moahrs/MMSJ300OS/root_sdcard.png

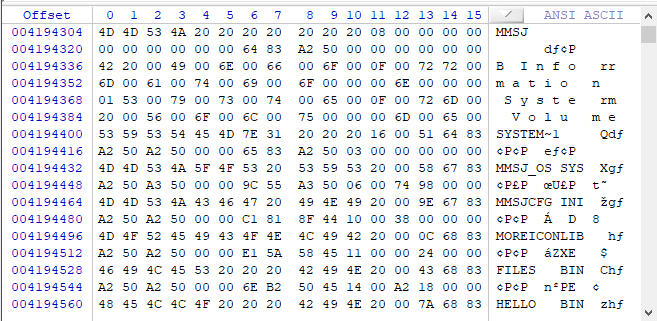
root_sdcard.png
