moahrs/MMSJ300OS/utility.bmp

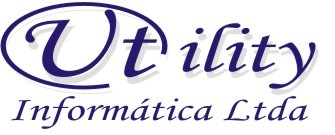
utility.bmp
