moahrs/MMSJ300OS/diptrace/DipTrace_Schematic_MMSJ300B_CPU_MEM_PERIF_V2_Page1.pdf

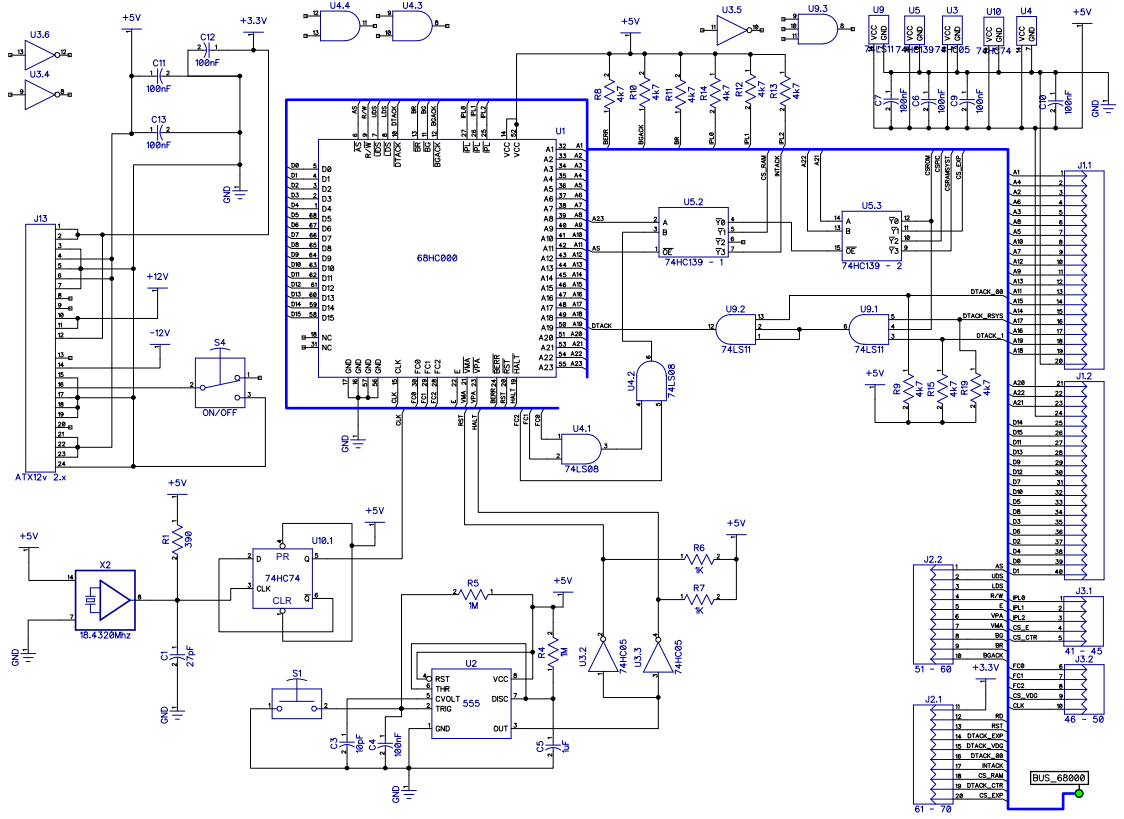
[picture p3: page 1]
CLR
