moahrs/MMSJ300OS/diptrace/DipTrace_Schematic_MMSJ300B_CPU_MEM_PERIF_V2_Page2.pdf

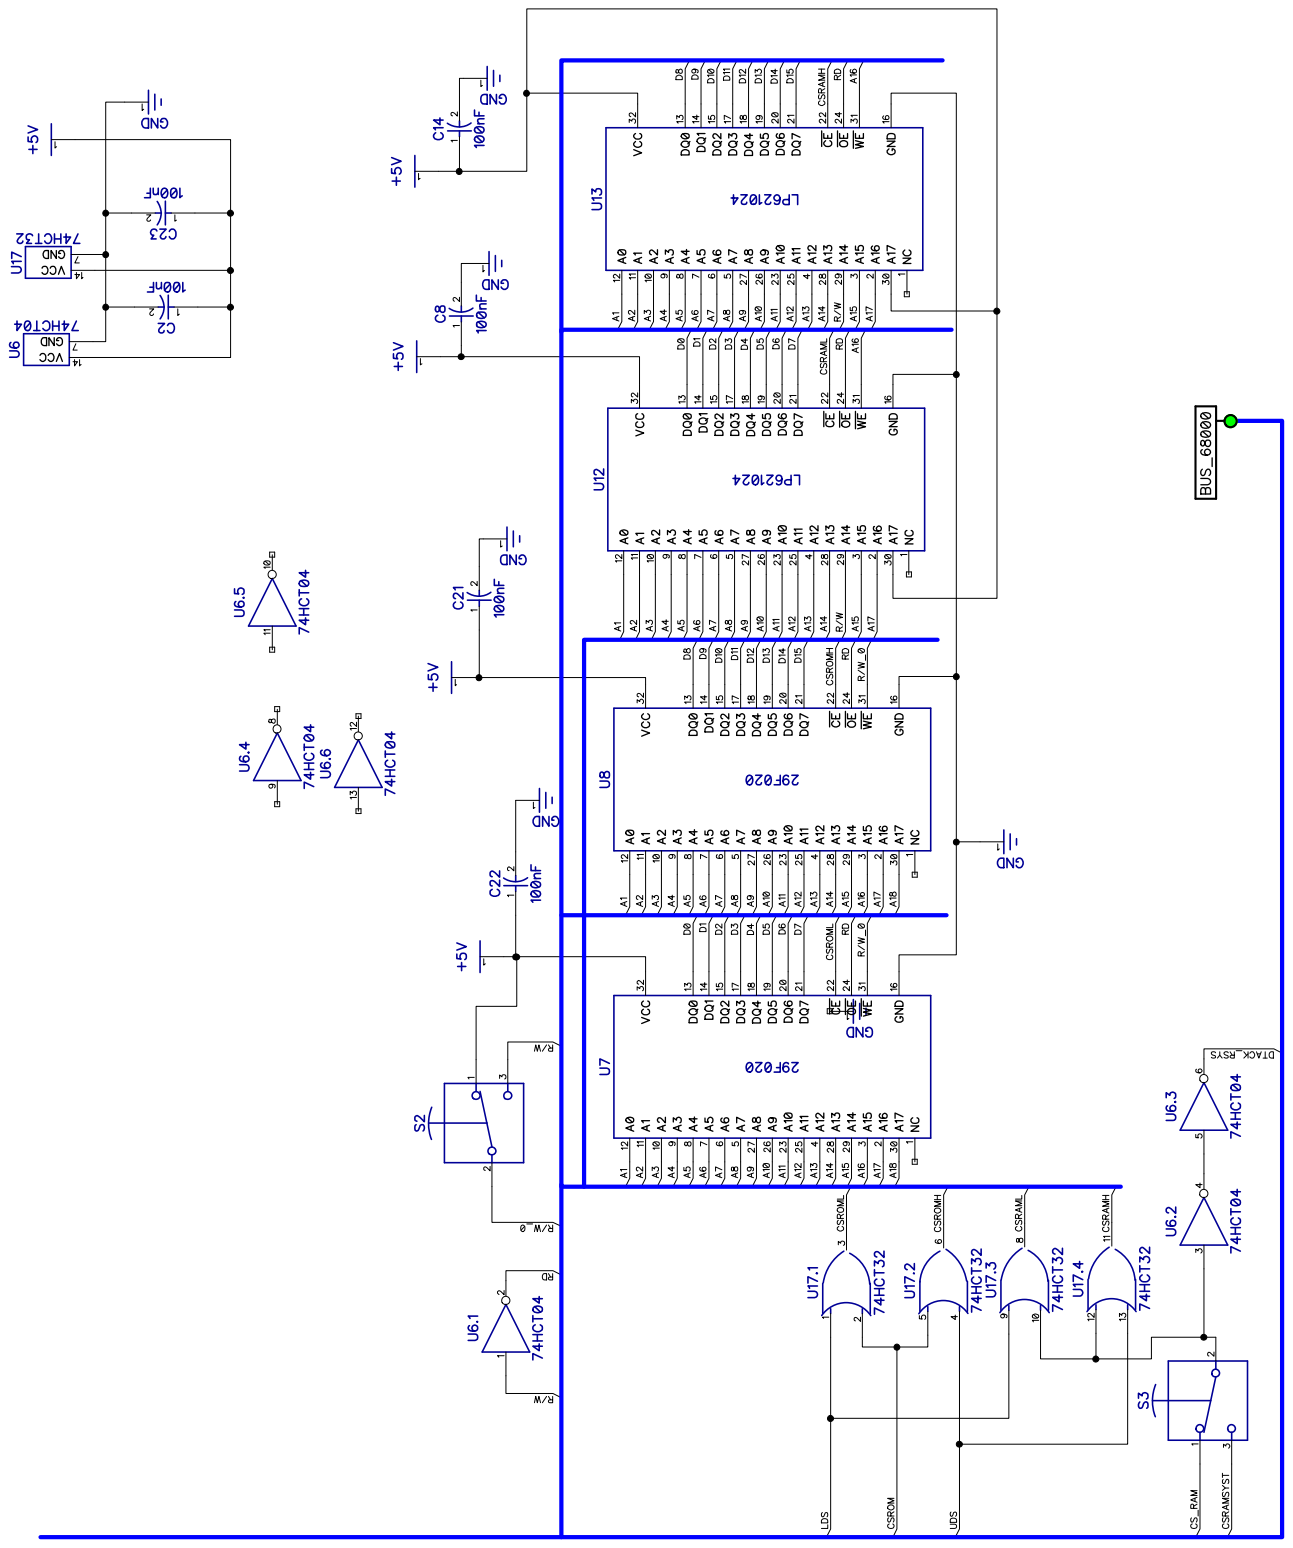
[picture p4: page 1]
