moahrs/MMSJ300OS/diptrace/DipTrace_Schematic_MMSJ300B_PERIF_V2_Page1.pdf

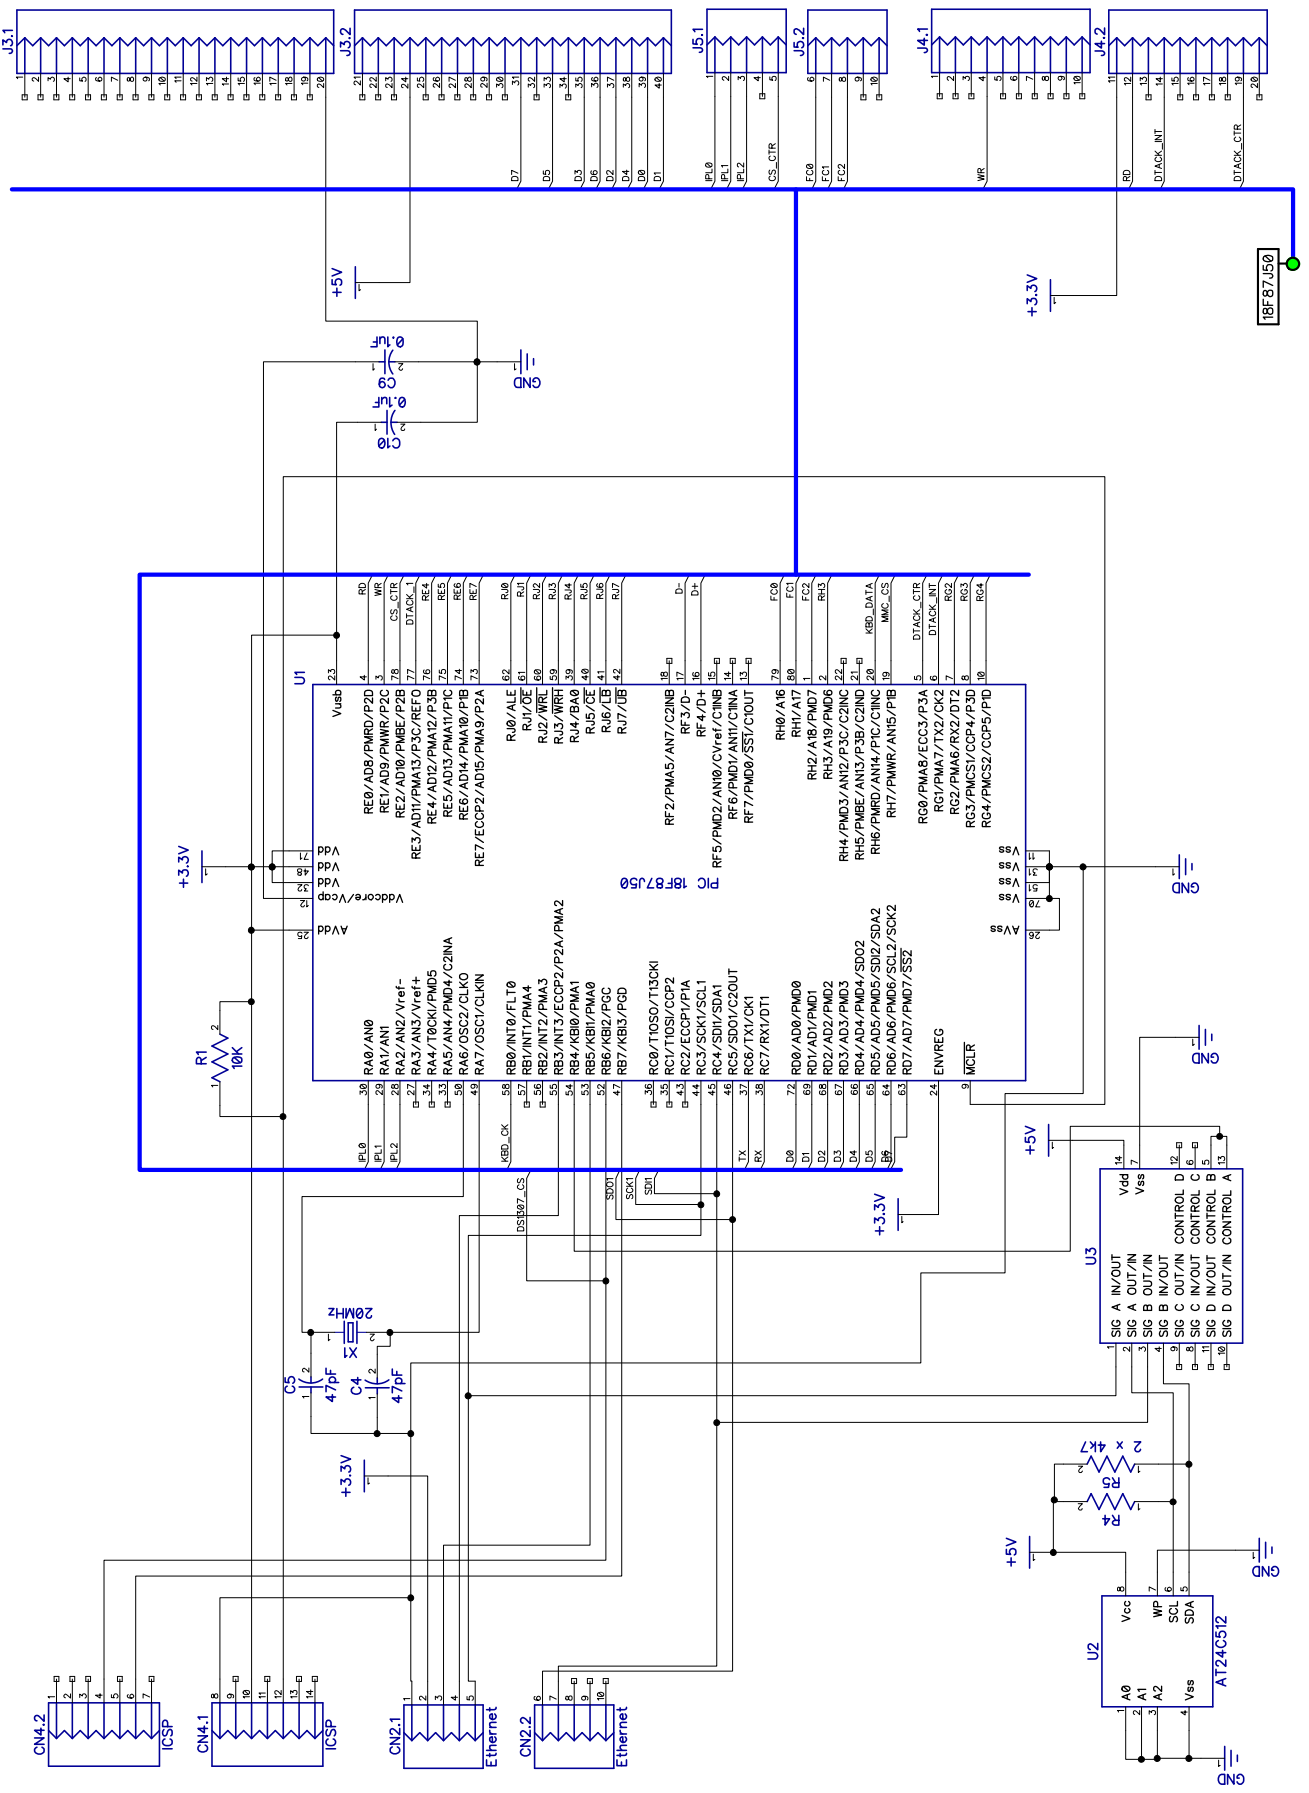
[picture p6: page 1]
