moahrs/MMSJ300OS/diptrace/DipTrace_Schematic_MMSJ300B_PERIF_V2_Page2.pdf

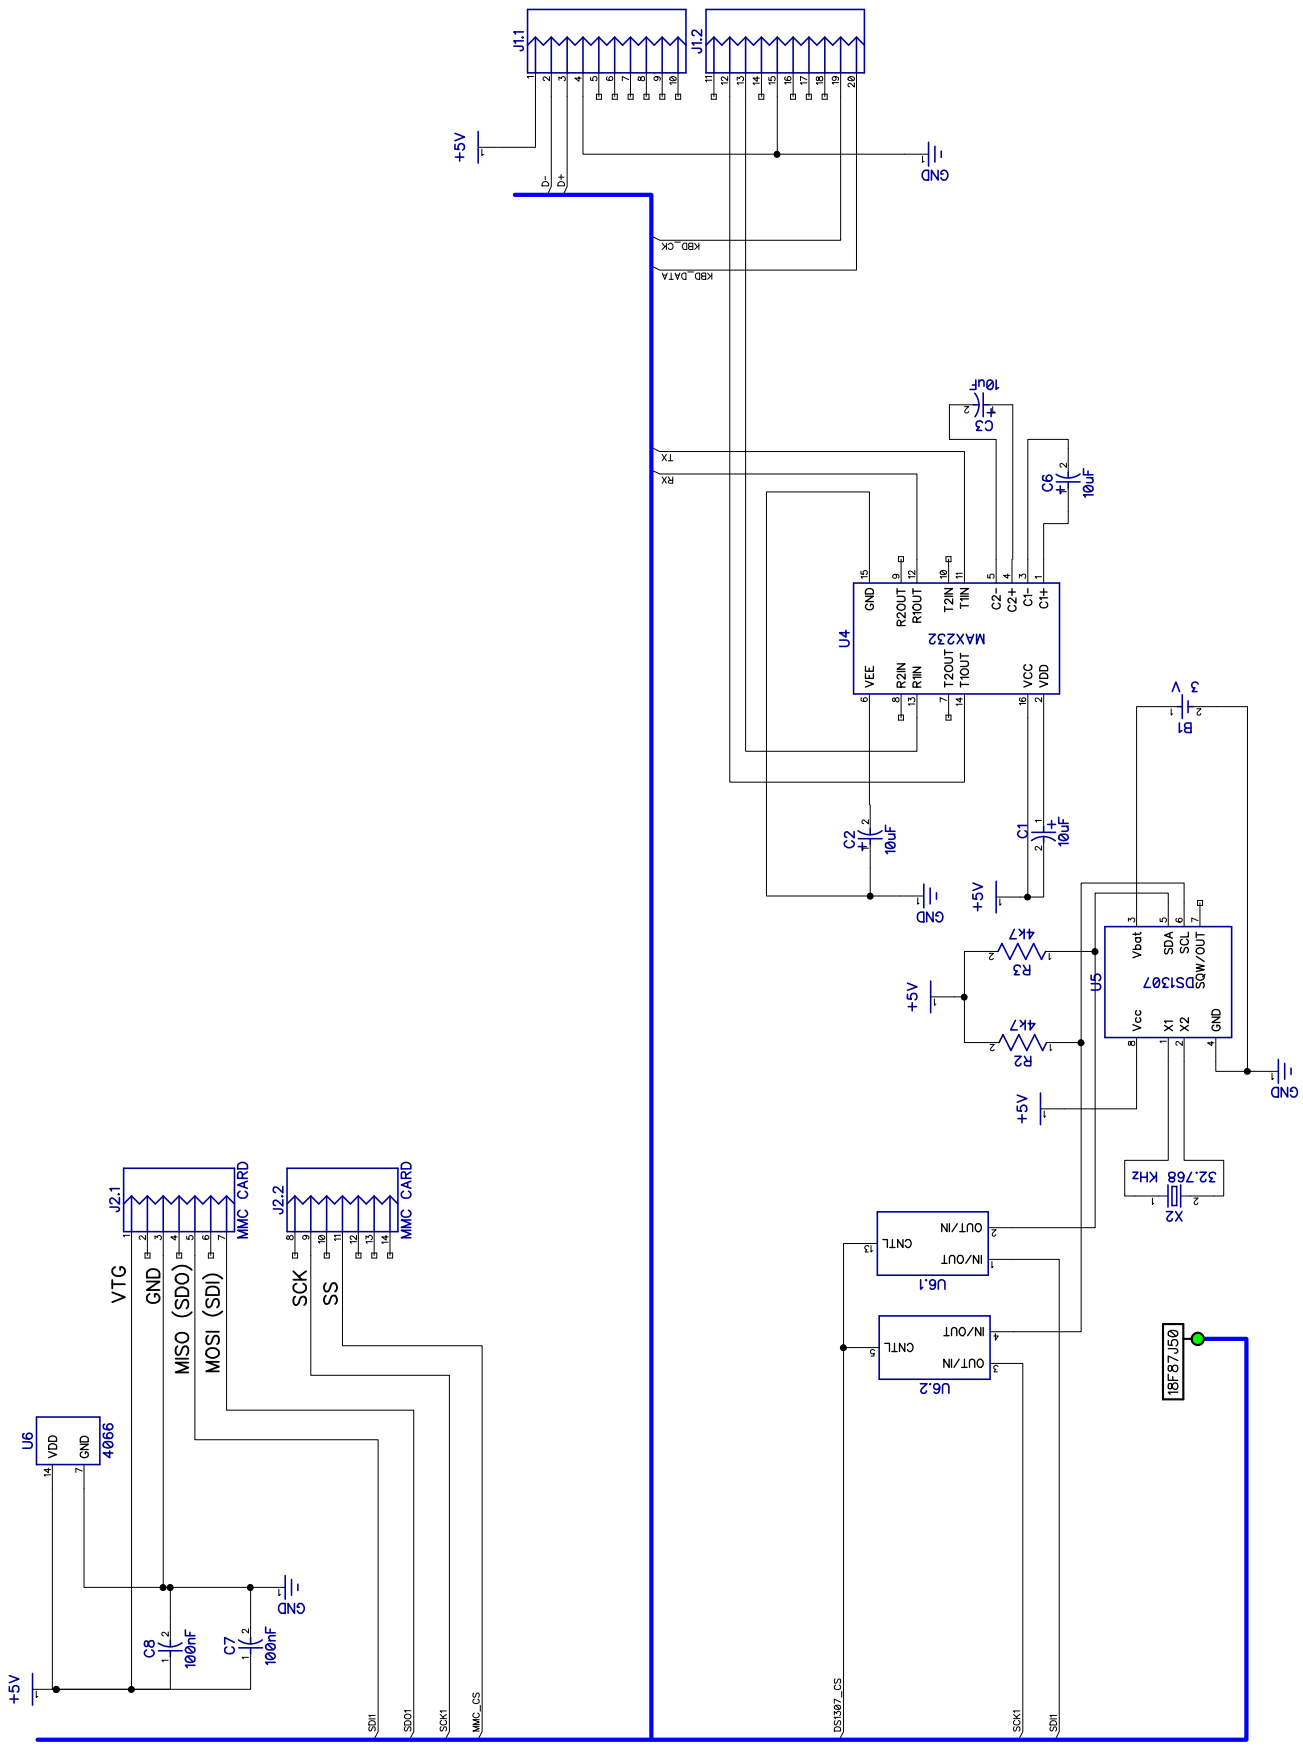
[picture p7: page 1]
