moahrs/MMSJ300OS/diptrace/DipTrace_Schematic_MMSJ300B_VDG_4550.pdf

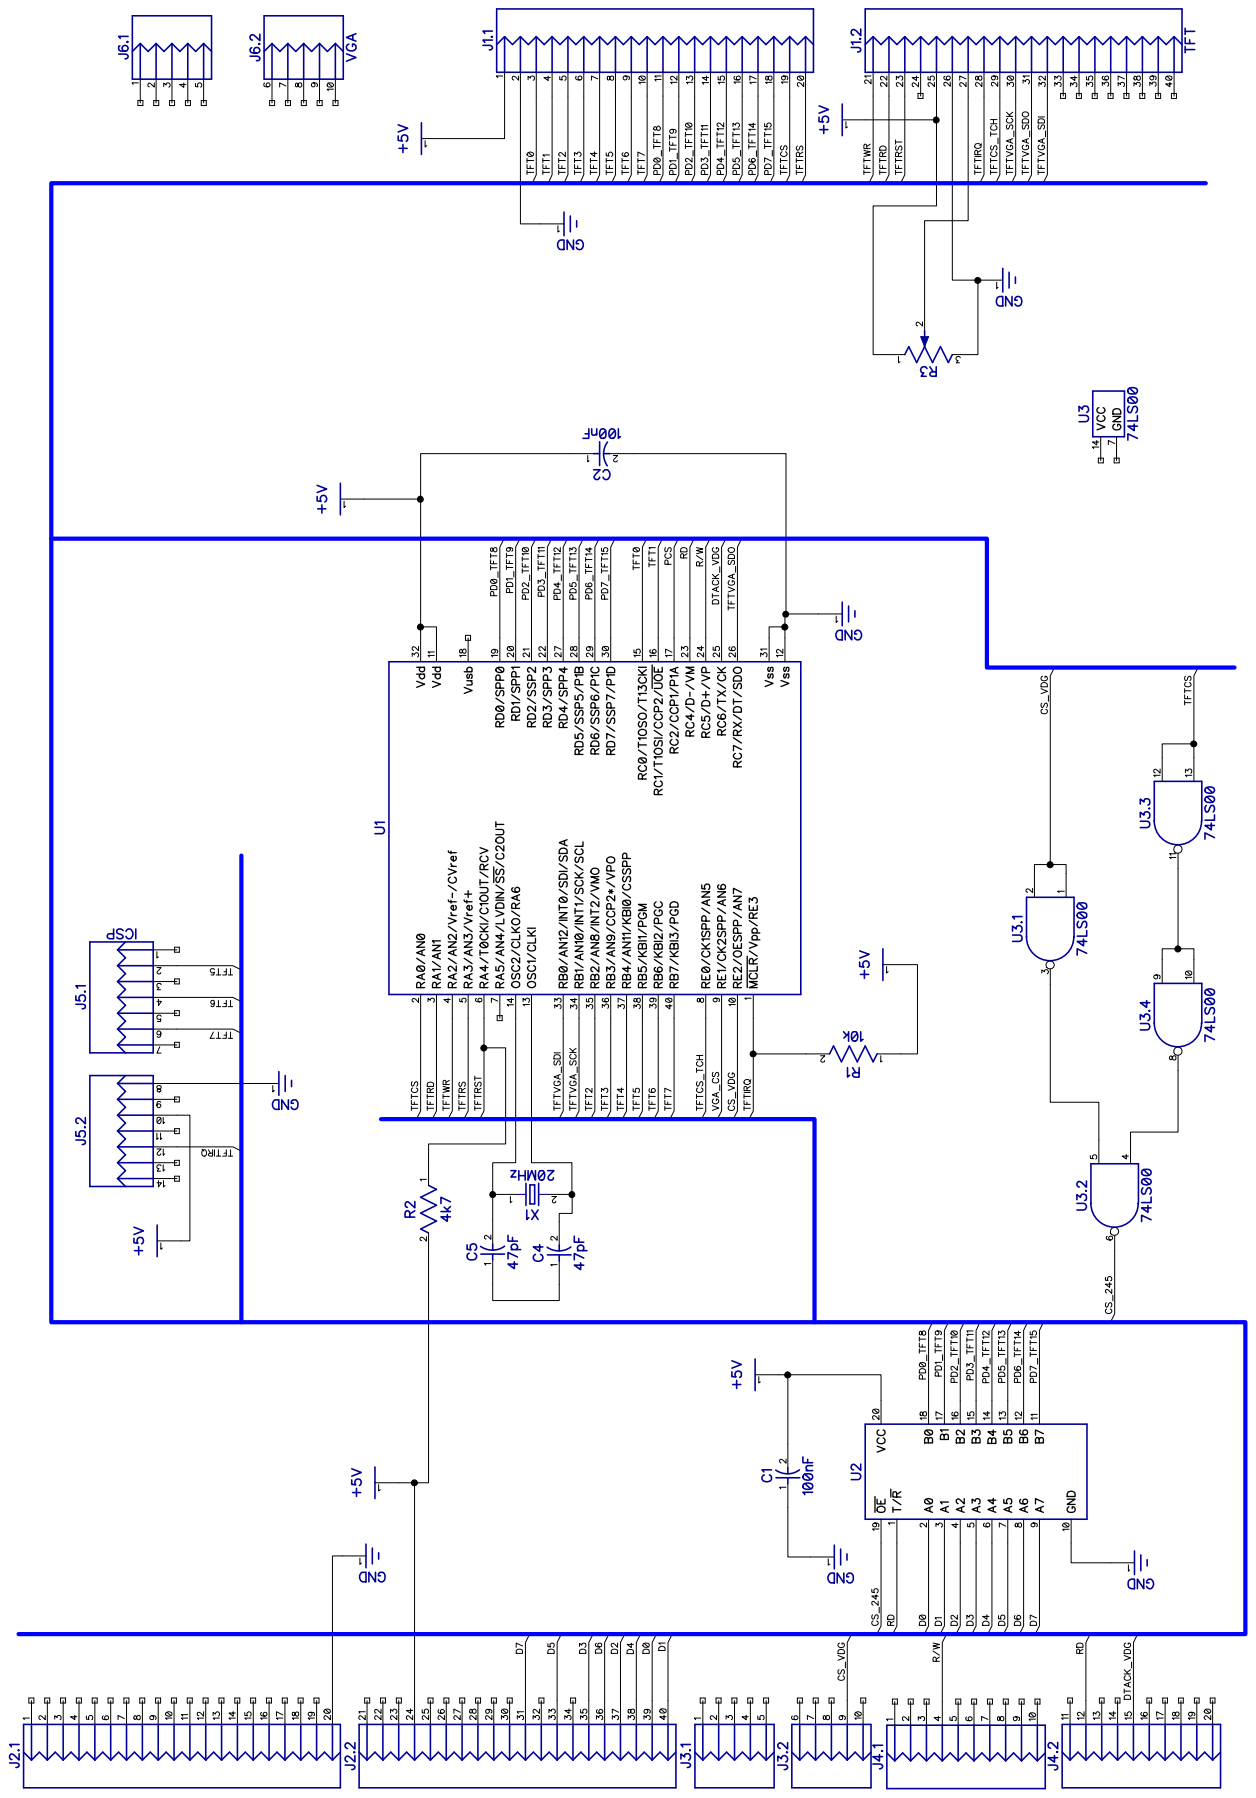
[picture p8: page 1]
