moahrs/MMSJ300OS/diptrace/GRAVADOR_FLASH_EEPROM_SERIAL.pdf

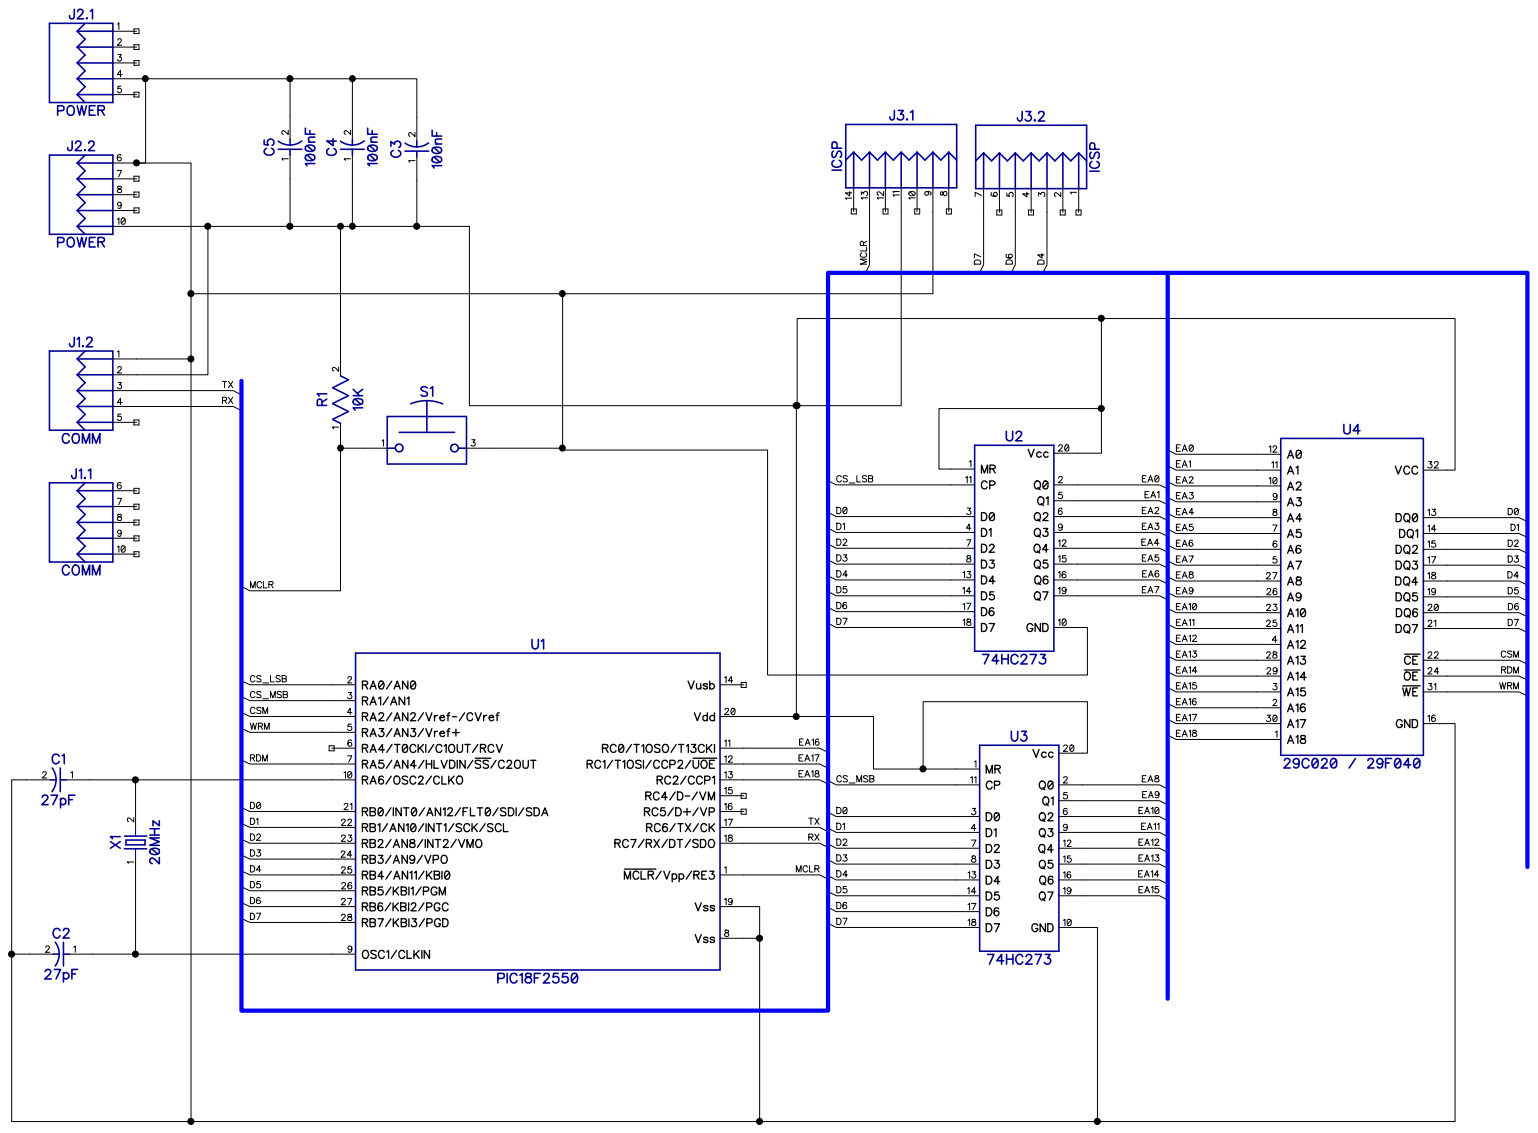
[picture p9: page 1]
