moahrs/MMSJ300OS/diptrace/MMSJ300B_MEM_RAM_DYNAMIC.pdf

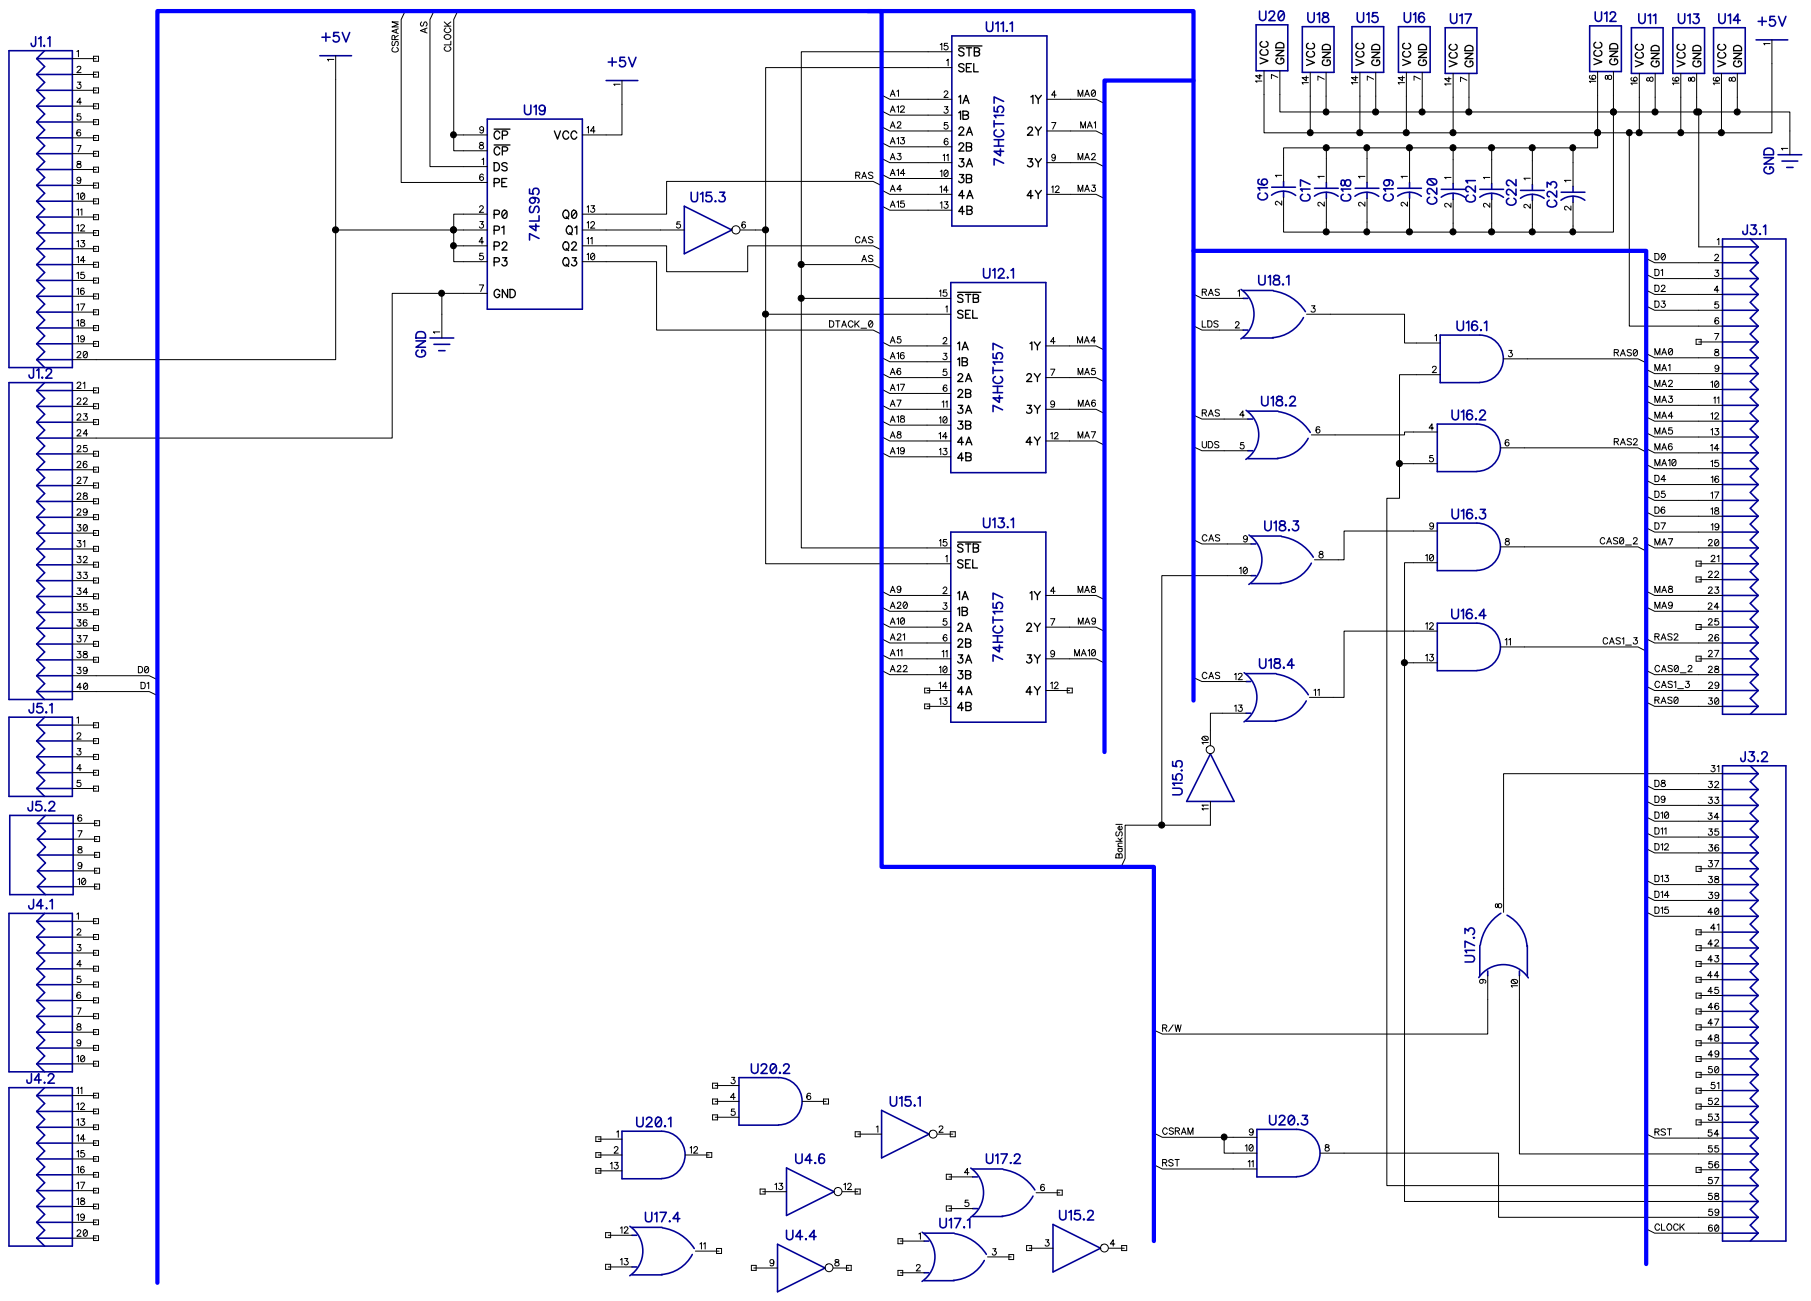
[picture p10: page 1]
