moahrs/MMSJ300OS/diptrace/MMSJ300B_PERIF_COMM.pdf

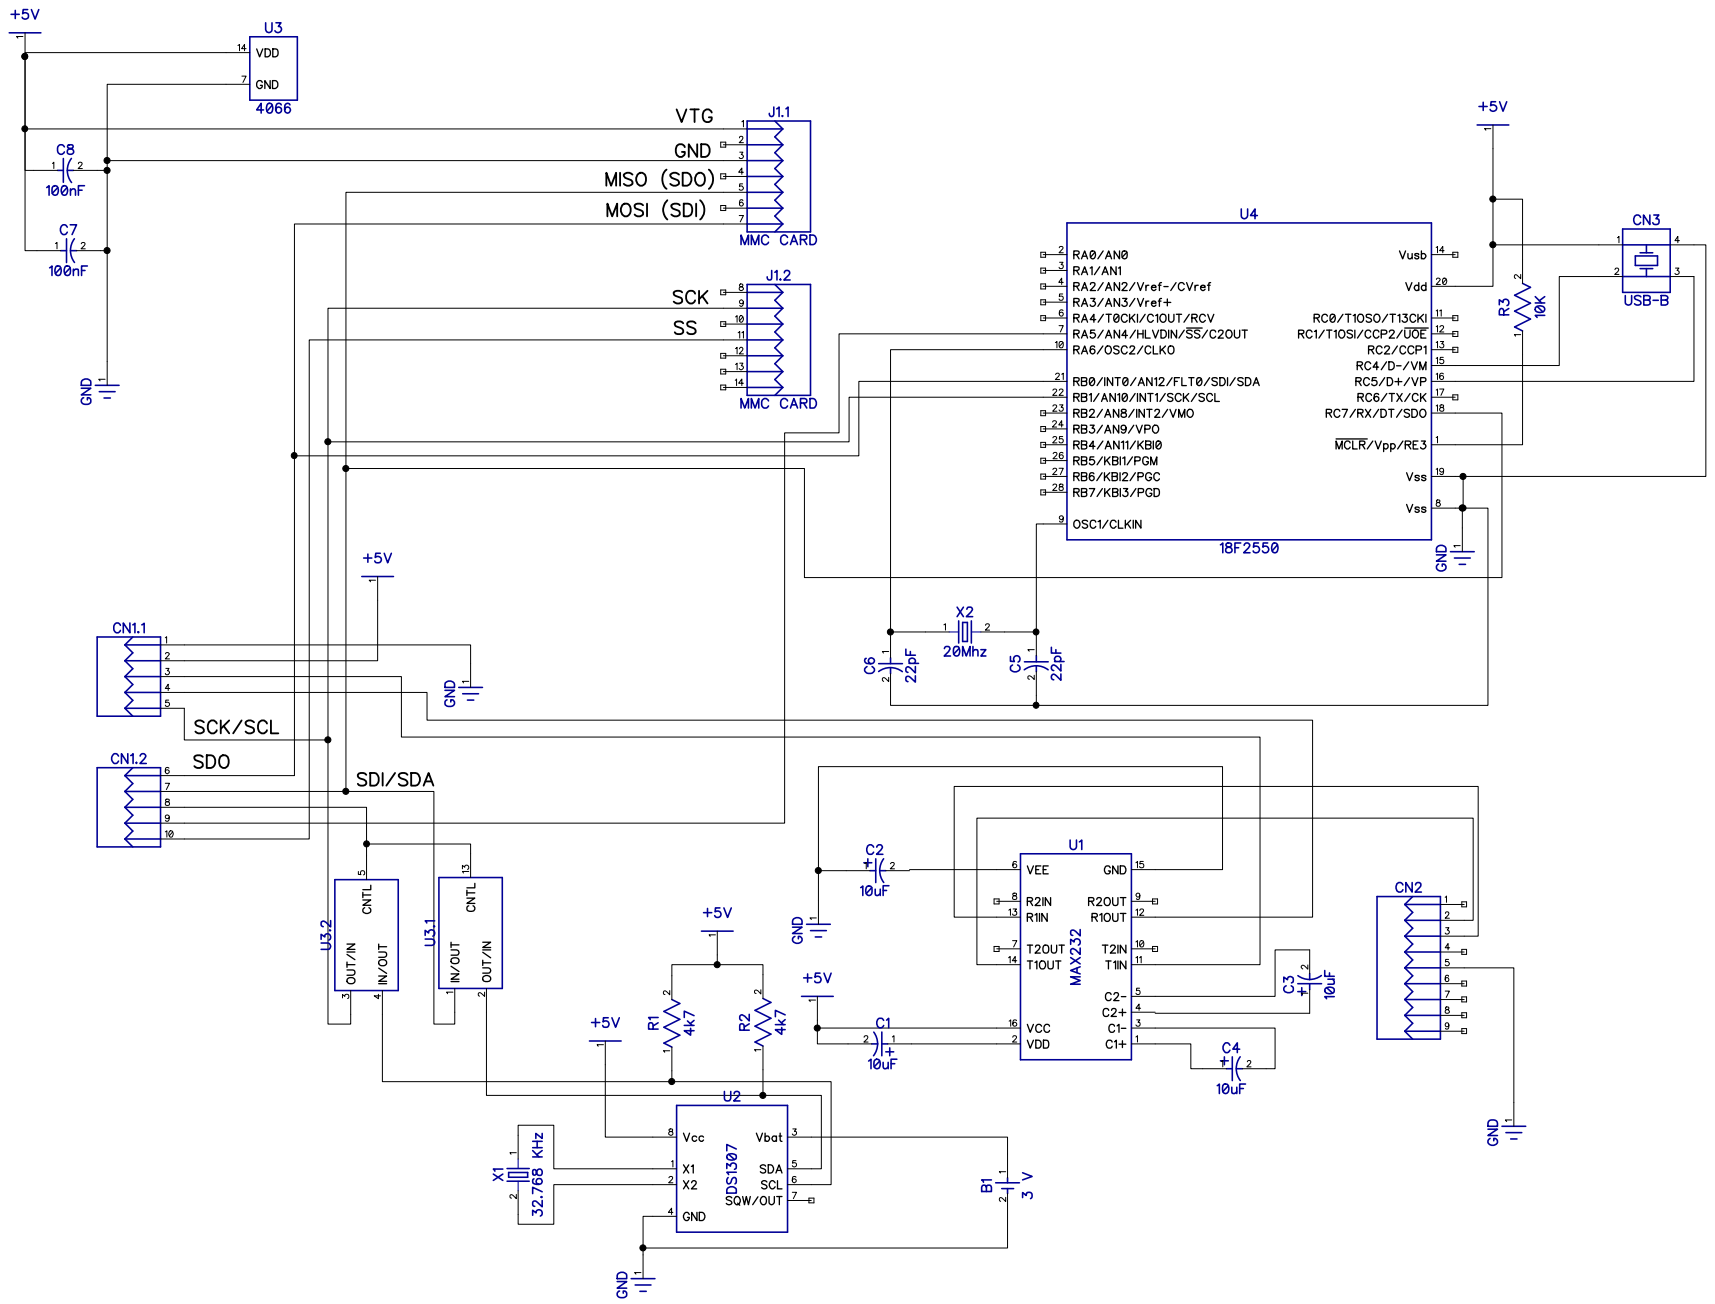
[picture p11: page 1]
