moahrs/MMSJ300OS/diptrace/MMSJ300B_PERIF_VDG.pdf

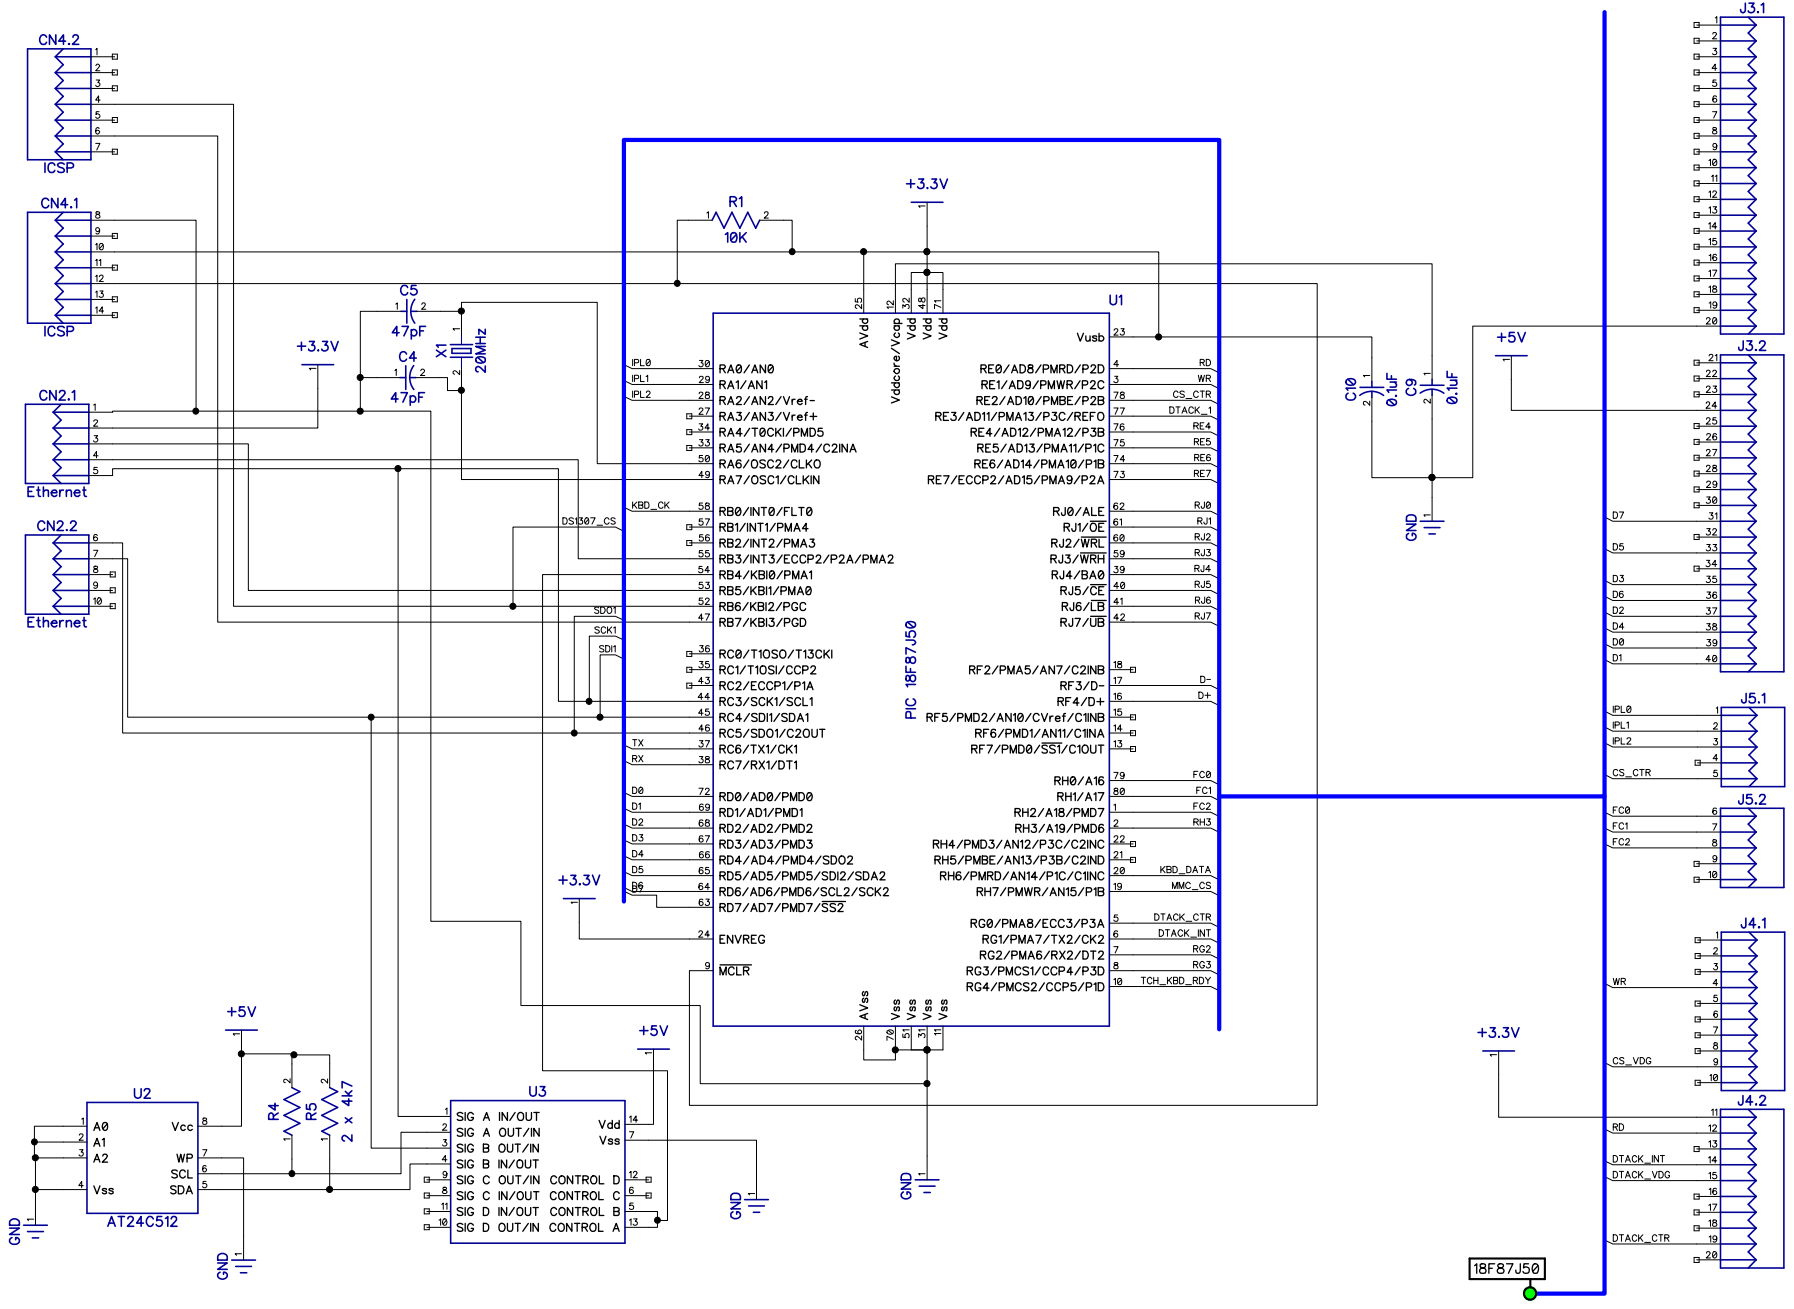
[picture p12: page 1]

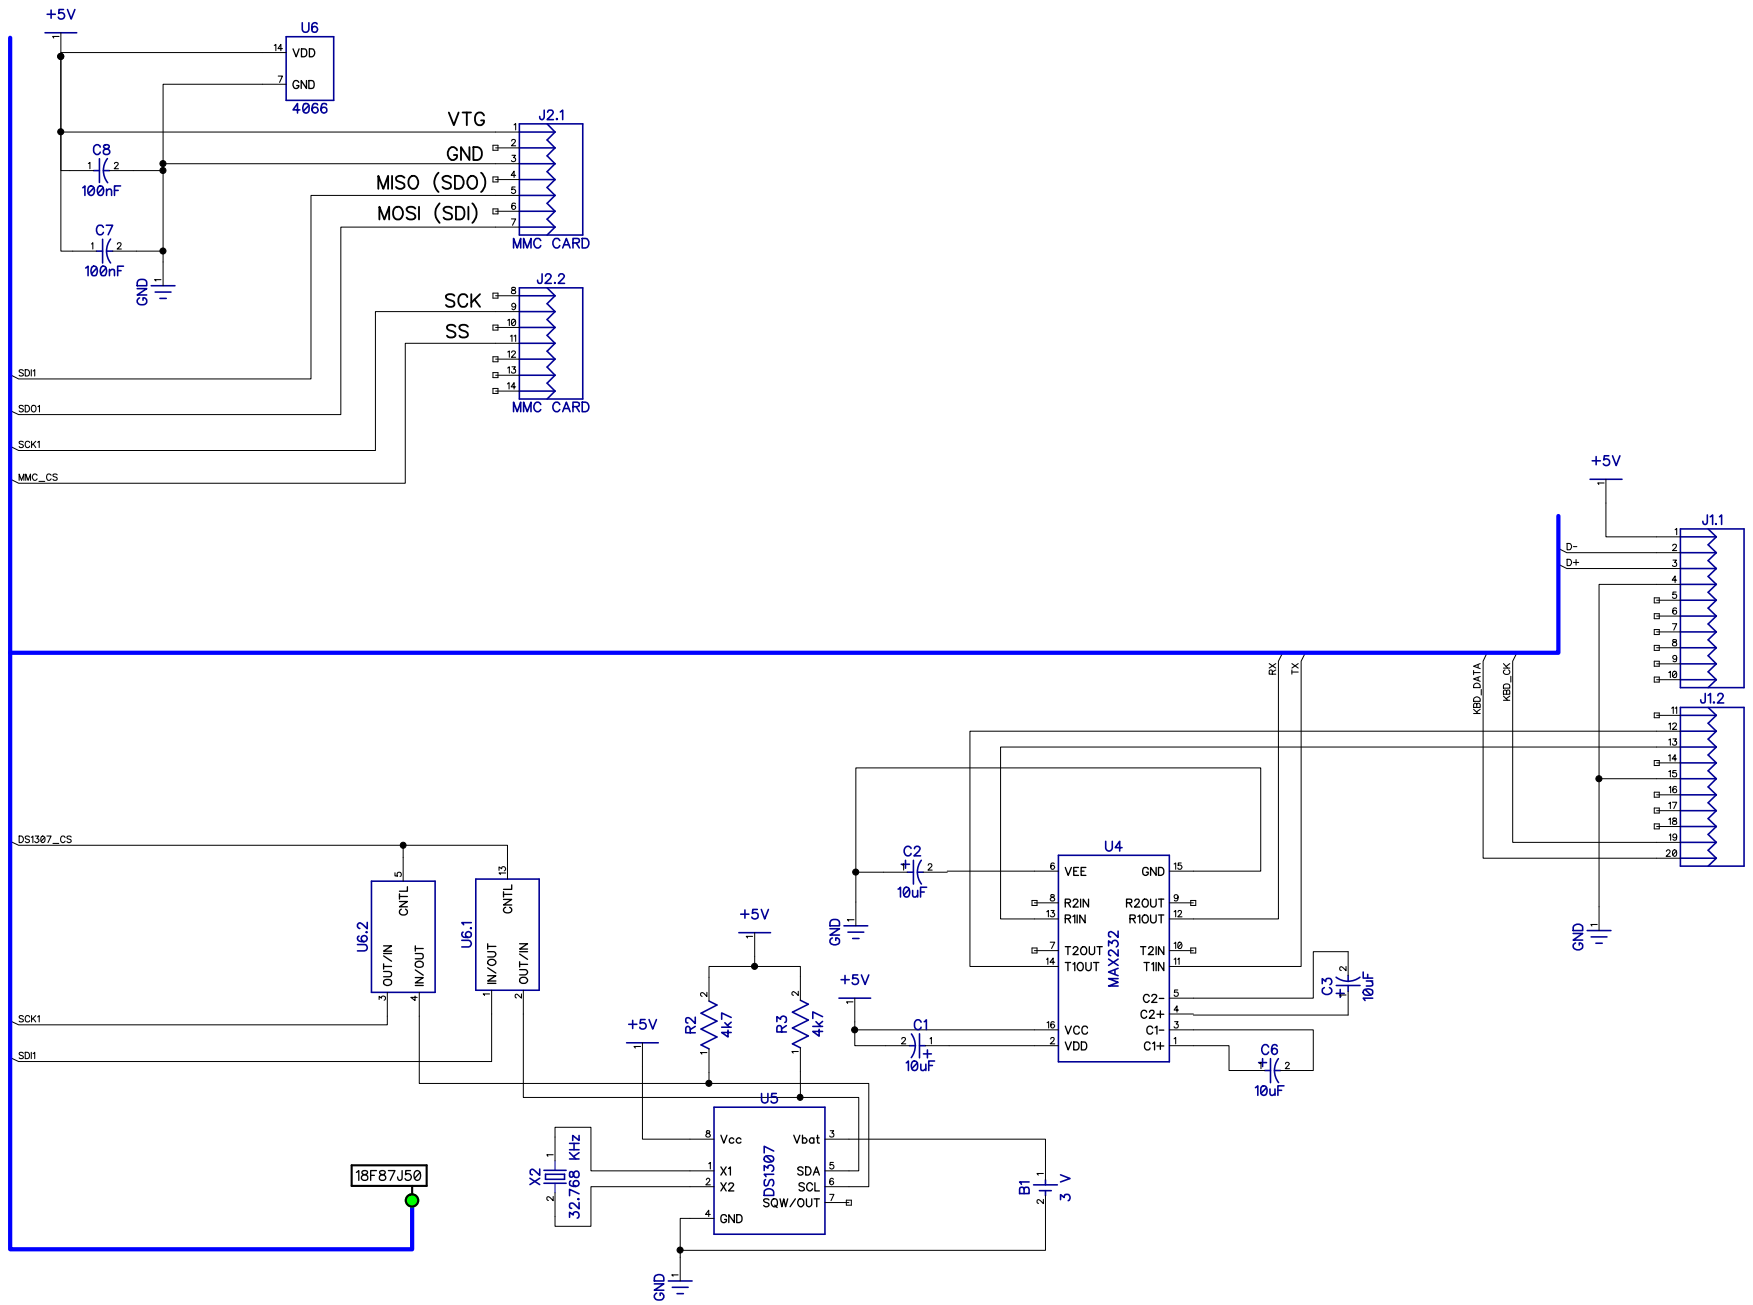
[picture p13: page 2]

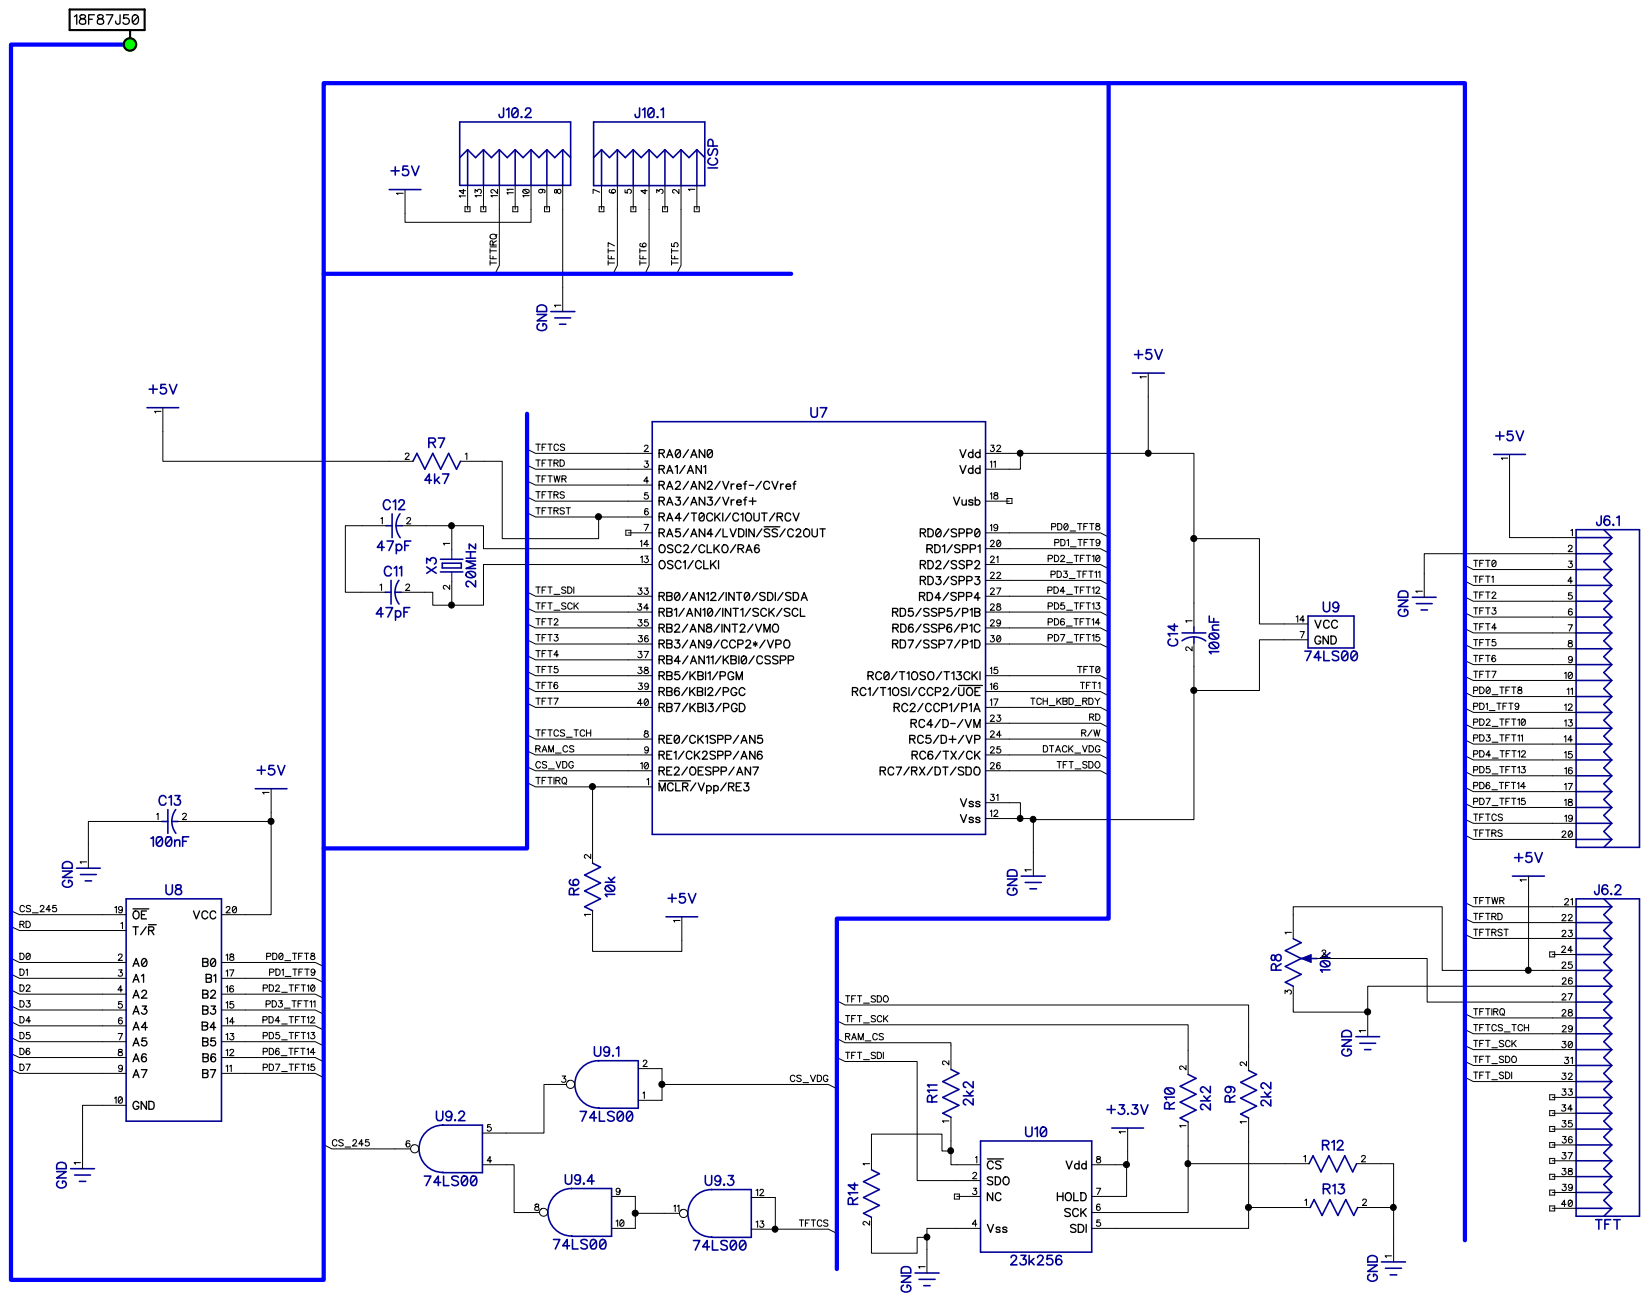
[picture p14: page 3]
