moahrs/MMSJ300OS/(list of files, drawings)

Other design files:
diptrace/GRAVADOR_FLASH_EEPROM_SERIAL.dch
diptrace/GRAVADOR_FLASH_EEPROM_SERIAL.dip
diptrace/MMSJ300_COMM.dch
diptrace/MMSJ300_CPU_MEM.dch
diptrace/MMSJ300_CPU_MEM.dip
diptrace/MMSJ300_CPU_MEM_2.dip
diptrace/MMSJ300_PERIF.dch
diptrace/MMSJ300A_CPU.dch
diptrace/MMSJ300A_MEM_RAM_STATIC.dch
diptrace/MMSJ300A_MEM_ROM.dch
diptrace/MMSJ300A_PERIF.dch
diptrace/MMSJ300B_CPU_MEM_PERIF.dch
diptrace/MMSJ300B_CPU_MEM_PERIF.dip
diptrace/MMSJ300B_CPU_MEM_PERIF_V2.dch
diptrace/MMSJ300B_MEM_RAM_DYNAMIC.dch
diptrace/MMSJ300B_MEM_RAM_DYNAMIC.dip
diptrace/MMSJ300B_PERIF.dch
diptrace/MMSJ300B_PERIF_COMM.dch
diptrace/MMSJ300B_PERIF_V2.dch
diptrace/MMSJ300B_PERIF_V2_duplaface.dip
diptrace/MMSJ300B_PERIF_V2_duplaface_87j50.dip
diptrace/MMSJ300B_PERIF_V2_duplaface_8722.dip
diptrace/MMSJ300B_PERIF_V2_simplesface.dip
diptrace/MMSJ300B_PERIF_VDG.dch
diptrace/MMSJ300B_PERIF_VDP_6847.dch
diptrace/MMSJ300B_PERIF_VDP_6847.dip
diptrace/MMSJ300B_PERIF_VDP_6847_SFace.dip
diptrace/MMSJ300B_PERIF_VDP_6847_V2.dch
diptrace/MMSJ300B_VDG_4550.dch
diptrace/MMSJ300B_VDG_4550_duplaface.dip
diptrace/MMSJ300B_VDG_4550_simplesface.dip
diptrace/OLD/MMSJ300_CPU_MEM.dch
diptrace/OLD/MMSJ300_CPU_MEM.dip
diptrace/OLD/MMSJ300_CPU_MEM_2.dip
diptrace/OLD/MMSJ300_PERIF.dch
diptrace/OLD/MMSJ300A_CPU.dch
diptrace/OLD/MMSJ300A_MEM_RAM_STATIC.dch
diptrace/OLD/MMSJ300A_MEM_ROM.dch
diptrace/OLD/MMSJ300A_PERIF.dch
diptrace/OLD/MMSJ300B_CPU.dch
diptrace/OLD/MMSJ300B_CPU_MEM_PERIF.dip
diptrace/OLD/MMSJ300B_MEM_RAM_STATIC.dch
diptrace/OLD/MMSJ300B_MEM_ROM.dch
diptrace/TrabElet2.dch
diptrace/TrabElet2.dip
