moahrs/MMSJ300OS/monitor.c

/********************************************************************************
*    Programa    : monitor.c
*    Objetivo    : BIOS do modulo MMSJ300 - Versao vintage compatible
*    Criado em   : 17/09/2022
*    Programador : Moacir Jr.
*--------------------------------------------------------------------------------
* Data        Versao  Responsavel  Motivo
* 17/09/2022  0.1     Moacir Jr.   Criacao Versao Beta
*                                  512KB EEPROM + 256KB RAM BUFFER + 8MB RAM USU
* 12/11/2023  0.2     Moacir Jr.   Adaptacao do MC68901 p/ serial e interrupcoes
* 01/06/2023  0.3     Moacir Jr.   Adaptacao do teclado PS/2 via arduino nano
*                                  Simulando um FPGA de epoca
* 22/06/2023  0.4     Moacir Jr.   Adaptacao do TMS9118 VDP
* 23/06/2023  0.4a    Moacir Jr.   Adaptacao lib arduino tms9918 pro mmsj300
* 15/07/2023  0.4b    Moacir Jr.   Colocar tela vermelha de erros
* 15/07/2023  0.4c    Moacir Jr.   Colocar rotina de trace
* 18/07/2023  0.4d    Moacir Jr.   Verificar e Ajustar Problema no G2 do VDP
* 19/07/2023  1.0     Moacir Jr.   Versao para publicacao
* 20/07/2023  1.0a    Moacir Jr.   Ajuste de bugs
* 21/07/2023  1.1     Moacir Jr.   Adaptar Basic ao monitor
* 25/07/2023  1.1a    Moacir Jr.   Ajustes no inputLine, aceitar tipo '@'
* 20/01/2024  1.1b    Moacir Jr.   Iniciar direto no basic... Ai com QUIT, volta pro monitor
*--------------------------------------------------------------------------------
*
* Mapa de Memoria
* ---------------
*
*     SLOT 0                          SLOT 1
* +-------------+ 000000h
* |   EEPROM    |
* |   512KB     |
* |   (BIOS)    | 07FFFFh
* +-------------+ 080000h
* |    LIVRE    | 1FFFFFh
* +-------------+ 200000h
* |             |
* |  EXPANSAO   |
* |             | 3FFFFFh
* +-------------+ 400000h
* |             |
* | PERIFERICOS |
* |             | 5FFFFFh
* +-------------+ 600000h
* |  RAM 256KB  |
* |  BUFFER E   |
* |  SISTEMA    | 63FFFFh
* +-------------+ 640000h
* |    LIVRE    | 7FFFFFh
* +-------------+ 800000h
* |             |
* |   ATUAL     |
* |    RAM      |
* |  USUARIO    |
* |    1MB      | 8FFFFFh
* +-------------+ 900000h
* |             |
* |             |
* |    RAM      |
* |  USUARIO    |
* |    7MB      |
* |             |
* |             |
* |             |
* |             |
* |             |
* |             |
* |             |
* |             |
* +-------------+ FFFFFFh
*--------------------------------------------------------------------------------
*
* Enderecos de Perifericos
*
* 00400020h a 0040003F - MFP MC68901p
*                        - SERIAL 9600, 8, 1, n
*                        - TECLADO (PC-AT - PS/2) via Arduino Nano
*                        - Controle de Interrupcoes e PS/2
* 00400040h a 00400043 - VIDEO TMS9118 (16KB VRAM):
*             00400041 - Data Mode
*             00400043 - Register / Adress Mode
********************************************************************************/

//#define __FS12__ 1

#include <ctype.h>
#include <string.h>
#include <stdlib.h>
#include "mmsj300api.h"
#include "monitor.h"

#ifdef __FS12__
#include "monitorf.h"
#endif

#define versionBios "1.1b"

//-----------------------------------------------------------------------------
// Principal
//-----------------------------------------------------------------------------
void main(void)
{
    unsigned short *xaddr = (unsigned short *) 0x00600000;
    unsigned short vbytepic = 0, xdado;
    unsigned int ix = 0, xcounter = 0;
    unsigned char sqtdtam[10], vRetInput;
    unsigned char vRamSyst1st = 1, vRamUser1st = 1;
    int vRetProcCmd;

    // Inicia com Basic
    *startBasic = 1;

    // Tempo para Inicializar a Memoria DRAM (se tiver), Perifericos e etc...
    for(ix = 0; ix <= 12000; ix++);

    //---------------------------------------------
    // Enviar setup para o MFP 68901
    //---------------------------------------------
    *vBufXmitEmpty = 1;

    // Setup Timers
    *(vmfp + Reg_TCDR)  = 0x02;
    *(vmfp + Reg_TDDR)  = 0x02;
    *(vmfp + Reg_TCDCR) = 0x11;

    // Setup Interruptions
    *(vmfp + Reg_VR)    = 0xA8; // vector = 0xA msb = 0x1010 and lsb = 0x1000 software end session interrupt
    *(vmfp + Reg_IERA)  = 0x00; // disable all at start
    *(vmfp + Reg_IERB)  = 0x00; // disable all at start
    *(vmfp + Reg_IMRA)  = 0x00; // disable all at start
    *(vmfp + Reg_IMRB)  = 0x00; // disable all at start
    *(vmfp + Reg_ISRA)  = 0x00; // disable all at start
    *(vmfp + Reg_ISRB)  = 0x00; // disable all at start

    // Setup Serial = 9600, 8, 1, n
    *(vmfp + Reg_UCR)   = 0x88;
    *(vmfp + Reg_RSR)   = 0x01;
    *(vmfp + Reg_TSR)   = 0x21;

    // Setup GPIO
    *(vmfp + Reg_DDR)   = 0x10; // I4 as Output, I7 - I5 e I3 - I0 as Input
    *(vmfp + Reg_AER)   = 0x00; // All Interrupts transction 1 to 0

    // Setup Interruptions
    *(vmfp + Reg_IERA)  = 0x00; // 0xCE; // serial interrupt (buffer full and empty) i7 = Fs vdp6847, I6 = Clock KeyBoard (clk pin OR DTRDY pin)
    *(vmfp + Reg_IERB)  = 0x00;
    *(vmfp + Reg_IMRA)  = 0x00; // 0xCE; // serial interrupt (buffer full and empty) i7 = Fs vdp6847, I6 = Clock KeyBoard (clk pin OR DTRDY pin)
    *(vmfp + Reg_IMRB)  = 0x00;
    //---------------------------------------------

    #ifdef __KEYPS2_EXT__
        *(vmfp + Reg_GPDR) |= 0x10;  // Seta CS = 1 (I4) do controlador
    #endif

    //---------------------------------------------
    // Enviar setup para o VDP TMS9118
    //---------------------------------------------
    // Definindo variaveis de video
    *videoCursorPosColX = 0;
    *videoCursorPosRowY = 0;
    *videoScroll = 1;       // Ativo
    *videoScrollDir = 1;    // Pra Cima
    *videoCursorBlink = 1;
    *videoCursorShow = 0;
    *vdpMaxCols = 39;
    *vdpMaxRows = 23;

    vdp_init_textmode(VDP_WHITE, VDP_BLACK);
    //---------------------------------------------

    // Zera Tudo (se tiver o que zerar), sem verificar, antes de testar
    xaddr = 0x00600000;
    while (xaddr <= 0x00FFFFFE)
    {
        *xaddr = 0x0000;
        xaddr += 32768;
    }

    // Testando memoria RAM de 64 em 64K Word pra saber quando tem
    xaddr = 0x00600000;
    xcounter = 0;
    while (xaddr <= 0x00FFFFFE) {
        // Se ja passou por esse endereco, cai fora - (caso de usar memoria de sistema como principal)
        xdado = *xaddr;

        if (xaddr < 0x00800000 && xdado == 0x5A4C && !vRamSyst1st)
        {
            xaddr = 0x00800000;
            continue;
        }
        else
        {
            if (xaddr >= 0x00800000 && xdado == 0x5A4C && !vRamUser1st)
                break;
        }

        // Testa Gravacao de 0000h
        *xaddr = 0x0000;
        for(ix = 0; ix <= 100; ix++);
        xdado = *xaddr;
        if (xdado != 0x0000)
        {
            if (xaddr < 0x00800000)
            {
                xaddr = 0x00800000;
                continue;
            }

            break;
        }

        // Testa Gravacao de FFFFh
        *xaddr = 0xFFFF;
        for(ix = 0; ix <= 100; ix++);
        xdado = *xaddr;
        if (xdado != 0xFFFF)
        {
            if (xaddr < 0x00800000)
            {
                xaddr = 0x00800000;
                continue;
            }

            break;
        }

        // Se tudo ok, deixa gravado 0x5A4C para nao ler novamente - (caso de usar memoria de sistema como principal)
        *xaddr = 0x5A4C;

        if (xaddr < 0x00800000)
            vRamSyst1st = 0;
        else
            vRamUser1st = 0;

        xcounter += 64; // dobrar a soma para aparecer em bytes e nao em words

        // Limite maximo de contagem, 8MB
        if (xcounter >= 8448)
            break;

        xaddr += 32768;
    }

    *vtotmem = xcounter;

    *(vmfp + Reg_GPDR) = 0x00;

    clearScr();
    printText("MMSJ-300 BIOS v"versionBios);
    printText("\r\n\0");

    #ifdef __FS12__
    fsInit();
    #endif

    printText("Utility (c) 2014-2024\r\n\0");

    itoa(xcounter, sqtdtam, 10);
    printText(sqtdtam);
    printText("K Bytes Found. ");
    xcounter = xcounter - 256;
    itoa(xcounter, sqtdtam, 10);
    printText(sqtdtam);
    printText("K Bytes Free.\r\n\0");

    if (!*startBasic)
    {
        printText("OK\r\n\0");
        printText(">");
    }

    showCursor();

    *vBufReceived = 0x00;
    *vbuf = '\0';

    #if defined(__KEYPS2__) || defined(__KEYPS2_EXT__)
        *kbdvprim = 1;
        *kbdvshift = 0;
        *kbdvctrl = 0;
        *kbdvalt = 0;
        *kbdvcaps = 0;
        *kbdvnum = 0;
        *kbdvscr = 0;
        *kbdvreleased = 0x00;
        *kbdve0 = 0;
        *kbdClockCount = 0;
        *kbdScanCodeCount = 0;
        *kbdKeyBuffer = 0x00;
        *scanCode = 0;
        *kbdKeyPntr = 0;

        // Ativando Interrupcao de Kbd PS/2
        *(vmfp + Reg_IERA) |= 0x40; // GPI6 will be PS2 interrupt (clk pin OR DTRDY pin)
        *(vmfp + Reg_IMRA) |= 0x40; // GPI6 will be PS2 interrupt (clk pin OR DTRDY pin)
    #endif

    while (1)
    {
        if (*startBasic)
        {
            runBas();
            *startBasic = 0;
            *vbuf = 0x00;
            printText("\r\n\0");
            printChar('>', 1);
        }

        vRetInput = inputLine(128,'$');

        if (*vbuf != 0x00 && (vRetInput == 0x0D || vRetInput == 0x0A))
        {
            vRetProcCmd = 1;

            printText("\r\n\0");

            vRetProcCmd = processCmd();

            *vBufReceived = 0x00;
            *vbuf = '\0';

            if (vRetProcCmd)
                printText("\r\n\0");

            printChar('>', 1);
        }
        else if (vRetInput != 0x1B)
        {
            printText("\r\n\0");
            printChar('>', 1);
        }
    }
}

//-----------------------------------------------------------------------------
// pQtdInput - Quantidade a ser digitada, min 1 max 255
// pTipo - Tipo de entrada:
//                  input : $ - String, % - Inteiro (sem ponto), # - Real (com ponto), @ - Sem Cursor e Qualquer Coisa e sem enter
//                   edit : S - String, I - Inteiro (sem ponto), R - Real (com ponto)
//-----------------------------------------------------------------------------
unsigned char inputLine(unsigned int pQtdInput, unsigned char pTipo)
{
    unsigned char *vbufptr = vbuf;
    unsigned char vtec, vtecant;
    int vRetProcCmd, iw, ix;
    int countCursor = 0;
    char pEdit = 0, pIns = 0, vbuftemp, vbuftemp2;
    int iPos, iz;
    unsigned short vantX, vantY;

    if (pQtdInput == 0)
        pQtdInput = 512;

    vtecant = 0x00;
    vbufptr = vbuf;

    // Se for Linha editavel apresenta a linha na tela
    if (pTipo == 'S' || pTipo == 'I' || pTipo == 'R')
    {
        // Apresenta a linha na tela, e posiciona o cursor na tela na primeira posicao valida
        iw = strlen(vbuf) / 40;

        printText(vbuf);

        *videoCursorPosRowY -= iw;
        *videoCursorPosColX = 0;
        pEdit = 1;
        iPos = 0;
        pIns = 0xFF;

        vdp_set_cursor(*videoCursorPosColX, *videoCursorPosRowY);
    }

    if (pTipo != '@')
        showCursor();

    while (1)
    {
        // Piscar Cursor
        if (*videoCursorBlink && pTipo != '@')
        {
            switch (countCursor)
            {
                case 6000:
                    hideCursor();
                    if (pEdit)
                        printChar(vbuf[iPos],0);
                    break;
                case 12000:
                    showCursor();
                    countCursor = 0;
                    break;
            }
            countCursor++;
        }

        // Inicia leitura
        *vBufReceived = 0x00;

        readChar();

        vtec = *vBufReceived;

        if (pTipo == '@')
            return vtec;

        // Se nao for string ($ e S) ou Tudo (@), só aceita numeros
        if (pTipo != '$' && pTipo != 'S' && pTipo != '@' && vtec != '.' && vtec > 0x1F && (vtec < 0x30 || vtec > 0x39))
            vtec = 0;

        // So aceita ponto de for numero real (# ou R) ou string ($ ou S) ou tudo (@)
        if (vtec == '.' && pTipo != '#' && pTipo != '$' &&  pTipo != 'R' && pTipo != 'S' && pTipo != '@')
            vtec = 0;

        if (vtec)
        {
            // Prevenir sujeira no buffer ou repeticao
            if (vtec == vtecant)
            {
                if (countCursor % 300 != 0)
                    continue;
            }

            if (pTipo != '@')
            {
                hideCursor();

                if (pEdit)
                    printChar(vbuf[iPos],0);
            }

            vtecant = vtec;

            if (vtec >= 0x20 && vtec != 0x7F)   // Caracter Printavel menos o DELete
            {
                if (!pEdit)
                {
                    // Digitcao Normal
                    if (vbufptr > vbuf + pQtdInput)
                    {
                        *vbufptr--;

                        if (pTipo != '@')
                            printChar(0x08, 1);
                    }

                    if (pTipo != '@')
                        printChar(vtec, 1);

                    *vbufptr++ = vtec;
                    *vbufptr = '\0';
                }
                else
                {
                    iw = strlen(vbuf);

                    // Edicao de Linha
                    if (!pIns)
                    {
                        // Sem insercao de caracteres
                        if (iw < pQtdInput)
                        {
                            if (vbuf[iPos] == 0x00)
                                vbuf[iPos + 1] = 0x00;

                            vbuf[iPos] = vtec;

                            printChar(vbuf[iPos],0);
                        }
                    }
                    else
                    {
                        // Com insercao de caracteres
                        if ((iw + 1) <= pQtdInput)
                        {
                            // Copia todos os caracteres mais 1 pro final
                            vbuftemp2 = vbuf[iPos];
                            vbuftemp = vbuf[iPos + 1];
                            vantX = *videoCursorPosColX;
                            vantY = *videoCursorPosRowY;

                            printChar(vtec,1);

                            for (ix = iPos; ix <= iw ; ix++)
                            {
                                vbuf[ix + 1] = vbuftemp2;
                                vbuftemp2 = vbuftemp;
                                vbuftemp = vbuf[ix + 2];
                                printChar(vbuf[ix + 1],1);
                            }

                            vbuf[iw + 1] = 0x00;
                            vbuf[iPos] = vtec;

                            *videoCursorPosColX = vantX;
                            *videoCursorPosRowY = vantY;
                            vdp_set_cursor(*videoCursorPosColX, *videoCursorPosRowY);
                        }
                    }

                    if (iw <= pQtdInput)
                    {
                        iPos++;
                        *videoCursorPosColX = *videoCursorPosColX + 1;
                        vdp_set_cursor(*videoCursorPosColX, *videoCursorPosRowY);
                    }
                }
            }
            /*else if (pEdit && vtec == 0x11)    // UpArrow (17)
            {
                // TBD
            }
            else if (pEdit && vtec == 0x13)    // DownArrow (19)
            {
                // TBD
            }*/
            else if (pEdit && vtec == 0x12)    // LeftArrow (18)
            {
                if (iPos > 0)
                {
                    printChar(vbuf[iPos],0);
                    iPos--;
                    if (*videoCursorPosColX == 0)
                        *videoCursorPosColX = 255;
                    else
                        *videoCursorPosColX = *videoCursorPosColX - 1;
                    vdp_set_cursor(*videoCursorPosColX, *videoCursorPosRowY);
                }
            }
            else if (pEdit && vtec == 0x14)    // RightArrow (20)
            {
                if (iPos < strlen(vbuf))
                {
                    printChar(vbuf[iPos],0);
                    iPos++;
                    *videoCursorPosColX = *videoCursorPosColX + 1;
                    vdp_set_cursor(*videoCursorPosColX, *videoCursorPosRowY);
                }
            }
            else if (vtec == 0x15)  // Insert
            {
                pIns = ~pIns;
/*writeLongSerial("Aqui 332.666.1-[");
itoa(pIns,sqtdtam,16);
writeLongSerial(sqtdtam);
writeLongSerial("]\r\n");*/
            }
            else if (vtec == 0x08 && !pEdit)  // Backspace
            {
                // Digitcao Normal
                if (vbufptr > vbuf)
                {
                    *vbufptr--;
                    *vbufptr = 0x00;

                    if (pTipo != '@')
                        printChar(0x08, 1);
                }
            }
            else if ((vtec == 0x08 || vtec == 0x7F) && pEdit)  // Backspace
            {
                iw = strlen(vbuf);

                if ((vtec == 0x08 && iPos > 0) || vtec == 0x7F)
                {
                    if (vtec == 0x08)
                    {
                        iPos--;
                    
                        if (*videoCursorPosColX == 0)
                            *videoCursorPosColX = 255;
                        else
                            *videoCursorPosColX = *videoCursorPosColX - 1;
                        vdp_set_cursor(*videoCursorPosColX, *videoCursorPosRowY);
                    }
                    
                    vantX = *videoCursorPosColX;
                    vantY = *videoCursorPosRowY;

                    for (ix = iPos; ix < iw ; ix++)
                    {
                        vbuf[ix] = vbuf[ix + 1];
                        printChar(vbuf[ix],1);
                    }

                    vbuf[ix] = 0x00;

                    *videoCursorPosColX = vantX;
                    *videoCursorPosRowY = vantY;
                    vdp_set_cursor(*videoCursorPosColX, *videoCursorPosRowY);
                }
            }
            else if (vtec == 0x1B)   // ESC
            {
                // Limpa a linha, esvazia o buffer e retorna tecla
                while (vbufptr > vbuf)
                {
                    *vbufptr--;
                    *vbufptr = 0x00;

                    if (pTipo != '@')
                        hideCursor();

                    if (pTipo != '@')
                        printChar(0x08, 1);

                    if (pTipo != '@')
                        showCursor();
                }
                hideCursor();

                return vtec;
            }
            else if (vtec == 0x0D || vtec == 0x0A ) // CR ou LF
            {
                return vtec;
            }

            if (pTipo != '@')
                showCursor();
        }
        else
        {
            vtecant = 0x00;
        }
    }

    return 0x00;
}

//-----------------------------------------------------------------------------
int processCmd(void)
{
    unsigned char linhacomando[32], linhaarg[32], vloop;
    unsigned char *blin = vbuf;
    unsigned short varg = 0;
    unsigned short ix, iy, iz, ikk, izz;
    unsigned short vbytepic = 0, vrecfim;
    unsigned char sqtdtam[10], cuntam, vparam[32], vparam2[16], vparam3[16], vpicret, vresp;
    int vRet = 1;

    // Separar linha entre comando e argumento
    linhacomando[0] = '\0';
    linhaarg[0] = '\0';
    ix = 0;
    iy = 0;
    while (*blin)
    {
        if (!varg && *blin == 0x20)
        {
            varg = 0x01;
            linhacomando[ix] = '\0';
            iy = ix;
            ix = 0;
        }
        else
        {
            if (!varg)
                linhacomando[ix] = toupper(*blin);
            else
                linhaarg[ix] = toupper(*blin);
            ix++;
        }

        *blin++;
    }

    if (!varg)
    {
        linhacomando[ix] = '\0';
        iy = ix;
    }
    else
    {
        linhaarg[ix] = '\0';

        ikk = 0;
        iz = 0;
        izz = 0;
        varg = 0;
        while (ikk < ix)
        {
            if (linhaarg[ikk] == 0x20)
                varg++;
            else
            {
                if (!varg)
                    vparam[ikk] = linhaarg[ikk];
                else if (varg == 1)
                {
                    vparam2[iz] = linhaarg[ikk];
                    iz++;
                }
                else if (varg == 2)
                {
                    vparam3[izz] = linhaarg[ikk];
                    izz++;
                }
            }

            ikk++;
        }
    }

    vparam[ikk] = '\0';
    vparam2[iz] = '\0';
    vparam3[izz] = '\0';

    vpicret = 0;

    // Processar e definir o que fazer
    if (linhacomando[0] != 0)
    {
        if (!strcmp(linhacomando,"CLS") && iy == 3)
        {
            clearScr();
            vRet = 0;
        }
        else if (!strcmp(linhacomando,"CLEAR") && iy == 5)
        {
            clearScr();
            vRet = 0;
        }
        else if (!strcmp(linhacomando,"VER") && iy == 3)
        {
            printText("MMSJ-300 BIOS v"versionBios);

            #if defined(__FS12__)
            fsVer();
            #endif
        }
        else if (!strcmp(linhacomando,"LOAD") && iy == 4)
        {
            printText("Wait...\r\n\0");
            loadSerialToMem(linhaarg, 1);
        }
        else if (!strcmp(linhacomando,"RUN") && iy == 3)
        {
            runMem(linhaarg);
        }
        else if (!strcmp(linhacomando,"BASIC") && iy == 5)
        {
            runBasic(linhaarg);
        }
        else if (!strcmp(linhacomando,"MODE") && iy == 4)
        {
            modeVideo(vparam);
        }
        else if (!strcmp(linhacomando,"POKE") && iy == 4)
        {
            pokeMem(vparam, vparam2);
        }
        else if (!strcmp(linhacomando,"DUMP") && iy == 4)
        {
            dumpMem(vparam, vparam2, vparam3);
        }
        else if (!strcmp(linhacomando,"DUMPS") && iy == 5)
        {
            dumpMem2(vparam, vparam2);
        }
        else
        {
            vresp = 0;

            #if defined(__FS12__)
            fsOsCommand(linhacomando, ix, iy, linhaarg, vparam, vparam2, vparam3, &vresp);
            #endif

            if (!vresp)
                printText("Unknown Command !!!\r\n\0");
        }
    }

    return vRet;
}

//-----------------------------------------------------------------------------
void clearScr(void)
{
    unsigned int i;

    // Ler Linha
    setWriteAddress(*name_table);

    for (i = 0; i < 960; i++)
        *vvdgd = 0x00;

    *videoCursorPosColX = 0;
    *videoCursorPosRowY = 0;

    #ifdef __MON_SERIAL_VDG__
        writeLongSerial("\r\n\r\n\0");
        writeLongSerial("\033[2J");   // Clear Screeen
        writeLongSerial("\033[H");    // Cursor to Upper left corner
    #endif
}

//-----------------------------------------------------------------------------
void printChar(unsigned char pchr, unsigned char pmove)
{
    switch (pchr)
    {
        case 0x0A:  // LF
            *videoCursorPosRowY = *videoCursorPosRowY + 1;
            if (*videoCursorPosRowY == 24)
            {
                *videoCursorPosRowY = 23;
                geraScroll();
            }
            vdp_set_cursor(*videoCursorPosColX, *videoCursorPosRowY);
            break;
        case 0x0D:  // CR
            *videoCursorPosColX = 0;
            vdp_set_cursor(0, *videoCursorPosRowY);
            break;
        case 0x08:  // BackSpace
            if (*videoCursorPosColX > 0)
            {
                *videoCursorPosColX = *videoCursorPosColX - 1;
                vdp_set_cursor(*videoCursorPosColX, *videoCursorPosRowY);
            }
            break;
        case 0xFF:  // Cursor
            if (*videoCursorShow)
                vdp_write(0xFE);
            else
                vdp_write(0x20);
            break;
        default:
            vdp_write(pchr);
            vdp_colorize(*fgcolor, *bgcolor);
            if (pmove)
            {
                vdp_set_cursor_pos(VDP_CSR_RIGHT);

                if (*vdp_mode == VDP_MODE_TEXT && *videoCursorPosRowY == 24)
                {
                    *videoCursorPosRowY = 23;
                    geraScroll();
                }
            }
    }

    #ifdef __MON_SERIAL_VDG__
        writeSerial(pchr);
    #endif
}

//-----------------------------------------------------------------------------
void printText(unsigned char *msg)
{
    while (*msg)
    {
        printChar(*msg++, 1);
    }
}

//-----------------------------------------------------------------------------
void readChar(void)
{
    #if defined(__KEYPS2__) || defined(__KEYPS2_EXT__)
        unsigned char ix = 0, vmove;

        if (*kbdKeyPntr > 0)
        {
            // Desabilita KBD and VDP Interruption
            *(vmfp + Reg_IERA) &= 0x3E;

            // Pega proxima tecla disponivel
            *vBufReceived = *kbdKeyBuffer;

            // Move pilha pra proxima tecla pra primeira a ser lida
            ix = 0;
            while (ix <= 15) {
                vmove = *(kbdKeyBuffer + ix + 1);
                *(kbdKeyBuffer + ix) = vmove;
                ix++;
            }

            // Diminui contador do buffer
            *kbdKeyPntr = *kbdKeyPntr - 1;

            // Habilita KBD and VDP Interruption
            *(vmfp + Reg_IERA) |= 0xC0;
        }
    #endif

    #ifdef __MON_SERIAL_KBD__
        if ((*(vmfp + Reg_RSR) & 0x80))  // Se buffer de recepcao cheio
        {
            *vBufReceived = *(vmfp + Reg_UDR);
        }
    #endif

    #ifdef __KEYKBD__
        // TBD
    #endif
}

//-----------------------------------------------------------------------------
// VDP Functions
//-----------------------------------------------------------------------------
void setRegister(unsigned char registerIndex, unsigned char value)
{
    *vvdgc = value;
    *vvdgc = (0x80 | registerIndex);
}

//-----------------------------------------------------------------------------
unsigned char read_status_reg(void)
{
    unsigned char memByte;

    memByte = *vvdgc;

    return memByte;
}

//-----------------------------------------------------------------------------
void setWriteAddress(unsigned int address)
{
    *vvdgc = (unsigned char)(address & 0xff);
    *vvdgc = (unsigned char)(0x40 | (address >> 8) & 0x3f);
}

//-----------------------------------------------------------------------------
void setReadAddress(unsigned int address)
{
    *vvdgc = (unsigned char)(address & 0xff);
    *vvdgc = (unsigned char)((address >> 8) & 0x3f);
}

//-----------------------------------------------------------------------------
int vdp_init(unsigned char mode, unsigned char color, unsigned char big_sprites, unsigned char magnify)
{
    unsigned int i, j;
    unsigned char *tempFontes = videoFontes;

    *vdp_mode = mode;
    *sprite_size_sel = big_sprites;

    // Clear Ram
    setWriteAddress(0x0);
    for (i = 0; i < 0x3FFF; i++)
        *vvdgd = 0;

    switch (mode)
    {
        case VDP_MODE_G1:
            setRegister(0, 0x00);
            setRegister(1, 0xC0 | (big_sprites << 1) | magnify); // Ram size 16k, activate video output
            setRegister(2, 0x05); // Name table at 0x1400
            setRegister(3, 0x80); // Color, start at 0x2000
            setRegister(4, 0x01); // Pattern generator start at 0x800
            setRegister(5, 0x20); // Sprite attriutes start at 0x1000
            setRegister(6, 0x00); // Sprite pattern table at 0x000
            *sprite_pattern_table = 0;
            *pattern_table = 0x800;
            *sprite_attribute_table = 0x1000;
            *name_table = 0x1400;
            *color_table = 0x2000;
            *color_table_size = 32;
            // Initialize pattern table with ASCII patterns
            setWriteAddress(*pattern_table + 0x100);
            for (i = 0; i < 1784; i++)  // era 768
            {
                tempFontes = *videoFontes + i;
                *vvdgd = *tempFontes;
            }
            break;

        case VDP_MODE_G2:
            setRegister(0, 0x02);
            setRegister(1, 0xC0 | (big_sprites << 1) | magnify); // Ram size 16k, Disable Int, 16x16 Sprites, mag off, activate video output
            setRegister(2, 0x0E); // Name table at 0x3800
            setRegister(3, 0xFF); // Color, start at 0x2000             // segundo manual, deve ser 7F para 0x0000 ou FF para 0x2000
            setRegister(4, 0x03); // Pattern generator start at 0x000   // segundo manual, deve ser 03 para 0x0000 ou 07 para 0x2000
            setRegister(5, 0x76); // Sprite attriutes start at 0x3800
            setRegister(6, 0x03); // Sprite pattern table at 0x1800
            *pattern_table = 0x00;
            *sprite_pattern_table = 0x1800;
            *color_table = 0x2000;
            *name_table = 0x3800;
            *sprite_attribute_table = 0x3B00;
            *color_table_size = 0x1800;
            *vdpMaxCols = 255;
            *vdpMaxRows = 191;
            setWriteAddress(*name_table);
            for (i = 0; i < 768; i++)  // era 768
                *vvdgd = (unsigned char)(i & 0xFF);
            break;

        case VDP_MODE_MULTICOLOR:
            setRegister(0, 0x00);
            setRegister(1, 0xC8 | (big_sprites << 1) | magnify); // Ram size 16k, Multicolor
            setRegister(2, 0x05); // Name table at 0x1400
            // setRegister(3, 0xFF); // Color table not available
            setRegister(4, 0x01); // Pattern table start at 0x800
            setRegister(5, 0x76); // Sprite Attribute table at 0x1000
            setRegister(6, 0x03); // Sprites Pattern Table at 0x0
            *pattern_table = 0x800;
            *name_table = 0x1400;
            *vdpMaxCols = 63;
            *vdpMaxRows = 47;
            setWriteAddress(*name_table); // Init name table
            for (j = 0; j < 24; j++)
                for (i = 0; i < 32; i++)
                    *vvdgd = (i + 32 * (j / 4));

            break;

        case VDP_MODE_TEXT:
            setRegister(0, 0x00);
            setRegister(1, 0xD2); // Ram size 16k, Disable Int
            setRegister(2, 0x02); // Name table at 0x800
            setRegister(4, 0x00); // Pattern table start at 0x0
            *pattern_table = 0x00;
            *name_table = 0x800;
            *vdpMaxCols = 39;
            *vdpMaxRows = 23;
            setWriteAddress(*pattern_table + 0x100);
            for (i = 0; i < 1784; i++)  // era 768
            {
                tempFontes = *videoFontes + i;
                *vvdgd = *tempFontes;
            }
            vdp_textcolor(VDP_WHITE, VDP_BLACK);
            break;
        default:
            return VDP_ERROR; // Unsupported mode
    }

    setRegister(7, color);
    return VDP_OK;
}

//-----------------------------------------------------------------------------
void vdp_colorize(unsigned char fg, unsigned char bg)
{
    unsigned int name_offset = *videoCursorPosRowY * (*vdpMaxCols + 1) + *videoCursorPosColX; // Position in name table
    unsigned int color_offset = name_offset << 3;                      // Offset of pattern in pattern table
    unsigned int i;

    if (*vdp_mode != VDP_MODE_G2)
        return;

    setWriteAddress(*color_table + color_offset);

    for (i = 0; i < 8; i++)
        *vvdgd = ((fg << 4) + bg);
}

//-----------------------------------------------------------------------------
void vdp_plot_hires(unsigned char x, unsigned char y, unsigned char color1, unsigned char color2 = 0)
{
    unsigned int offset, posX, posY, modY;
    unsigned char pixel;
    unsigned char color;
    unsigned char sqtdtam[10];

    posX = (int)(8 * (x / 8));
    posY = (int)(256 * (y / 8));
    modY = (int)(y % 8);

    offset = posX + modY + posY;

    setReadAddress(*pattern_table + offset);
    setReadAddress(*pattern_table + offset);
    pixel = *vvdgd;
    setReadAddress(*color_table + offset);
    setReadAddress(*color_table + offset);
    color = *vvdgd;

    if(color1 != 0x00)
    {
        pixel |= 0x80 >> (x % 8); //Set a "1"
        color = (color & 0x0F) | (color1 << 4);
    }
    else
    {
        pixel &= ~(0x80 >> (x % 8)); //Set bit as "0"
        color = (color & 0xF0) | (color2 & 0x0F);
    }

    setWriteAddress(*pattern_table + offset);
    *vvdgd = (pixel);
    setWriteAddress(*color_table + offset);
    *vvdgd = (color);
}

//-----------------------------------------------------------------------------
void vdp_plot_color(unsigned char x, unsigned char y, unsigned char color)
{
    unsigned int addr = *pattern_table + 8 * (x / 2) + y % 8 + 256 * (y / 8);
    unsigned char dot = *vvdgd;
    unsigned int offset = 8 * (x / 2) + y % 8 + 256 * (y / 8);
    unsigned char color_ = *vvdgd;

    if (*vdp_mode == VDP_MODE_MULTICOLOR)
    {
        setReadAddress(addr);
        setWriteAddress(addr);

        if (x & 1) // Odd columns
            *vvdgd = ((dot & 0xF0) + (color & 0x0f));
        else
            *vvdgd = ((dot & 0x0F) + (color << 4));
    }
    else if (*vdp_mode == VDP_MODE_G2)
    {
        // Draw bitmap
        setReadAddress(*color_table + offset);

        if((x & 1) == 0) //Even
        {
            color_ &= 0x0F;
            color_ |= (color << 4);
        }
        else
        {
            color_ &= 0xF0;
            color_ |= color & 0x0F;
        }

        setWriteAddress(*pattern_table + offset);
        *vvdgd = (0xF0);
        setWriteAddress(*color_table + offset);
        *vvdgd = (color_);
        // Colorize
    }
}

//-----------------------------------------------------------------------------
void vdp_set_sprite_pattern(unsigned char number, const unsigned char *sprite)
{
    unsigned char i;

    if(*sprite_size_sel)
    {
        setWriteAddress(*sprite_pattern_table + (32 * number));
        for (i = 0; i<32; i++)
        {
            *vvdgd = (sprite[i]);
        }
    }
    else
    {
        setWriteAddress(*sprite_pattern_table + (8 * number));
        for (i = 0; i<8; i++)
        {
            *vvdgd = (sprite[i]);
        }
    }
}

//-----------------------------------------------------------------------------
void vdp_sprite_color(unsigned int addr, unsigned char color)
{
    unsigned char ecclr;

    setReadAddress(addr + 3);
    ecclr = *vvdgd & 0x80 | (color & 0x0F);
    setWriteAddress(addr + 3);
    *vvdgd = (ecclr);
}

//-----------------------------------------------------------------------------
Sprite_attributes vdp_sprite_get_attributes(unsigned int addr)
{
    Sprite_attributes attrs;
    setReadAddress(addr);
    attrs.y = *vvdgd;
    attrs.x = *vvdgd;
    attrs.name_ptr = *vvdgd;
    attrs.ecclr = *vvdgd;
    return attrs;
}

//-----------------------------------------------------------------------------
Sprite_attributes vdp_sprite_get_position(unsigned int addr)
{
    unsigned char x;
    unsigned char eccr;
    unsigned char vdumbread;
    Sprite_attributes attrs;
    setReadAddress(addr);

    attrs.y = *vvdgd;

    x = *vvdgd;

    vdumbread = *vvdgd;

    eccr = *vvdgd;

    attrs.x = eccr & 0x80 ? x : x+32;
    return attrs;
}

//-----------------------------------------------------------------------------
unsigned int vdp_sprite_init(unsigned char name, unsigned char priority, unsigned char color = 0)
{
    unsigned int addr = *sprite_attribute_table + 4*priority;

    setWriteAddress(addr);

    *vvdgd = (0);
    *vvdgd = (0);

    if(*sprite_size_sel)
        *vvdgd = (4*name);
    else
        *vvdgd = (4*name);
    *vvdgd = (0x80 | (color & 0xF));

    return addr;
}

//-----------------------------------------------------------------------------
unsigned char vdp_sprite_set_position(unsigned int addr, unsigned int x, unsigned char y)
{
    unsigned char ec, xpos;
    unsigned char color;

    if (x < 144)
    {
        ec = 1;
        xpos = x;
    }
    else
    {
        ec = 0;
        xpos = x-32;
    }
    setReadAddress(addr + 3);
    color = *vvdgd & 0x0f;

    setWriteAddress(addr);
    *vvdgd = (y);
    *vvdgd = (xpos);
    setWriteAddress(addr + 3);
    *vvdgd = ((ec << 7) | color);
    return read_status_reg();
}

//-----------------------------------------------------------------------------
void vdp_set_bdcolor(unsigned char color)
{
    setRegister(7, color);
}

//-----------------------------------------------------------------------------
void vdp_set_pattern_color(unsigned int index, unsigned char fg, unsigned char bg)
{
    if (*vdp_mode == VDP_MODE_G1)
    {
        index &= 31;
    }
    setWriteAddress(*color_table + index);
    *vvdgd = ((fg << 4) + bg);
}

//-----------------------------------------------------------------------------
void vdp_set_cursor(unsigned char pcol, unsigned char prow)
{
    if (pcol == 255) //<0
    {
        pcol = *vdpMaxCols;
        prow--;
    }
    else if (pcol > *vdpMaxCols)
    {
        pcol = 0;
        prow++;
    }

    if (prow == 255)
    {
        prow = *vdpMaxRows;
    }
    else if (prow > *vdpMaxRows)
    {
        prow = *vdpMaxRows; //0;
        geraScroll();
    }

    *videoCursorPosColX = pcol;
    *videoCursorPosRowY = prow;
}

//-----------------------------------------------------------------------------
void vdp_set_cursor_pos(unsigned char direction)
{
    unsigned char pMoveId = 1;

    if (*vdp_mode == VDP_MODE_MULTICOLOR)
        pMoveId = 8;

    switch (direction)
    {
        case VDP_CSR_UP:
            vdp_set_cursor(*videoCursorPosColX, *videoCursorPosRowY - pMoveId);
            break;
        case VDP_CSR_DOWN:
            vdp_set_cursor(*videoCursorPosColX, *videoCursorPosRowY + pMoveId);
            break;
        case VDP_CSR_LEFT:
            vdp_set_cursor(*videoCursorPosColX - pMoveId, *videoCursorPosRowY);
            break;
        case VDP_CSR_RIGHT:
            vdp_set_cursor(*videoCursorPosColX + pMoveId, *videoCursorPosRowY);
            break;
    }
}

//-----------------------------------------------------------------------------
void vdp_write(unsigned char chr)
{
    unsigned int name_offset = *videoCursorPosRowY * (*vdpMaxCols + 1) + *videoCursorPosColX; // Position in name table
    unsigned int pattern_offset = name_offset << 3;                    // Offset of pattern in pattern table
    char i, ix;
    unsigned short vAntX, vAntY;
    unsigned char *tempFontes = videoFontes;
    unsigned long vEndFont, vEndPart;

    if (*vdp_mode == VDP_MODE_G2)
    {
        setWriteAddress(*pattern_table + pattern_offset);
        for (i = 0; i < 8; i++)
        {
            vEndFont = *videoFontes;
            vEndPart = chr - 32;
            vEndPart = vEndPart << 3;
            vEndFont += vEndPart + i;
            tempFontes = vEndFont;
            *vvdgd = *tempFontes;
        }
    }
    else if (*vdp_mode == VDP_MODE_MULTICOLOR)
    {
        vAntY = *videoCursorPosRowY;
        for (i = 0; i < 8; i++)
        {
            vEndFont = *videoFontes;
            vEndPart = chr - 32;
            vEndPart = vEndPart << 3;
            vEndFont += vEndPart + i;
            tempFontes = vEndFont;
            vAntX = *videoCursorPosColX;
            for (ix = 7; ix >=0; ix--)
            {
                vdp_plot_color(*videoCursorPosColX, *videoCursorPosRowY, ((*tempFontes >> ix) & 0x01) ? *fgcolor : *bgcolor);
                *videoCursorPosColX = *videoCursorPosColX + 1;
            }
            *videoCursorPosColX = vAntX;
            *videoCursorPosRowY = *videoCursorPosRowY + 1;
        }
        *videoCursorPosRowY = vAntY;
    }
    else // G1 and text mode
    {
        setWriteAddress(*name_table + name_offset);
        *vvdgd = (chr);
    }
}

//-----------------------------------------------------------------------------
void vdp_textcolor(unsigned char fg, unsigned char bg)
{
    *fgcolor = fg;
    *bgcolor = bg;
    if (*vdp_mode == VDP_MODE_TEXT)
        setRegister(7, (fg << 4) + bg);
}

//-----------------------------------------------------------------------------
int vdp_init_textmode(unsigned char fg, unsigned char bg)
{
    unsigned int vret;
    *fgcolor = fg;
    *bgcolor = bg;
    vret = vdp_init(VDP_MODE_TEXT, (*fgcolor<<4) | (*bgcolor & 0x0f), 0, 0);
    return vret;
}

//-----------------------------------------------------------------------------
int vdp_init_g1(unsigned char fg, unsigned char bg)
{
    unsigned int vret;
    *fgcolor = fg;
    *bgcolor = bg;
    vret = vdp_init(VDP_MODE_G1, (*fgcolor<<4) | (*bgcolor & 0x0f), 0, 0);
    return vret;
}

//-----------------------------------------------------------------------------
int vdp_init_g2(unsigned char big_sprites, unsigned char scale_sprites) // 1, false
{
    unsigned int vret;
    vret = vdp_init(VDP_MODE_G2, 0x0, big_sprites, scale_sprites);
    return vret;
}

//-----------------------------------------------------------------------------
int vdp_init_multicolor(void)
{
    unsigned int vret;
    vret = vdp_init(VDP_MODE_MULTICOLOR, 0, 0, 0);
    return vret;
}

//-----------------------------------------------------------------------------
char vdp_read_color_pixel(unsigned char x, unsigned char y)
{
    char vRetColor = -1;
    unsigned int addr = 0;

    if (*vdp_mode == VDP_MODE_MULTICOLOR)
    {
        addr = *pattern_table + 8 * (x / 2) + y % 8 + 256 * (y / 8);

        setReadAddress(addr);
        setReadAddress(addr);

        if (x & 1) // Odd columns
            vRetColor = (*vvdgd & 0x0f);
        else
            vRetColor = (*vvdgd >> 4);        
    }

    return vRetColor;
}

//-----------------------------------------------------------------------------
void geraScroll(void)
{
    unsigned int name_offset = 0; // Position in name table
    unsigned int i, j;
    unsigned char chr[40];
    unsigned char vdumbread;

    if (*vdp_mode == VDP_MODE_TEXT)
    {
        for (i = 1; i < 24; i++)
        {
            // Ler Linha
            name_offset = (i * (*vdpMaxCols + 1)); // Position in name table
            setWriteAddress((*name_table + name_offset));

            vdumbread = *vvdgd;

            for (j = 0; j < 40; j++)
            {
                chr[j] = *vvdgd;
            }

            // Escrever na linha anterior
            name_offset = ((i - 1) * (*vdpMaxCols + 1)); // Position in name table
            setWriteAddress((*name_table + name_offset));

            for (j = 0; j < 40; j++)
            {
                *vvdgd = chr[j];
            }
        }

        // Apaga Ultima Linha
        name_offset = (23 * (*vdpMaxCols + 1)); // Position in name table
        setWriteAddress((*name_table + name_offset));

        for (j = 0; j < 40; j++)
        {
            *vvdgd = 0x00;
        }
    }
}

//-----------------------------------------------------------------------------
void hideCursor(void)
{
    if (!*videoCursorShow)  // Cursor já esta escondido, nao faz nada
        return;

    *videoCursorShow = 0;

    printChar(0xFF, 1);
}

//-----------------------------------------------------------------------------
void showCursor(void)
{
    if (*videoCursorShow)   // Cursor já esta aparecendo, nao faz nada
        return;

    *videoCursorShow = 1;

    printChar(0xFF, 1);
}

//-----------------------------------------------------------------------------
void modeVideo(unsigned char *pMode)
{
    unsigned long vMode = 0;

    if (pMode[0] != 0x00)
    {
        vMode = atol(pMode);

        if (vMode <= 3)
        {
            switch(vMode)
            {
                case 0:
                    vdp_init_textmode(VDP_WHITE, VDP_BLACK);
                    break;
                case 1:
                    vdp_init_g1(VDP_WHITE, VDP_BLACK);
                    break;
                case 2:
                    vdp_init_g2(1, 0);
                    break;
                case 3:
                    vdp_init_multicolor();
                    break;
            }

            clearScr();
        }
        else
            vMode = 0xFF;
    }
    else
        vMode = 0xFF;

    if (vMode == 0xFF && *vdp_mode == VDP_MODE_TEXT)
    {
        printText("usage: mode [code]\r\n\0");
        printText("   code: 0 = Text Mode 40x24\r\n\0");
        printText("         1 = Graphic Text Mode 32x24\r\n\0");
        printText("         2 = Graphic 256x192\r\n\0");
        printText("         3 = Graphic 64x48\r\n\0");
    }
}

//-----------------------------------------------------------------------------
void asctohex(unsigned char a, unsigned char *s)
{
     unsigned char c;
     c = (a >> 4) & 0x0f;
     if (c <= 9) c+= '0'; else c += 'a' - 10;
     *s++ = c;
     c = a & 0x0f;
     if (c <= 9) c+= '0'; else c += 'a' - 10;
     *s++ = c;
     *s = 0;
}

//-----------------------------------------------------------------------------
int hex2int(char ch)
{
    if (ch >= '0' && ch <= '9')
        return ch - '0';
    if (ch >= 'A' && ch <= 'F')
        return ch - 'A' + 10;
    if (ch >= 'a' && ch <= 'f')
        return ch - 'a' + 10;
    return -1;
}

//-----------------------------------------------------------------------------
unsigned long pow(int val, int pot)
{
    int ix;
    int base = val;

    if (val != 0)
    {
        if (pot == 0)
            val = 1;
        else if (pot == 1)
            val = base;
        else
        {
            for (ix = 0; ix <= pot; ix++)
            {
                if (ix >= 2)
                    val *= base;
            }
        }
    }

    return val;
}

//-----------------------------------------------------------------------------
unsigned long hexToLong(char *pHex)
{
    int ix;
    unsigned char ilen = strlen(pHex) - 1;
    unsigned long pVal = 0;

    for (ix = ilen; ix >= 0; ix--)
    {
        pVal += hex2int(pHex[ilen - ix]) * pow(16, ix);
    }

    return pVal;
}


//-----------------------------------------------------------------------------
void pokeMem(unsigned char *pEnder, unsigned char *pByte)
{
    unsigned char *vEnder = hexToLong(pEnder);
    unsigned long tByte = hexToLong(pByte);
    unsigned char vByte = 0;

    if (pEnder[0] != 0x00 && pByte[0] != 0x00)
    {
        vByte = (unsigned char)tByte;

        *vEnder = vByte;
    }
    else
    {
        if (*vdp_mode == VDP_MODE_TEXT)
            printText("usage: poke <ender> <byte>\r\n\0");
    }
}

//-----------------------------------------------------------------------------
// dump <ender> [qtd (default 64)] [cols (default 8 (42cols) or 4 (32cols))]
//-----------------------------------------------------------------------------
void dumpMem (unsigned char *pEnder, unsigned char *pqtd, unsigned char *pCols)
{
    unsigned char ptype = 0x00;
    unsigned char *pender = hexToLong(pEnder);
    unsigned long vqtd = 64, ix;
    unsigned long vcols = 8;
    int iy;
    unsigned char shex[4], vchr[2];
    unsigned char pbytes[16];
    char vbuffer [sizeof(long)*8+1];
    char buffer[10];
    int i=0;
    int j=0;

    if (pEnder[0] == 0)
    {
        if (*vdp_mode == VDP_MODE_TEXT)
        {
            printText("usage: dump <ender> [qtd] [cols]\r\n\0");
            printText("    qtd: default 64\r\n\0");
            printText("   cols: default 8\r\n\0");
        }
        return;
    }

    if (*vdpMaxCols == 32)
        vcols = 4;

    if (pqtd[0] != 0x00)
        vqtd = atol(pqtd);

    if (pCols[0] != 0x00)
        vcols = atol(pCols);

    for (ix = 0; ix < vqtd; ix += vcols)
    {
        ltoa (pender,vbuffer,16);
        for (i=0; i<(6-strlen(vbuffer));i++) {
            buffer[i]='0';
        }
        for(j=0;j<strlen(vbuffer);j++){
            buffer[i] = vbuffer[j];
            i++;
            buffer[i] = 0x00;
        }

        printText(buffer);
        printChar(':', 1);

        for (iy = 0; iy < vcols; iy++)
            pbytes[iy] = *pender++;

        for (iy = 0; iy < vcols; iy++)
        {
            asctohex(pbytes[iy], shex);
            printText(shex);

            if ((vcols - iy) >= 2)
                printChar(' ', 1);
        }

        printText("|\0");

        for (iy = 0; iy < vcols; iy++)
        {
            if (pbytes[iy] >= 0x20)
            {
                vchr[0] = pbytes[iy];
                vchr[1] = 0x00;
                printText(vchr);
            }
            else
                printChar('.', 1);
        }

        printText("\r\n\0");
    }
}

//-----------------------------------------------------------------------------
// dumps <ender> [qtd (default 256)]
// Joga direto pra serial
//-----------------------------------------------------------------------------
void dumpMem2 (unsigned char *pEnder, unsigned char *pqtd)
{
    unsigned char ptype = 0x00;
    unsigned char *pender = hexToLong(pEnder);;
    unsigned long vqtd = 256, ix;
    int iy;
    unsigned char shex[4];
    unsigned char pbytes[16];
    char vbuffer [sizeof(long)*8+1];
    char buffer[10];
    int i=0;
    int j=0;

    if (pEnder[0] == 0)
    {
        if (*vdp_mode == VDP_MODE_TEXT)
            writeLongSerial("usage: dump <ender initial> [qtd (default 256)]\r\n\0");
        return;
    }

    if (pqtd[0] != 0x00)
        vqtd = atol(pqtd);

    for (ix = 0; ix < vqtd; ix += 16)
    {
        ltoa (pender,vbuffer,16);
        for (i=0; i<(6-strlen(vbuffer));i++) {
            buffer[i]='0';
        }
        for(j=0;j<strlen(vbuffer);j++){
            buffer[i] = vbuffer[j];
            i++;
            buffer[i] = 0x00;
        }

        writeLongSerial(buffer);
        writeLongSerial("h : ");

        for (iy = 0; iy < 16; iy++)
        {
            pbytes[iy] = *pender;
            pender = pender + vdpAddCol;
        }

        for (iy = 0; iy < 16; iy++)
        {
            asctohex(pbytes[iy], shex);
            writeLongSerial(shex);
            writeSerial(' ');
        }

        writeLongSerial(" | \0");

        for (iy = 0; iy < 16; iy++)
        {
            if (pbytes[iy] >= 0x20)
                writeSerial(pbytes[iy]);
            else
                writeSerial('.');
        }

        writeLongSerial("\r\n\0");
    }
}

//-----------------------------------------------------------------------------
void writeSerial(unsigned char pchr)
{
    while(!(*(vmfp + Reg_TSR) & 0x80));  // Aguarda buffer de transmissao estar vazio
    *(vmfp + Reg_UDR) = pchr;
    *vBufXmitEmpty = 0;     // Indica que o buffer de transmissao esta cheio
}

//-----------------------------------------------------------------------------
void writeLongSerial(unsigned char *msg)
{
    while (*msg)
    {
        writeSerial(*msg++);
    }
}

//-----------------------------------------------------------------------------
// load <ender initial to save>
//-----------------------------------------------------------------------------
//         Uses XMODEM Protocol
//-----------------------------------------------------------------------------
// ptipo : 1 = mostra mensagens 0 = nao mostra e apenas retorna os erros ou 0x00 carregado com sucesso
//-----------------------------------------------------------------------------
unsigned char loadSerialToMem(unsigned char *pEnder, unsigned char ptipo)
{
    unsigned long vTamanho;
    unsigned char vHeader[3];
    unsigned int vchecksum = 0;
    unsigned char inputBuffer, verro = 0;
    unsigned char *vEndSave = hexToLong(pEnder);
    unsigned char *vEndOld  = hexToLong(pEnder);
    unsigned long vTimeout = 0, vchecksumcalc = 0;
    unsigned char sqtdtam[20];
    unsigned char vinicio = 0x00;
    unsigned char vStart = 0x00;
    unsigned char vBlockOld = 0x00;
    unsigned int vAnim = 1000;

    if (pEnder[0] == 0)
    {
        if (ptipo)
        {
            printText("Invalid Argument: \0");
            printText(pEnder);
            printText("\r\n\0");
            printText("usage: load <ender>\r\n\0");
            printText("    <ender> : ender to save >= 00800000h\r\n\0");
        }

        return 0xFF;
    }


    if (ptipo)
        printText("Receiving... \0");

    // Desabilita KBD and VDP Interruption
    *(vmfp + Reg_IERA) &= 0x3E;

    while(1)
    {
        inputBuffer = 0;
        vTimeout = 0;

        if (ptipo)
        {
            switch (vAnim)
            {
                case 800:
                    vdp_write(0x2F);    // Show "/"
                    break;
                case 1600:
                    vdp_write(0x2D);    // Show "-"
                    break;
                case 2400:
                    vdp_write(0x5C);    // Show "\"
                    break;
                case 3200:
                    vdp_write(0x7C);    // Show "|"
                    vAnim = 0;
                    break;
            }

            vAnim++;
        }

        while(!(*(vmfp + Reg_RSR) & 0x80))
        {
            if(vinicio == 0x00 && vStart == 0x00)
            {
                if ((vTimeout % 100000) == 0) // +/- 10s
                {
                    *(vmfp + Reg_GPDR) = 0x01;

                    writeSerial(0x15);    // Send NACK to start
                }
                else
                {
                    *(vmfp + Reg_GPDR) = 0x01;
                }
            }

            vTimeout++;
            if (vTimeout > 3000000) // +/- 5 min
                break;
        };

        if (vTimeout > 3000000)
            break;

        inputBuffer = *(vmfp + Reg_UDR);

        if (vinicio == 0 && inputBuffer == 0x04)    // Primeiro byte eh EOT
        {
            writeSerial(0x06);    // Send ACK
            break;
        }
        else if (vinicio < 3)
        {
            *(vmfp + Reg_GPDR) = 0x04;

            vHeader[vinicio] = inputBuffer;

            if (vinicio == 1)
            {
                if (vBlockOld == inputBuffer)
                    vEndSave = vEndOld;
                else
                {
                    vEndOld = vEndSave;
                    vBlockOld = inputBuffer;
                }
            }

            vinicio++;
            vchecksumcalc = 0;
            verro = 0;
            vStart = 0x01;
        }
        else if (vinicio == 131)
        {
            *(vmfp + Reg_GPDR) = 0x05;

            vinicio = 0;
            vchecksum = inputBuffer;
            if ((vchecksumcalc % 256) != vchecksum)
            {
                *(vmfp + Reg_GPDR) = 0x00;
                verro = 1;
                vEndSave = vEndOld;
                writeSerial(0x15);    // Send NACK
            }
            else
            {
                *(vmfp + Reg_GPDR) = 0x01;
                writeSerial(0x06);    // Send ACK
            }
        }
        else
        {
            *vEndSave++ = inputBuffer;
            vchecksumcalc += inputBuffer;
            vinicio++;
        }
    }

    vdp_write(' ');

    printText("\r\n\0");

    // Habilita KBD and VDP Interruption
    *(vmfp + Reg_IERA) |= 0xC0;

    if (vTimeout > 3000000)
    {
        if (ptipo)
            printText("Timeout. Process Aborted.\r\n\0");

        return 0xFE;
    }
    else
    {
        if (!verro)
        {
            if (ptipo)
                printText("File loaded in to memory successfuly.\r\n\0");

            return 0x00;
        }
        else
        {
            if (ptipo)
                printText("File loaded in to memory with checksum errors.\r\n\0");

            return 0xFD;
        }
    }

    return 0xF0;
}

//-----------------------------------------------------------------------------
void runMem(unsigned long pEnder)
{
    runCmd();
}

//-----------------------------------------------------------------------------
void runBasic(unsigned long pEnder)
{
    runBas();
}

//-----------------------------------------------------------------------------
// Delay Function
//-----------------------------------------------------------------------------
void delayms(int pTimeMS)
{
    unsigned int ix;
    unsigned int iTempo = (100 * pTimeMS);

    for(ix = 0; ix <= iTempo; ix++);    // +/- 1ms * pTimeMs parada
}

//-----------------------------------------------------------------------------
void delayus(int pTimeUS)
{
    unsigned int ix;

    for(ix = 0; ix <= pTimeUS; ix++);    // +/- 1us * pTimeMs parada
}

#ifdef __KEYPS2__
//-----------------------------------------------------------------------------
// KBD PS2 Functions
//-----------------------------------------------------------------------------
void processCode(void)
{
    unsigned char decoded;
    if (*kbdScanCodeBuf == 0xAA && *kbdvprim)
    {
        sendByte(0xFE);
        *kbdvprim = 0;
    }

    if ((*kbdScanCodeBuf | 0x10) == 0xF0)
    {
        // release code!
        *kbdvreleased = 0x01;
        *kbdScanCodeCount = 0;
    }
    else if ((*kbdScanCodeBuf | 0x10) == 0xE0)
    {
        // apenas prepara para o proximo codigo
        *kbdve0 = 0x01;
        *kbdScanCodeCount = 0;
    }
    else if ((*kbdScanCodeBuf | 0x10) == 0xE1)
    {
        // apenas prepara para o proximo codigo
        delayms(100);
        *kbdScanCodeCount=0;
    }
    else
    {
        // normal character received
        if (!*kbdvcaps && !*kbdvshift)
            decoded = convertCode(*kbdScanCodeBuf,keyCode,ascii);
        else if (!*kbdvcaps && *kbdvshift)
            decoded = convertCode(*kbdScanCodeBuf,keyCode,ascii2);
        else if (*kbdvcaps && !*kbdvshift)
            decoded = convertCode(*kbdScanCodeBuf,keyCode,ascii3);
        else if (*kbdvcaps && *kbdvshift)
            decoded = convertCode(*kbdScanCodeBuf,keyCode,ascii4);

        if (decoded != '\0')
        {
            // allowed key code character received
            if (!*kbdvreleased)
            {
                if (*kbdKeyPntr > kbdKeyBuffMax)
                {
                    // buffer full
                }
                else
                {
                    *(kbdKeyBuffer + *kbdKeyPntr) = decoded;
                    *kbdKeyPntr = *kbdKeyPntr + 1;
                    *(kbdKeyBuffer + *kbdKeyPntr) = '\0';
                }
            }
        }
        else
        {
            // other character received
            switch (*kbdScanCodeBuf)
            {
                case 0x12:  // Shift
                case 0x59:
                    *kbdvshift = ~*kbdvreleased & 0x01;
                    break;
                case 0x14:  // Ctrl
                    *kbdvctrl = ~*kbdvreleased & 0x01;
                    break;
                case 0x11:  // Alt
                    *kbdvalt = ~*kbdvreleased & 0x01;
                    break;
                case 0x58:  // Caps Lock
                    if (!*kbdvreleased)
                    {
                        *kbdvcaps = ~*kbdvcaps & 0x01;
                        sendByte(0xED);
                        sendByte((0x00 | (*kbdvcaps << 2) | (*kbdvnum << 1) | (*kbdvscr)));
                    }
                    break;
                case 0x77:  // Num Lock
                    if (!*kbdvreleased)
                    {
                        *kbdvnum = ~*kbdvnum & 0x01;
                        sendByte(0xED);
                        sendByte((0x00 | (*kbdvcaps << 2) | (*kbdvnum << 1) | (*kbdvscr)));
                    }
                    break;
                case 0x7E:  // Scroll Lock
                    if (!*kbdvreleased)
                    {
                        *kbdvscr = ~*kbdvscr & 0x01;
                        sendByte(0xED);
                        sendByte((0x00 | (*kbdvcaps << 2) | (*kbdvnum << 1) | (*kbdvscr)));
                    }
                    break;
                case 0x66:  // backspace
                    if (!*kbdvreleased)
                    {
                        *(kbdKeyBuffer + *kbdKeyPntr) = 0x08;
                        *kbdKeyPntr = *kbdKeyPntr + 1;
                        *(kbdKeyBuffer + *kbdKeyPntr) = '\0';
                    }
                    break;
                case 0x5A:  // enter
                    if (!*kbdvreleased)
                    {
                        *(kbdKeyBuffer + *kbdKeyPntr) = 0x0D;
                        *kbdKeyPntr = *kbdKeyPntr + 1;
                        *(kbdKeyBuffer + *kbdKeyPntr) = '\0';
                    }
                    break;
                case 0x76:  // ESCAPE
                    if (!*kbdvreleased)
                    {
                        *(kbdKeyBuffer + *kbdKeyPntr) = 0x1B;
                        *kbdKeyPntr = *kbdKeyPntr + 1;
                        *(kbdKeyBuffer + *kbdKeyPntr) = '\0';
                    }
                    break;
                case 0x0D:  // TAB
                    if (!*kbdvreleased)
                    {
                        *(kbdKeyBuffer + *kbdKeyPntr) = 0x09;
                        *kbdKeyPntr = *kbdKeyPntr + 1;
                        *(kbdKeyBuffer + *kbdKeyPntr) = '\0';
                    }
                    break;
            } // end switch
        } // end if (decoded>0x00)

        *kbdvreleased = 0x00;
        delayms(20);
        *kbdScanCodeCount = 0;
    }
}

//-----------------------------------------------------------------------------
unsigned char convertCode(unsigned char codeToFind, unsigned char *source, unsigned char *destination)
{
    while(*source != codeToFind && *source++ > 0x00)
        destination++;

    return *destination;
}

//-----------------------------------------------------------------------------
void sendByte(unsigned char b)
{
    /*unsigned char a=0;
    unsigned char p = 1;
    unsigned char t = 0;

    // Desabilita KBD and VDP Interruption
    *(vmfp + Reg_IERA) &= 0x3E;

    *(vmfp + Reg_GPDR) &= 0xBF; // Zera Clock (I6)
    *(vmfp + Reg_DDR)  |= 0x40; // I6 as Output

    delayus(125);

    *(vmfp + Reg_GPDR) &= 0xFE; // Zera Data (I0)
    *(vmfp + Reg_DDR)  |= 0x01; // I0 as Output

    delayus(125);

    *(vmfp + Reg_DDR)  &= 0xBF; // I6 as Input

    for(a = 0; a < 8; a++) {
        t = (b >> a) & 0x01;

        while ((*(vmfp + Reg_GPDR) & 0x40) == 0x40); //wait clock for 0

        *(vmfp + Reg_GPDR) |= t;

        if (t) p++;

        while ((*(vmfp + Reg_GPDR) & 0x40) == 0x00); //wait clock for 1
    }

    while((*(vmfp + Reg_GPDR) & 0x40) == 0x40); //wait clock for 0
    *(vmfp + Reg_GPDR) |= p & 0x01;
    while((*(vmfp + Reg_GPDR) & 0x40) == 0x00); //wait clock for 1

    *(vmfp + Reg_DDR)  &= 0xFE; // I0 as Input
    while((*(vmfp + Reg_GPDR) & 0x01) == 0x01); //wait data for 0
    while((*(vmfp + Reg_GPDR) & 0x40) == 0x40); //wait clock for 0

    // Habilita KBD and VDP Interruption
    *(vmfp + Reg_IERA) |= 0xC0;*/
}
#endif

//-----------------------------------------------------------------------------
void basicFuncBios(void)
{
}

//-----------------------------------------------------------------------------
void funcSpuriousInt(void)
{
}

//-----------------------------------------------------------------------------
void funcIntPIC(void)
{
    // Chamada de dados do PIC para o processador
}

//-----------------------------------------------------------------------------
void funcIntUsbSerial(void)
{
}

//-----------------------------------------------------------------------------
void funcIntVideo(void)
{

}

//-----------------------------------------------------------------------------
void funcIntMouse(void)
{
}

//-----------------------------------------------------------------------------
void funcIntKeyboard(void)
{

}

//-----------------------------------------------------------------------------
void funcIntMultiTask(void)
{
    // Nao usara por enquanto, porque sera controlado pelo SO
    // E serah feito em ASM por causa das trocas de SP (A7)
}

//-----------------------------------------------------------------------------
void funcIntMfpGpi0(void)
{
    // TBD

    *(vmfp + Reg_ISRB) &= 0xFE;  // Reseta flag de interrupcao GPI0 no MFP
}

//-----------------------------------------------------------------------------
void funcIntMfpGpi1(void)
{

}

//-----------------------------------------------------------------------------
void funcIntMfpGpi2(void)
{

}

//-----------------------------------------------------------------------------
void funcIntMfpGpi3(void)
{

}

//-----------------------------------------------------------------------------
void funcIntMfpTmrD(void)
{

}

//-----------------------------------------------------------------------------
void funcIntMfpTmrC(void)
{

}

//-----------------------------------------------------------------------------
void funcIntMfpGpi4(void)
{

}

//-----------------------------------------------------------------------------
void funcIntMfpGpi5(void)
{

}

//-----------------------------------------------------------------------------
void funcIntMfpTmrB(void)
{

}

//-----------------------------------------------------------------------------
void funcIntMfpXmitErr(void)
{

}

//-----------------------------------------------------------------------------
void funcIntMfpXmitBufEmpty(void)
{
    *vBufXmitEmpty = 1; // Buffer Transmissao Vazio
    *(vmfp + Reg_GPDR) = 0x05;
    *(vmfp + Reg_ISRA) &= 0xFB; // Reseta flag de interrupcao no MFP
}

//-----------------------------------------------------------------------------
void funcIntMfpRecErr(void)
{

}

//-----------------------------------------------------------------------------
void funcIntMfpRecBufFull(void)
{
    *vBufReceived = *(vmfp + Reg_UDR);   // Carrega byte do buffer do MFP
    *(vmfp + Reg_ISRA) &= 0xEF;  // Reseta flag de interrupcao no MFP
}

//-----------------------------------------------------------------------------
void funcIntMfpTmrA(void)
{

}

//-----------------------------------------------------------------------------
void funcIntMfpGpi6(void)
{
    #ifdef __KEYPS2_EXT__
        unsigned char decoded = 0xFF;

        // Pega dados do controlador via protocolo
        while (decoded != 0)
        {
            *(vmfp + Reg_GPDR) &= 0xEF;  // Seta CS (I4) = 0 do controlador e/ou indicando que ja leu MSB
            while (*(vmfp + Reg_GPDR) & 0x20); // Aguarda Controlador liberar LSB para leitura
            decoded = *(vmfp + Reg_GPDR) & 0x0F;

            *(vmfp + Reg_GPDR) |= 0x10;  // Seta CS (I4) = 1 do controlador indicando que ja leu LSB
            while (!(*(vmfp + Reg_GPDR) & 0x20)); // Aguarda Controlador liberar MSB para leitura
            decoded |= ((*(vmfp + Reg_GPDR) & 0x0F) << 4);

            if (decoded != 0x00)
            {
                // Coloca tecla digitada no buffer
                *(kbdKeyBuffer + *kbdKeyPntr) = decoded;

                if (*kbdKeyPntr < kbdKeyBuffMax)
                    *kbdKeyPntr = *kbdKeyPntr + 1;
                *(kbdKeyBuffer + *kbdKeyPntr) = '\0';
            }

            *(vmfp + Reg_GPDR) &= 0xEF;  // Seta CS (I4) = 0 do controlador e/ou indicando que ja leu MSB
        }

        *(vmfp + Reg_GPDR) |= 0x10;  // Seta CS = 1 (I4) do controlador
    #endif

    #ifdef __KEYPS2__
        if (*kbdClockCount < 10)
        {
            // No 11 bits received yet: add to the scancode [start][d0...d7][parity][stop]
            *scanCode = (*scanCode >> 1);
            *scanCode = *scanCode | (unsigned short)((unsigned short)(*(vmfp + Reg_GPDR) & 0x01) * 0x400);
            *kbdClockCount = *kbdClockCount + 1;
        }
        else if (*kbdClockCount == 10)
        {
            // 11 bits received: process the code
            *(kbdScanCodeBuf + *kbdScanCodeCount) = (unsigned char)((*scanCode >> 2) & 0xFF);

            if (*kbdScanCodeCount < kbdMaxCharBuff)
                *kbdScanCodeCount = *kbdScanCodeCount + 1;

            *scanCode = 0;
            *kbdClockCount = 0;

            // Convert scancode
            processCode();
        }
    #endif

    *(vmfp + Reg_ISRA) &= 0xBF;  // Reseta flag de interrupcao no MFP
}

//-----------------------------------------------------------------------------
void funcIntMfpGpi7(void)
{
    *(vmfp + Reg_ISRA) &= 0x7F;  // Reseta flag de interrupcao no MFP
}

//-----------------------------------------------------------------------------
void funcZeroesLeft(unsigned char* buffer, unsigned char vTam)
{
    unsigned char vbuffer[20], i, j;

    if (vTam < strlen(vbuffer))
        vTam = strlen(vbuffer);

    strcpy(vbuffer,buffer);
    for (i=0; i<(vTam-strlen(vbuffer));i++) {
        buffer[i]='0';
    }
    for(j=0;j<strlen(vbuffer);j++){
        buffer[i] = vbuffer[j];
        i++;
        buffer[i] = 0x00;
    }
}

//-----------------------------------------------------------------------------
void funcErrorBusAddr(void)
{
    unsigned int ix = 0, iz;
    unsigned char sqtdtam[20];
    unsigned short vOP = 0;

    *videoCursorPosColX = 0;
    *videoCursorPosRowY = 0;
    *videoScroll = 1;       // Ativo
    *videoScrollDir = 1;    // Pra Cima
    *videoCursorBlink = 1;
    *videoCursorShow = 0;
    *vdpMaxCols = 39;
    *vdpMaxRows = 23;
    vdp_init_textmode(VDP_WHITE, VDP_DARK_RED);

    clearScr();
    printChar(218,1);
    for (ix = 0; ix < 36; ix++)
        printChar(196,1);
    printChar(191,1);
    printText(" \r\n");
    printChar(179,1);
    printText("          EXCEPTION OCCURRED        ");
    printChar(179,1);
    printText(" \r\n");
    printChar(195,1);
    for (ix = 0; ix < 36; ix++)
        printChar(196,1);
    printChar(180,1);
    printText(" \r\n");

    vOP = *errorBufferAddrBus;

    switch (vOP)
    {
        case 0x0000:
            printChar(179,1);
            printText("      BUS ERROR / ADDRESS ERROR     ");
            printChar(179,1);
            printText(" \r\n");
            break;
        case 0x0001:
            printChar(179,1);
            printText("         ILLEGAL INSTRUCTION        ");
            printChar(179,1);
            printText(" \r\n");
            break;
        case 0x0002:
            printChar(179,1);
            printText("             ZERO DIVIDE            ");
            printChar(179,1);
            printText(" \r\n");
            break;
        case 0x0003:
            printChar(179,1);
            printText("           CHK INSTRUCTION          ");
            printChar(179,1);
            printText(" \r\n");
            break;
        case 0x0004:
            printChar(179,1);
            printText("                TRAPV               ");
            printChar(179,1);
            printText(" \r\n");
            break;
        case 0x0005:
            printChar(179,1);
            printText("         PRIVILEGE VIOLATION        ");
            printChar(179,1);
            printText(" \r\n");
            break;
        default:
            itoa(errorBufferAddrBus,sqtdtam,16);
            funcZeroesLeft(&sqtdtam, 8);
            printText(sqtdtam);
            printText(" : ");
            itoa(vOP,sqtdtam,16);
            funcZeroesLeft(&sqtdtam, 4);
            printText(sqtdtam);
            printText("\r\n");
            break;
    }
    printChar(195,1);
    for (ix = 0; ix < 36; ix++)
        printChar(196,1);
    printChar(180,1);
    printText(" \r\n");

    ix++;

    // Mostra Registradores: 2 words by register
    printChar(179,1);
    printText(" D0       D1       D2       D3      ");
    printChar(179,1);
    printText(" \r\n");

    printChar(179,1);
    printChar(' ',1);
    for (iz = 0; iz < 4; iz++)  // Mostra d0-d3
    {
        itoa(*(errorBufferAddrBus + ix),sqtdtam,16);
        funcZeroesLeft(&sqtdtam, 4);
        printText(sqtdtam);
        ix++;
        itoa(*(errorBufferAddrBus + ix),sqtdtam,16);
        funcZeroesLeft(&sqtdtam, 4);
        printText(sqtdtam);
        ix++;

        if (iz < 3)
            printText(" ");
    }
    printChar(179,1);
    printText("\r\n");

    printChar(179,1);
    printText(" D4       D5       D6       D7      ");
    printChar(179,1);
    printText(" \r\n");

    printChar(179,1);
    printChar(' ',1);
    for (iz = 0; iz < 4; iz++)  // Mostra d4-d7
    {
        itoa(*(errorBufferAddrBus + ix),sqtdtam,16);
        funcZeroesLeft(&sqtdtam, 4);
        printText(sqtdtam);
        ix++;
        itoa(*(errorBufferAddrBus + ix),sqtdtam,16);
        funcZeroesLeft(&sqtdtam, 4);
        printText(sqtdtam);
        ix++;

        if (iz < 3)
            printText(" ");
    }
    printChar(179,1);
    printText("\r\n");

    printChar(179,1);
    printText(" A0       A1       A2       A3      ");
    printChar(179,1);
    printText(" \r\n");

    printChar(179,1);
    printChar(' ',1);
    for (iz = 0; iz < 4; iz++)  // Mostra d0-d3
    {
        itoa(*(errorBufferAddrBus + ix),sqtdtam,16);
        funcZeroesLeft(&sqtdtam, 4);
        printText(sqtdtam);
        ix++;
        itoa(*(errorBufferAddrBus + ix),sqtdtam,16);
        funcZeroesLeft(&sqtdtam, 4);
        printText(sqtdtam);
        ix++;

        if (iz < 3)
            printText(" ");
    }
    printChar(179,1);
    printText(" \r\n");

    printChar(179,1);
    printText(" A4       A5       A6               ");
    printChar(179,1);
    printText(" \r\n");

    printChar(179,1);
    printChar(' ',1);
    for (iz = 0; iz < 3; iz++)  // Mostra d4-d7
    {
        itoa(*(errorBufferAddrBus + ix),sqtdtam,16);
        funcZeroesLeft(&sqtdtam, 4);
        printText(sqtdtam);
        ix++;
        itoa(*(errorBufferAddrBus + ix),sqtdtam,16);
        funcZeroesLeft(&sqtdtam, 4);
        printText(sqtdtam);
        ix++;

        printText(" ");
    }
    printText("        ");
    printChar(179,1);
    printText("\r\n");
    printChar(179,1);
    printText("                                    ");
    printChar(179,1);
    printText("\r\n");

    printChar(179,1);
    printText(" SR   PC       OffSet Special_Word  ");
    printChar(179,1);
    printText(" \r\n");

    printChar(179,1);
    printChar(' ',1);

    // Mostra SR: 1 word
    itoa(*(errorBufferAddrBus + ix),sqtdtam,16);
    funcZeroesLeft(&sqtdtam, 4);
    printText(sqtdtam);
    ix++;
    printText(" ");

    // Mostra PC to Return: 2 words
    itoa(*(errorBufferAddrBus + ix),sqtdtam,16);
    funcZeroesLeft(&sqtdtam, 4);
    printText(sqtdtam);
    ix++;
    itoa(*(errorBufferAddrBus + ix),sqtdtam,16);
    funcZeroesLeft(&sqtdtam, 4);
    printText(sqtdtam);
    ix++;
    printText(" ");

    // Mostra Vector offset: 1 word
    itoa(*(errorBufferAddrBus + ix),sqtdtam,16);
    funcZeroesLeft(&sqtdtam, 4);
    printText(sqtdtam);
    ix++;
    printText("   ");

    // Mostra Special Status Word: 1 word
    itoa(*(errorBufferAddrBus + ix),sqtdtam,16);
    funcZeroesLeft(&sqtdtam, 4);
    printText(sqtdtam);
    ix++;
    printText("          ");
    printChar(179,1);
    printText("\r\n");
    printChar(179,1);
    printText("                                    ");
    printChar(179,1);
    printText("\r\n");

    printChar(179,1);
    printText(" FaultAddr OutB InB  Instr.InB      ");
    printChar(179,1);
    printText(" \r\n");

    printChar(179,1);
    printChar(' ',1);

    // Mostra Fault Address: 2 words
    itoa(*(errorBufferAddrBus + ix),sqtdtam,16);
    funcZeroesLeft(&sqtdtam, 4);
    printText(sqtdtam);
    ix++;
    itoa(*(errorBufferAddrBus + ix),sqtdtam,16);
    funcZeroesLeft(&sqtdtam, 4);
    printText(sqtdtam);
    ix++;
    printText("  ");

    // unused: 1 word
    ix++;

    // Mostra output buffer: 1 word
    itoa(*(errorBufferAddrBus + ix),sqtdtam,16);
    funcZeroesLeft(&sqtdtam, 4);
    printText(sqtdtam);
    ix++;
    printText(" ");

    // unused: 1 word
    ix++;

    // Mostra input buffer: 1 word
    itoa(*(errorBufferAddrBus + ix),sqtdtam,16);
    funcZeroesLeft(&sqtdtam, 4);
    printText(sqtdtam);
    ix++;
    printText(" ");

    // unused: 1 word
    ix++;
    // Mostra instruction input buffer: 1 word
    itoa(*(errorBufferAddrBus + ix),sqtdtam,16);
    funcZeroesLeft(&sqtdtam, 4);
    printText(sqtdtam);
    ix++;
    printText("           ");
    printChar(179,1);
    printText("\r\n");

    // Halt
    printChar(195,1);
    for (ix = 0; ix < 36; ix++)
        printChar(196,1);
    printChar(180,1);
    printText(" \r\n");
    printChar(179,1);
    printText("            SYSTEM HALTED           ");
    printChar(179,1);
    printText(" \r\n");
    printChar(192,1);
    for (ix = 0; ix < 36; ix++)
        printChar(196,1);
    printChar(217,1);
    printText(" \r\n");
    for(;;);
}
