moahrs/MMSJ300OS/basic.asm

; D:\PROJETOS\MMSJ300\PROGS_MONITOR\BASIC.C - Compiled by CC68K  Version 5.00 (c) 1991-2005  Peter J.Fondse
; /********************************************************************************
; *    Programa    : basic.c
; *    Objetivo    : MMSJ-Basic para o MMSJ300
; *    Criado em   : 10/10/2022
; *    Programador : Moacir Jr.
; *--------------------------------------------------------------------------------
; * Data        Versao  Responsavel  Motivo
; * 10/10/2022  0.1     Moacir Jr.   Criacao Versao Beta
; * 26/06/2023  0.4     Moacir Jr.   Simplificacoes e ajustres
; * 27/06/2023  0.4a    Moacir Jr.   Adaptar processos de for-next e if-then-else
; * 01/07/2023  0.4b    Moacir Jr.   Ajuste de Bugs
; * 03/07/2023  0.5     Moacir Jr.   Colocar Logica Ponto Flutuante
; * 10/07/2023  0.5a    Moacir Jr.   Colocar Funcoes Graficas
; * 11/07/2023  0.5b    Moacir Jr.   Colocar DATA-READ
; * 20/07/2023  1.0     Moacir Jr.   Versao para publicacao
; * 21/07/2023  1.0a    Moacir Jr.   Ajustes de memoria e bugs
; * 23/07/2023  1.0b    Moacir Jr.   Ajustes bugs no for...next e if...then
; * 24/07/2023  1.0c    Moacir Jr.   Retirada "BYE" message. Ajustes de bugs no gosub...return
; * 25/07/2023  1.0d    Moacir Jr.   Ajuste no basInputGet, quando Get, mandar 1 pro inputLine e sem manipulacoa cursor
; * 20/01/2024  1.0e    Moacir Jr.   Colocar para iniciar direto no Basic
; *--------------------------------------------------------------------------------
; * Variables Simples: start at 00800000
; *   --------------------------------------------------------
; *   Type ($ = String, # = Real, % = Integer)
; *   Name (2 Bytes, 1st and 2nd letters of the name)
; *   --------------- --------------- ------------------------
; *   Integer         Real            String
; *   --------------- --------------- ------------------------
; *   0x00            0x00            Length
; *   Value MSB       Value MSB       Pointer to String (High)
; *   Value           Value           Pointer to String
; *   Value           Value           Pointer to String
; *   Value LSB       Value LSB       Pointer to String (Low)
; *   --------------- --------------- ------------------------
; *   Total: 8 Bytes
; *--------------------------------------------------------------------------------
; *
; *--------------------------------------------------------------------------------
; * To do
; *
; *--------------------------------------------------------------------------------
; *
; *********************************************************************************/
; #include <ctype.h>
; #include <string.h>
; #include <stdlib.h>
; #include "../mmsj300api.h"
; #include "../monitor.h"
; #include "basic.h"
; #define versionBasic "1.0e"
; //#define __TESTE_TOKENIZE__ 1
; //-----------------------------------------------------------------------------
; // Principal
; //-----------------------------------------------------------------------------
; void main(void)
; {
       section   code
       xdef      _main
_main:
       movem.l   D2/A2/A3/A4/A5,-(A7)
       lea       _printText.L,A2
       lea       _pProcess.L,A3
       lea       _pTypeLine.L,A4
       lea       _vbuf.L,A5
; unsigned char vRetInput;
; // Timer para o Random
; *(vmfp + Reg_TADR) = 0xF5;  // 245
       move.l    _vmfp.L,A0
       move.w    _Reg_TADR.L,D0
       and.l     #65535,D0
       move.b    #245,0(A0,D0.L)
; *(vmfp + Reg_TACR) = 0x02;  // prescaler de 10. total 2,4576Mhz/10*245 = 1003KHz
       move.l    _vmfp.L,A0
       move.w    _Reg_TACR.L,D0
       and.l     #65535,D0
       move.b    #2,0(A0,D0.L)
; if (!*startBasic)
       move.l    _startBasic.L,A0
       tst.w     (A0)
       bne.s     main_1
; clearScr();
       jsr       _clearScr
main_1:
; printText("MMSJ-BASIC v"versionBasic);
       pea       @basic_95.L
       jsr       (A2)
       addq.w    #4,A7
; printText("\r\n\0");
       pea       @basic_96.L
       jsr       (A2)
       addq.w    #4,A7
; if (!*startBasic)
       move.l    _startBasic.L,A0
       tst.w     (A0)
       bne.s     main_3
; printText("Utility (c) 2022-2024\r\n\0");
       pea       @basic_97.L
       jsr       (A2)
       addq.w    #4,A7
main_3:
; printText("OK\r\n\0");
       pea       @basic_98.L
       jsr       (A2)
       addq.w    #4,A7
; *vBufReceived = 0x00;
       move.l    _vBufReceived.L,A0
       clr.b     (A0)
; *vbuf = '\0';
       move.l    (A5),A0
       clr.b     (A0)
; *pProcess = 0x01;
       move.l    (A3),A0
       move.b    #1,(A0)
; *pTypeLine = 0x00;
       move.l    (A4),A0
       clr.b     (A0)
; *nextAddrLine = pStartProg;
       move.l    _nextAddrLine.L,A0
       move.l    _pStartProg.L,(A0)
; *firstLineNumber = 0;
       move.l    _firstLineNumber.L,A0
       clr.w     (A0)
; *addrFirstLineNumber = 0;
       move.l    _addrFirstLineNumber.L,A0
       clr.l     (A0)
; *traceOn = 0;
       move.l    _traceOn.L,A0
       clr.b     (A0)
; *lastHgrX = 0;
       move.l    _lastHgrX.L,A0
       clr.b     (A0)
; *lastHgrY = 0;
       move.l    _lastHgrY.L,A0
       clr.b     (A0)
; *fgcolorAnt = *fgcolor;
       move.l    _fgcolor.L,A0
       move.l    _fgcolorAnt.L,A1
       move.b    (A0),(A1)
; *bgcolorAnt = *bgcolor;
       move.l    _bgcolor.L,A0
       move.l    _bgcolorAnt.L,A1
       move.b    (A0),(A1)
; while (*pProcess)
main_5:
       move.l    (A3),A0
       tst.b     (A0)
       beq       main_7
; {
; vRetInput = inputLine(128,'$');
       pea       36
       pea       128
       jsr       _inputLine
       addq.w    #8,A7
       move.b    D0,D2
; if (*vbuf != 0x00 && (vRetInput == 0x0D || vRetInput == 0x0A))
       move.l    (A5),A0
       move.b    (A0),D0
       beq       main_8
       cmp.b     #13,D2
       beq.s     main_10
       cmp.b     #10,D2
       bne       main_8
main_10:
; {
; printText("\r\n\0");
       pea       @basic_96.L
       jsr       (A2)
       addq.w    #4,A7
; processLine();
       jsr       _processLine
; if (!*pTypeLine && *pProcess)
       move.l    (A4),A0
       tst.b     (A0)
       bne.s     main_11
       move.l    (A3),A0
       tst.b     (A0)
       beq.s     main_11
; printText("\r\nOK\0");
       pea       @basic_99.L
       jsr       (A2)
       addq.w    #4,A7
main_11:
; *vBufReceived = 0x00;
       move.l    _vBufReceived.L,A0
       clr.b     (A0)
; *vbuf = '\0';
       move.l    (A5),A0
       clr.b     (A0)
; if (!*pTypeLine && *pProcess)
       move.l    (A4),A0
       tst.b     (A0)
       bne.s     main_13
       move.l    (A3),A0
       tst.b     (A0)
       beq.s     main_13
; printText("\r\n\0");   // printText("\r\n>\0");
       pea       @basic_96.L
       jsr       (A2)
       addq.w    #4,A7
main_13:
       bra.s     main_15
main_8:
; }
; else if (vRetInput != 0x1B)
       cmp.b     #27,D2
       beq.s     main_15
; {
; printText("\r\n\0");
       pea       @basic_96.L
       jsr       (A2)
       addq.w    #4,A7
main_15:
       bra       main_5
main_7:
; }
; }
; printText("\r\n\0");
       pea       @basic_96.L
       jsr       (A2)
       addq.w    #4,A7
       movem.l   (A7)+,D2/A2/A3/A4/A5
       rts
; }
; //-----------------------------------------------------------------------------
; //
; //-----------------------------------------------------------------------------
; void processLine(void)
; {
       xdef      _processLine
_processLine:
       link      A6,#-616
       movem.l   D2/D3/D4/D5/D6/D7/A2/A3/A4/A5,-(A7)
       lea       -614(A6),A2
       lea       -570(A6),A3
       lea       _comandLineTokenized.L,A4
       lea       _strcmp.L,A5
; unsigned char linhacomando[32], vloop, vToken;
; unsigned char *blin = vbuf;
       move.l    _vbuf.L,D4
; unsigned short varg = 0;
       clr.w     -580(A6)
; unsigned short ix, iy, iz, ikk, kt;
; unsigned short vbytepic = 0, vrecfim;
       clr.w     -576(A6)
; unsigned char cuntam, vLinhaArg[255], vparam2[16], vpicret;
; char vSpace = 0;
       clr.b     -297(A6)
; int vReta;
; typeInf vRetInf;
; unsigned short vTam = 0;
       clr.w     D5
; unsigned char *pSave = *nextAddrLine;
       move.l    _nextAddrLine.L,A0
       move.l    (A0),-34(A6)
; unsigned long vNextAddr = 0;
       clr.l     -30(A6)
; unsigned char vTimer;
; unsigned char vBuffer[20];
; unsigned char *vTempPointer;
; // Separar linha entre comando e argumento
; linhacomando[0] = '\0';
       clr.b     (A2)
; vLinhaArg[0] = '\0';
       clr.b     (A3)
; ix = 0;
       clr.w     D3
; iy = 0;
       clr.w     D2
; while (*blin)
processLine_1:
       move.l    D4,A0
       tst.b     (A0)
       beq       processLine_3
; {
; if (!varg && *blin >= 0x20 && *blin <= 0x2F)
       tst.w     -580(A6)
       bne.s     processLine_6
       moveq     #1,D0
       bra.s     processLine_7
processLine_6:
       clr.l     D0
processLine_7:
       and.l     #65535,D0
       beq       processLine_4
       move.l    D4,A0
       move.b    (A0),D0
       cmp.b     #32,D0
       blo       processLine_4
       move.l    D4,A0
       move.b    (A0),D0
       cmp.b     #47,D0
       bhi       processLine_4
; {
; varg = 0x01;
       move.w    #1,-580(A6)
; linhacomando[ix] = '\0';
       and.l     #65535,D3
       clr.b     0(A2,D3.L)
; iy = ix;
       move.w    D3,D2
; ix = 0;
       clr.w     D3
; if (*blin != 0x20)
       move.l    D4,A0
       move.b    (A0),D0
       cmp.b     #32,D0
       beq.s     processLine_8
; vLinhaArg[ix++] = *blin;
       move.l    D4,A0
       move.w    D3,D0
       addq.w    #1,D3
       and.l     #65535,D0
       move.b    (A0),0(A3,D0.L)
       bra.s     processLine_9
processLine_8:
; else
; vSpace = 1;
       move.b    #1,-297(A6)
processLine_9:
       bra.s     processLine_5
processLine_4:
; }
; else
; {
; if (!varg)
       tst.w     -580(A6)
       bne.s     processLine_10
; linhacomando[ix] = *blin;
       move.l    D4,A0
       and.l     #65535,D3
       move.b    (A0),0(A2,D3.L)
       bra.s     processLine_11
processLine_10:
; else
; vLinhaArg[ix] = *blin;
       move.l    D4,A0
       and.l     #65535,D3
       move.b    (A0),0(A3,D3.L)
processLine_11:
; ix++;
       addq.w    #1,D3
processLine_5:
; }
; *blin++;
       move.l    D4,A0
       addq.l    #1,D4
       bra       processLine_1
processLine_3:
; }
; if (!varg)
       tst.w     -580(A6)
       bne.s     processLine_12
; {
; linhacomando[ix] = '\0';
       and.l     #65535,D3
       clr.b     0(A2,D3.L)
; iy = ix;
       move.w    D3,D2
       bra.s     processLine_13
processLine_12:
; }
; else
; vLinhaArg[ix] = '\0';
       and.l     #65535,D3
       clr.b     0(A3,D3.L)
processLine_13:
; vpicret = 0;
       clr.b     -298(A6)
; // Processar e definir o que fazer
; if (linhacomando[0] != 0)
       move.b    (A2),D0
       beq       processLine_54
; {
; // Se for numero o inicio da linha, eh entrada de programa, senao eh comando direto
; if (linhacomando[0] >= 0x31 && linhacomando[0] <= 0x39) // 0 nao é um numero de linha valida
       move.b    (A2),D0
       cmp.b     #49,D0
       blo.s     processLine_16
       move.b    (A2),D0
       cmp.b     #57,D0
       bhi.s     processLine_16
; {
; *pTypeLine = 0x01;
       move.l    _pTypeLine.L,A0
       move.b    #1,(A0)
; // Entrada de programa
; tokenizeLine(vLinhaArg);
       move.l    A3,-(A7)
       jsr       _tokenizeLine
       addq.w    #4,A7
; saveLine(linhacomando, vLinhaArg);
       move.l    A3,-(A7)
       move.l    A2,-(A7)
       jsr       _saveLine
       addq.w    #8,A7
       bra       processLine_54
processLine_16:
; }
; else
; {
; *pTypeLine = 0x00;
       move.l    _pTypeLine.L,A0
       clr.b     (A0)
; for (iz = 0; iz < iy; iz++)
       moveq     #0,D7
processLine_18:
       cmp.w     D2,D7
       bhs.s     processLine_20
; linhacomando[iz] = toupper(linhacomando[iz]);
       and.l     #65535,D7
       move.b    0(A2,D7.L),D1
       and.l     #255,D1
       move.l    D1,-(A7)
       jsr       _toupper
       addq.w    #4,A7
       and.l     #65535,D7
       move.b    D0,0(A2,D7.L)
       addq.w    #1,D7
       bra       processLine_18
processLine_20:
; // Comando Direto
; if (!strcmp(linhacomando,"HOME") && iy == 4)
       pea       @basic_48.L
       move.l    A2,-(A7)
       jsr       (A5)
       addq.w    #8,A7
       tst.l     D0
       bne.s     processLine_21
       cmp.w     #4,D2
       bne.s     processLine_21
; {
; clearScr();
       jsr       _clearScr
       bra       processLine_54
processLine_21:
; }
; else if (!strcmp(linhacomando,"NEW") && iy == 3)
       pea       @basic_100.L
       move.l    A2,-(A7)
       jsr       (A5)
       addq.w    #8,A7
       tst.l     D0
       bne.s     processLine_23
       cmp.w     #3,D2
       bne.s     processLine_23
; {
; *pStartProg = 0x00;
       move.l    _pStartProg.L,A0
       clr.b     (A0)
; *(pStartProg + 1) = 0x00;
       move.l    _pStartProg.L,A0
       clr.b     1(A0)
; *(pStartProg + 2) = 0x00;
       move.l    _pStartProg.L,A0
       clr.b     2(A0)
; *nextAddrLine = pStartProg;
       move.l    _nextAddrLine.L,A0
       move.l    _pStartProg.L,(A0)
; *firstLineNumber = 0;
       move.l    _firstLineNumber.L,A0
       clr.w     (A0)
; *addrFirstLineNumber = 0;
       move.l    _addrFirstLineNumber.L,A0
       clr.l     (A0)
       bra       processLine_54
processLine_23:
; }
; else if (!strcmp(linhacomando,"EDIT") && iy == 4)
       pea       @basic_101.L
       move.l    A2,-(A7)
       jsr       (A5)
       addq.w    #8,A7
       tst.l     D0
       bne.s     processLine_25
       cmp.w     #4,D2
       bne.s     processLine_25
; {
; editLine(vLinhaArg);
       move.l    A3,-(A7)
       jsr       _editLine
       addq.w    #4,A7
       bra       processLine_54
processLine_25:
; }
; else if (!strcmp(linhacomando,"LIST") && iy == 4)
       pea       @basic_102.L
       move.l    A2,-(A7)
       jsr       (A5)
       addq.w    #8,A7
       tst.l     D0
       bne.s     processLine_27
       cmp.w     #4,D2
       bne.s     processLine_27
; {
; listProg(vLinhaArg, 0);
       clr.l     -(A7)
       move.l    A3,-(A7)
       jsr       _listProg
       addq.w    #8,A7
       bra       processLine_54
processLine_27:
; }
; else if (!strcmp(linhacomando,"LISTP") && iy == 5)
       pea       @basic_103.L
       move.l    A2,-(A7)
       jsr       (A5)
       addq.w    #8,A7
       tst.l     D0
       bne.s     processLine_29
       cmp.w     #5,D2
       bne.s     processLine_29
; {
; listProg(vLinhaArg, 1);
       pea       1
       move.l    A3,-(A7)
       jsr       _listProg
       addq.w    #8,A7
       bra       processLine_54
processLine_29:
; }
; else if (!strcmp(linhacomando,"RUN") && iy == 3)
       pea       @basic_104.L
       move.l    A2,-(A7)
       jsr       (A5)
       addq.w    #8,A7
       tst.l     D0
       bne.s     processLine_31
       cmp.w     #3,D2
       bne.s     processLine_31
; {
; runProg(vLinhaArg);
       move.l    A3,-(A7)
       jsr       _runProg
       addq.w    #4,A7
       bra       processLine_54
processLine_31:
; }
; else if (!strcmp(linhacomando,"DEL") && iy == 3)
       pea       @basic_105.L
       move.l    A2,-(A7)
       jsr       (A5)
       addq.w    #8,A7
       tst.l     D0
       bne.s     processLine_33
       cmp.w     #3,D2
       bne.s     processLine_33
; {
; delLine(vLinhaArg);
       move.l    A3,-(A7)
       jsr       _delLine
       addq.w    #4,A7
       bra       processLine_54
processLine_33:
; }
; else if (!strcmp(linhacomando,"XLOAD") && iy == 5)
       pea       @basic_106.L
       move.l    A2,-(A7)
       jsr       (A5)
       addq.w    #8,A7
       tst.l     D0
       bne.s     processLine_35
       cmp.w     #5,D2
       bne.s     processLine_35
; {
; basXBasLoad();
       jsr       _basXBasLoad
       bra       processLine_54
processLine_35:
; }
; else if (!strcmp(linhacomando,"TIMER") && iy == 5)
       pea       @basic_107.L
       move.l    A2,-(A7)
       jsr       (A5)
       addq.w    #8,A7
       tst.l     D0
       bne       processLine_37
       cmp.w     #5,D2
       bne       processLine_37
; {
; // Ler contador A do 68901
; vTimer = *(vmfp + Reg_TADR);
       move.l    _vmfp.L,A0
       move.w    _Reg_TADR.L,D0
       and.l     #65535,D0
       move.b    0(A0,D0.L),-25(A6)
; // Devolve pra tela
; itoa(vTimer,vBuffer,10);
       pea       10
       pea       -24(A6)
       move.b    -25(A6),D1
       and.l     #255,D1
       move.l    D1,-(A7)
       jsr       _itoa
       add.w     #12,A7
; printText("Timer: ");
       pea       @basic_108.L
       jsr       _printText
       addq.w    #4,A7
; printText(vBuffer);
       pea       -24(A6)
       jsr       _printText
       addq.w    #4,A7
; printText("ms\r\n\0");
       pea       @basic_109.L
       jsr       _printText
       addq.w    #4,A7
       bra       processLine_54
processLine_37:
; }
; else if (!strcmp(linhacomando,"TRACE") && iy == 5)
       pea       @basic_110.L
       move.l    A2,-(A7)
       jsr       (A5)
       addq.w    #8,A7
       tst.l     D0
       bne.s     processLine_39
       cmp.w     #5,D2
       bne.s     processLine_39
; {
; *traceOn = 1;
       move.l    _traceOn.L,A0
       move.b    #1,(A0)
       bra       processLine_54
processLine_39:
; }
; else if (!strcmp(linhacomando,"NOTRACE") && iy == 7)
       pea       @basic_111.L
       move.l    A2,-(A7)
       jsr       (A5)
       addq.w    #8,A7
       tst.l     D0
       bne.s     processLine_41
       cmp.w     #7,D2
       bne.s     processLine_41
; {
; *traceOn = 0;
       move.l    _traceOn.L,A0
       clr.b     (A0)
       bra       processLine_54
processLine_41:
; }
; // *************************************************
; // ESSE COMANDO NAO VAI EXISTIR QUANDO FOR PRA BIOS
; // *************************************************
; else if (!strcmp(linhacomando,"QUIT") && iy == 4)
       pea       @basic_112.L
       move.l    A2,-(A7)
       jsr       (A5)
       addq.w    #8,A7
       tst.l     D0
       bne.s     processLine_43
       cmp.w     #4,D2
       bne.s     processLine_43
; {
; *pProcess = 0x00;
       move.l    _pProcess.L,A0
       clr.b     (A0)
       bra       processLine_54
processLine_43:
; }
; // *************************************************
; // *************************************************
; // *************************************************
; else
; {
; // Tokeniza a linha toda
; strcpy(vRetInf.tString, linhacomando);
       move.l    A2,-(A7)
       lea       -292(A6),A0
       move.l    A0,-(A7)
       jsr       _strcpy
       addq.w    #8,A7
; if (vSpace)
       tst.b     -297(A6)
       beq.s     processLine_45
; strcat(vRetInf.tString, " ");
       pea       @basic_113.L
       lea       -292(A6),A0
       move.l    A0,-(A7)
       jsr       _strcat
       addq.w    #8,A7
processLine_45:
; strcat(vRetInf.tString, vLinhaArg);
       move.l    A3,-(A7)
       lea       -292(A6),A0
       move.l    A0,-(A7)
       jsr       _strcat
       addq.w    #8,A7
; tokenizeLine(vRetInf.tString);
       lea       -292(A6),A0
       move.l    A0,-(A7)
       jsr       _tokenizeLine
       addq.w    #4,A7
; strcpy(vLinhaArg, vRetInf.tString);
       lea       -292(A6),A0
       move.l    A0,-(A7)
       move.l    A3,-(A7)
       jsr       _strcpy
       addq.w    #8,A7
; // Salva a linha pra ser interpretada
; vTam = strlen(vLinhaArg);
       move.l    A3,-(A7)
       jsr       _strlen
       addq.w    #4,A7
       move.w    D0,D5
; vNextAddr = comandLineTokenized + (vTam + 6);
       move.l    (A4),D0
       move.w    D5,D1
       addq.w    #6,D1
       and.l     #65535,D1
       add.l     D1,D0
       move.l    D0,-30(A6)
; *comandLineTokenized = ((vNextAddr & 0xFF0000) >> 16);
       move.l    -30(A6),D0
       and.l     #16711680,D0
       lsr.l     #8,D0
       lsr.l     #8,D0
       move.l    (A4),A0
       move.b    D0,(A0)
; *(comandLineTokenized + 1) = ((vNextAddr & 0xFF00) >> 8);
       move.l    -30(A6),D0
       and.l     #65280,D0
       lsr.l     #8,D0
       move.l    (A4),A0
       move.b    D0,1(A0)
; *(comandLineTokenized + 2) =  (vNextAddr & 0xFF);
       move.l    -30(A6),D0
       and.l     #255,D0
       move.l    (A4),A0
       move.b    D0,2(A0)
; // Grava numero da linha
; *(comandLineTokenized + 3) = 0xFF;
       move.l    (A4),A0
       move.b    #255,3(A0)
; *(comandLineTokenized + 4) = 0xFF;
       move.l    (A4),A0
       move.b    #255,4(A0)
; // Grava linha tokenizada
; for(kt = 0; kt < vTam; kt++)
       clr.w     D6
processLine_47:
       cmp.w     D5,D6
       bhs.s     processLine_49
; *(comandLineTokenized + (kt + 5)) = vLinhaArg[kt];
       and.l     #65535,D6
       move.l    (A4),A0
       move.w    D6,D0
       addq.w    #5,D0
       and.l     #65535,D0
       move.b    0(A3,D6.L),0(A0,D0.L)
       addq.w    #1,D6
       bra       processLine_47
processLine_49:
; // Grava final linha 0x00
; *(comandLineTokenized + (vTam + 5)) = 0x00;
       move.l    (A4),A0
       move.w    D5,D0
       addq.w    #5,D0
       and.l     #65535,D0
       clr.b     0(A0,D0.L)
; *(comandLineTokenized + (vTam + 6)) = 0x00;
       move.l    (A4),A0
       move.w    D5,D0
       addq.w    #6,D0
       and.l     #65535,D0
       clr.b     0(A0,D0.L)
; *(comandLineTokenized + (vTam + 7)) = 0x00;
       move.l    (A4),A0
       move.w    D5,D0
       addq.w    #7,D0
       and.l     #65535,D0
       clr.b     0(A0,D0.L)
; *(comandLineTokenized + (vTam + 8)) = 0x00;
       move.l    (A4),A0
       move.w    D5,D0
       addq.w    #8,D0
       and.l     #65535,D0
       clr.b     0(A0,D0.L)
; *nextAddrSimpVar = pStartSimpVar;
       move.l    _nextAddrSimpVar.L,A0
       move.l    _pStartSimpVar.L,(A0)
; *nextAddrArrayVar = pStartArrayVar;
       move.l    _nextAddrArrayVar.L,A0
       move.l    _pStartArrayVar.L,(A0)
; *nextAddrString = pStartString;
       move.l    _nextAddrString.L,A0
       move.l    _pStartString.L,(A0)
; *vMaisTokens = 0;
       move.l    _vMaisTokens.L,A0
       clr.b     (A0)
; *vParenteses = 0x00;
       move.l    _vParenteses.L,A0
       clr.b     (A0)
; *vTemIf = 0x00;
       move.l    _vTemIf.L,A0
       clr.b     (A0)
; *vTemThen = 0;
       move.l    _vTemThen.L,A0
       clr.b     (A0)
; *vTemElse = 0;
       move.l    _vTemElse.L,A0
       clr.b     (A0)
; *vTemIfAndOr = 0x00;
       move.l    _vTemIfAndOr.L,A0
       clr.b     (A0)
; *pointerRunProg = comandLineTokenized + 5;
       move.l    (A4),D0
       addq.l    #5,D0
       move.l    _pointerRunProg.L,A0
       move.l    D0,(A0)
; vRetInf.tString[0] = 0x00;
       lea       -292(A6),A0
       clr.b     (A0)
; *ftos=0;
       move.l    _ftos.L,A0
       clr.l     (A0)
; *gtos=0;
       move.l    _gtos.L,A0
       clr.l     (A0)
; *vErroProc = 0;
       move.l    _vErroProc.L,A0
       clr.w     (A0)
; *randSeed = *(vmfp + Reg_TADR);
       move.l    _vmfp.L,A0
       move.w    _Reg_TADR.L,D0
       and.l     #65535,D0
       move.b    0(A0,D0.L),D0
       and.l     #255,D0
       move.l    _randSeed.L,A0
       move.l    D0,(A0)
; do
; {
processLine_50:
; *doisPontos = 0;
       move.l    _doisPontos.L,A0
       clr.b     (A0)
; *vInicioSentenca = 1;
       move.l    _vInicioSentenca.L,A0
       move.b    #1,(A0)
; vTempPointer = *pointerRunProg;
       move.l    _pointerRunProg.L,A0
       move.l    (A0),-4(A6)
; *pointerRunProg = *pointerRunProg + 1;
       move.l    _pointerRunProg.L,A0
       addq.l    #1,(A0)
; vReta = executeToken(*vTempPointer);
       move.l    -4(A6),A0
       move.b    (A0),D1
       and.l     #255,D1
       move.l    D1,-(A7)
       jsr       _executeToken
       addq.w    #4,A7
       move.l    D0,-296(A6)
       move.l    _doisPontos.L,A0
       tst.b     (A0)
       bne       processLine_50
; } while (*doisPontos);
; #ifndef __TESTE_TOKENIZE__
; if (*vdp_mode != VDP_MODE_TEXT)
       move.l    _vdp_mode.L,A0
       move.b    (A0),D0
       cmp.b     #3,D0
       beq.s     processLine_52
; basText();
       jsr       _basText
processLine_52:
; #endif
; if (*vErroProc)
       move.l    _vErroProc.L,A0
       tst.w     (A0)
       beq.s     processLine_54
; {
; showErrorMessage(*vErroProc, 0);
       clr.l     -(A7)
       move.l    _vErroProc.L,A0
       move.w    (A0),D1
       and.l     #65535,D1
       move.l    D1,-(A7)
       jsr       _showErrorMessage
       addq.w    #8,A7
processLine_54:
       movem.l   (A7)+,D2/D3/D4/D5/D6/D7/A2/A3/A4/A5
       unlk      A6
       rts
; }
; }
; }
; }
; }
; //-----------------------------------------------------------------------------
; // Transforma linha em tokens, se existirem
; //-----------------------------------------------------------------------------
; void tokenizeLine(unsigned char *pTokenized)
; {
       xdef      _tokenizeLine
_tokenizeLine:
       link      A6,#-828
       movem.l   D2/D3/D4/D5/D6/D7/A2/A3/A4/A5,-(A7)
       lea       -828(A6),A2
       lea       -310(A6),A3
       lea       @basic_keywords.L,A4
       lea       -572(A6),A5
; unsigned char vLido[255], vLidoCaps[255], vAspas, vAchou = 0;
       clr.b     -315(A6)
; unsigned char *blin = pTokenized;
       move.l    8(A6),D3
; unsigned short ix, iy, kt, iz, iw;
; unsigned char vToken, vLinhaArg[255], vparam2[16], vpicret;
; char vbuffer [sizeof(long)*8+1];
; char vFirstComp = 0;
       moveq     #0,D7
; char isToken;
; char vTemRem = 0;
       clr.b     -1(A6)
; //    unsigned char sqtdtam[20];
; // Separar linha entre comando e argumento
; vLinhaArg[0] = '\0';
       clr.b     (A3)
; vLido[0]  = '\0';
       clr.b     (A2)
; ix = 0;
       clr.w     D4
; iy = 0;
       clr.w     D5
; vAspas = 0;
       clr.b     -316(A6)
; while (1)
tokenizeLine_1:
; {
; vLido[ix] = '\0';
       and.l     #65535,D4
       clr.b     0(A2,D4.L)
; if (*blin == 0x22)
       move.l    D3,A0
       move.b    (A0),D0
       cmp.b     #34,D0
       bne.s     tokenizeLine_4
; vAspas = !vAspas;
       tst.b     -316(A6)
       bne.s     tokenizeLine_6
       moveq     #1,D0
       bra.s     tokenizeLine_7
tokenizeLine_6:
       clr.l     D0
tokenizeLine_7:
       move.b    D0,-316(A6)
tokenizeLine_4:
; // Se for quebrador sequencia, verifica se é um token
; if ((!vTemRem && !vAspas && strchr(" ;,+-<>()/*^=:",*blin)) || !*blin)
       tst.b     -1(A6)
       bne.s     tokenizeLine_12
       moveq     #1,D0
       bra.s     tokenizeLine_13
tokenizeLine_12:
       clr.l     D0
tokenizeLine_13:
       tst.b     D0
       beq.s     tokenizeLine_11
       tst.b     -316(A6)
       bne.s     tokenizeLine_11
       move.l    D3,A0
       move.b    (A0),D1
       and.l     #255,D1
       move.l    D1,-(A7)
       pea       @basic_114.L
       jsr       _strchr
       addq.w    #8,A7
       tst.l     D0
       bne.s     tokenizeLine_10
tokenizeLine_11:
       move.l    D3,A0
       tst.b     (A0)
       bne.s     tokenizeLine_14
       moveq     #1,D0
       bra.s     tokenizeLine_15
tokenizeLine_14:
       clr.l     D0
tokenizeLine_15:
       and.l     #255,D0
       beq       tokenizeLine_8
tokenizeLine_10:
; {
; // Montar comparacoes "<>", ">=" e "<="
; if (((*blin == 0x3C || *blin == 0x3E) && (!vFirstComp && (*(blin + 1) == 0x3E || *(blin + 1) == 0x3D))) || (vFirstComp && *blin == 0x3D) || (vFirstComp && *blin == 0x3E))
       move.l    D3,A0
       move.b    (A0),D0
       cmp.b     #60,D0
       beq.s     tokenizeLine_20
       move.l    D3,A0
       move.b    (A0),D0
       cmp.b     #62,D0
       bne       tokenizeLine_21
tokenizeLine_20:
       tst.b     D7
       bne.s     tokenizeLine_22
       moveq     #1,D0
       bra.s     tokenizeLine_23
tokenizeLine_22:
       clr.l     D0
tokenizeLine_23:
       ext.w     D0
       ext.l     D0
       tst.l     D0
       beq.s     tokenizeLine_21
       move.l    D3,A0
       move.b    1(A0),D0
       cmp.b     #62,D0
       beq       tokenizeLine_18
       move.l    D3,A0
       move.b    1(A0),D0
       cmp.b     #61,D0
       beq       tokenizeLine_18
tokenizeLine_21:
       ext.w     D7
       ext.l     D7
       tst.l     D7
       beq.s     tokenizeLine_24
       move.l    D3,A0
       move.b    (A0),D0
       cmp.b     #61,D0
       beq.s     tokenizeLine_18
tokenizeLine_24:
       ext.w     D7
       ext.l     D7
       tst.l     D7
       beq       tokenizeLine_16
       move.l    D3,A0
       move.b    (A0),D0
       cmp.b     #62,D0
       bne       tokenizeLine_16
tokenizeLine_18:
; {
; if (!vFirstComp)
       tst.b     D7
       bne.s     tokenizeLine_25
; {
; for(kt = 0; kt < ix; kt++)
       clr.w     D2
tokenizeLine_27:
       cmp.w     D4,D2
       bhs.s     tokenizeLine_29
; vLinhaArg[iy++] = vLido[kt];
       and.l     #65535,D2
       move.w    D5,D0
       addq.w    #1,D5
       and.l     #65535,D0
       move.b    0(A2,D2.L),0(A3,D0.L)
       addq.w    #1,D2
       bra       tokenizeLine_27
tokenizeLine_29:
; vLido[0] = 0x00;
       clr.b     (A2)
; ix = 0;
       clr.w     D4
; vFirstComp = 1;
       moveq     #1,D7
tokenizeLine_25:
; }
; vLido[ix++] = *blin;
       move.l    D3,A0
       move.w    D4,D0
       addq.w    #1,D4
       and.l     #65535,D0
       move.b    (A0),0(A2,D0.L)
; if (ix < 2)
       cmp.w     #2,D4
       bhs.s     tokenizeLine_30
; {
; blin++;
       addq.l    #1,D3
; continue;
       bra       tokenizeLine_2
tokenizeLine_30:
; }
; vFirstComp = 0;
       moveq     #0,D7
tokenizeLine_16:
; }
; if (vLido[0])
       tst.b     (A2)
       beq       tokenizeLine_32
; {
; vToken = 0;
       clr.b     D6
; /*writeLongSerial("Aqui 332.666.2-[");
; itoa(ix,sqtdtam,10);
; writeLongSerial(sqtdtam);
; writeLongSerial("]-[");
; itoa(*blin,sqtdtam,16);
; writeLongSerial(sqtdtam);
; writeLongSerial("]\r\n");*/
; if (ix > 1)
       cmp.w     #1,D4
       bls       tokenizeLine_41
; {
; // Transforma em Caps pra comparar com os tokens
; for (kt = 0; kt < ix; kt++)
       clr.w     D2
tokenizeLine_36:
       cmp.w     D4,D2
       bhs.s     tokenizeLine_38
; vLidoCaps[kt] = toupper(vLido[kt]);
       and.l     #65535,D2
       move.b    0(A2,D2.L),D1
       and.l     #255,D1
       move.l    D1,-(A7)
       jsr       _toupper
       addq.w    #4,A7
       and.l     #65535,D2
       move.b    D0,0(A5,D2.L)
       addq.w    #1,D2
       bra       tokenizeLine_36
tokenizeLine_38:
; vLidoCaps[ix] = 0x00;
       and.l     #65535,D4
       clr.b     0(A5,D4.L)
; iz = strlen(vLidoCaps);
       move.l    A5,-(A7)
       jsr       _strlen
       addq.w    #4,A7
       move.w    D0,-314(A6)
; // Compara pra ver se é um token
; for(kt = 0; kt < keywords_count; kt++)
       clr.w     D2
tokenizeLine_39:
       and.l     #65535,D2
       cmp.l     _keywords_count.L,D2
       bhs       tokenizeLine_41
; {
; iw = strlen(keywords[kt].keyword);
       and.l     #65535,D2
       move.l    D2,D1
       lsl.l     #3,D1
       move.l    0(A4,D1.L),-(A7)
       jsr       _strlen
       addq.w    #4,A7
       move.w    D0,-312(A6)
; if (iw == 2 && iz == iw)
       move.w    -312(A6),D0
       cmp.w     #2,D0
       bne       tokenizeLine_42
       move.w    -314(A6),D0
       cmp.w     -312(A6),D0
       bne       tokenizeLine_42
; {
; if (vLidoCaps[0] == keywords[kt].keyword[0] && vLidoCaps[1] == keywords[kt].keyword[1])
       and.l     #65535,D2
       move.l    D2,D0
       lsl.l     #3,D0
       move.l    0(A4,D0.L),A0
       move.b    (A5),D0
       cmp.b     (A0),D0
       bne.s     tokenizeLine_44
       and.l     #65535,D2
       move.l    D2,D0
       lsl.l     #3,D0
       move.l    0(A4,D0.L),A0
       move.b    1(A5),D0
       cmp.b     1(A0),D0
       bne.s     tokenizeLine_44
; {
; vToken = keywords[kt].token;
       and.l     #65535,D2
       move.l    D2,D0
       lsl.l     #3,D0
       lea       0(A4,D0.L),A0
       move.l    4(A0),D0
       move.b    D0,D6
; break;
       bra       tokenizeLine_41
tokenizeLine_44:
       bra       tokenizeLine_48
tokenizeLine_42:
; }
; }
; else if (iz==iw)
       move.w    -314(A6),D0
       cmp.w     -312(A6),D0
       bne       tokenizeLine_48
; {
; if (strncmp(vLidoCaps, keywords[kt].keyword, iw) == 0)
       move.w    -312(A6),D1
       and.l     #65535,D1
       move.l    D1,-(A7)
       and.l     #65535,D2
       move.l    D2,D1
       lsl.l     #3,D1
       move.l    0(A4,D1.L),-(A7)
       move.l    A5,-(A7)
       jsr       _strncmp
       add.w     #12,A7
       tst.l     D0
       bne.s     tokenizeLine_48
; {
; vToken = keywords[kt].token;
       and.l     #65535,D2
       move.l    D2,D0
       lsl.l     #3,D0
       lea       0(A4,D0.L),A0
       move.l    4(A0),D0
       move.b    D0,D6
; break;
       bra.s     tokenizeLine_41
tokenizeLine_48:
       addq.w    #1,D2
       bra       tokenizeLine_39
tokenizeLine_41:
; }
; }
; }
; }
; if (vToken)
       tst.b     D6
       beq       tokenizeLine_50
; {
; if (vToken == 0x8C) // REM
       and.w     #255,D6
       cmp.w     #140,D6
       bne.s     tokenizeLine_52
; vTemRem = 1;
       move.b    #1,-1(A6)
tokenizeLine_52:
; vLinhaArg[iy++] = vToken;
       move.w    D5,D0
       addq.w    #1,D5
       and.l     #65535,D0
       move.b    D6,0(A3,D0.L)
; //if (*blin == 0x28 || *blin == 0x29)
; //    vLinhaArg[iy++] = *blin;
; //if (*blin == 0x3A)  // :
; if (*blin && *blin != 0x20 && vToken < 0xF0 && !vTemRem)
       move.l    D3,A0
       move.b    (A0),D0
       and.l     #255,D0
       beq       tokenizeLine_54
       move.l    D3,A0
       move.b    (A0),D0
       cmp.b     #32,D0
       beq       tokenizeLine_54
       and.w     #255,D6
       cmp.w     #240,D6
       bhs       tokenizeLine_54
       tst.b     -1(A6)
       bne.s     tokenizeLine_56
       moveq     #1,D0
       bra.s     tokenizeLine_57
tokenizeLine_56:
       clr.l     D0
tokenizeLine_57:
       ext.w     D0
       ext.l     D0
       tst.l     D0
       beq.s     tokenizeLine_54
; vLinhaArg[iy++] = toupper(*blin);
       move.l    D3,A0
       move.b    (A0),D1
       and.l     #255,D1
       move.l    D1,-(A7)
       jsr       _toupper
       addq.w    #4,A7
       move.w    D5,D1
       addq.w    #1,D5
       and.l     #65535,D1
       move.b    D0,0(A3,D1.L)
tokenizeLine_54:
       bra       tokenizeLine_61
tokenizeLine_50:
; }
; else
; {
; for(kt = 0; kt < ix; kt++)
       clr.w     D2
tokenizeLine_58:
       cmp.w     D4,D2
       bhs.s     tokenizeLine_60
; vLinhaArg[iy++] = vLido[kt];
       and.l     #65535,D2
       move.w    D5,D0
       addq.w    #1,D5
       and.l     #65535,D0
       move.b    0(A2,D2.L),0(A3,D0.L)
       addq.w    #1,D2
       bra       tokenizeLine_58
tokenizeLine_60:
; if (*blin && *blin != 0x20)
       move.l    D3,A0
       move.b    (A0),D0
       and.l     #255,D0
       beq.s     tokenizeLine_61
       move.l    D3,A0
       move.b    (A0),D0
       cmp.b     #32,D0
       beq.s     tokenizeLine_61
; vLinhaArg[iy++] = toupper(*blin);
       move.l    D3,A0
       move.b    (A0),D1
       and.l     #255,D1
       move.l    D1,-(A7)
       jsr       _toupper
       addq.w    #4,A7
       move.w    D5,D1
       addq.w    #1,D5
       and.l     #65535,D1
       move.b    D0,0(A3,D1.L)
tokenizeLine_61:
       bra       tokenizeLine_63
tokenizeLine_32:
; }
; }
; else
; {
; if (*blin && *blin != 0x20)
       move.l    D3,A0
       move.b    (A0),D0
       and.l     #255,D0
       beq.s     tokenizeLine_63
       move.l    D3,A0
       move.b    (A0),D0
       cmp.b     #32,D0
       beq.s     tokenizeLine_63
; vLinhaArg[iy++] = toupper(*blin);
       move.l    D3,A0
       move.b    (A0),D1
       and.l     #255,D1
       move.l    D1,-(A7)
       jsr       _toupper
       addq.w    #4,A7
       move.w    D5,D1
       addq.w    #1,D5
       and.l     #65535,D1
       move.b    D0,0(A3,D1.L)
tokenizeLine_63:
; }
; if (!*blin)
       move.l    D3,A0
       tst.b     (A0)
       bne.s     tokenizeLine_65
; break;
       bra       tokenizeLine_3
tokenizeLine_65:
; vLido[0] = '\0';
       clr.b     (A2)
; ix = 0;
       clr.w     D4
       bra       tokenizeLine_68
tokenizeLine_8:
; }
; else
; {
; if (!vAspas && !vTemRem)
       tst.b     -316(A6)
       bne       tokenizeLine_67
       tst.b     -1(A6)
       bne.s     tokenizeLine_69
       moveq     #1,D0
       bra.s     tokenizeLine_70
tokenizeLine_69:
       clr.l     D0
tokenizeLine_70:
       tst.b     D0
       beq.s     tokenizeLine_67
; vLido[ix++] = toupper(*blin);
       move.l    D3,A0
       move.b    (A0),D1
       and.l     #255,D1
       move.l    D1,-(A7)
       jsr       _toupper
       addq.w    #4,A7
       move.w    D4,D1
       addq.w    #1,D4
       and.l     #65535,D1
       move.b    D0,0(A2,D1.L)
       bra.s     tokenizeLine_68
tokenizeLine_67:
; else
; vLido[ix++] = *blin;
       move.l    D3,A0
       move.w    D4,D0
       addq.w    #1,D4
       and.l     #65535,D0
       move.b    (A0),0(A2,D0.L)
tokenizeLine_68:
; }
; blin++;
       addq.l    #1,D3
tokenizeLine_2:
       bra       tokenizeLine_1
tokenizeLine_3:
; }
; vLinhaArg[iy] = 0x00;
       and.l     #65535,D5
       clr.b     0(A3,D5.L)
; for(kt = 0; kt < iy; kt++)
       clr.w     D2
tokenizeLine_71:
       cmp.w     D5,D2
       bhs.s     tokenizeLine_73
; pTokenized[kt] = vLinhaArg[kt];
       and.l     #65535,D2
       move.l    8(A6),A0
       and.l     #65535,D2
       move.b    0(A3,D2.L),0(A0,D2.L)
       addq.w    #1,D2
       bra       tokenizeLine_71
tokenizeLine_73:
; pTokenized[iy] = 0x00;
       move.l    8(A6),A0
       and.l     #65535,D5
       clr.b     0(A0,D5.L)
       movem.l   (A7)+,D2/D3/D4/D5/D6/D7/A2/A3/A4/A5
       unlk      A6
       rts
; }
; //-----------------------------------------------------------------------------
; // Salva a linha no formato:
; // NN NN NN LL LL xxxxxxxxxxxx 00
; // onde:
; //      NN NN NN         = endereco da proxima linha
; //      LL LL            = Numero da linha
; //      xxxxxxxxxxxxxx   = Linha Tokenizada
; //      00               = Indica fim da linha
; //-----------------------------------------------------------------------------
; void saveLine(unsigned char *pNumber, unsigned char *pTokenized)
; {
       xdef      _saveLine
_saveLine:
       link      A6,#-4
       movem.l   D2/D3/D4/D5/D6/D7/A2/A3/A4/A5,-(A7)
       lea       _nextAddrLine.L,A2
       lea       _firstLineNumber.L,A5
; unsigned short vTam = 0, kt;
       move.w    #0,A3
; unsigned char *pSave = *nextAddrLine;
       move.l    (A2),A0
       move.l    (A0),D5
; unsigned long vNextAddr = 0, vAntAddr = 0, vNextAddr2 = 0;
       clr.l     D4
       moveq     #0,D7
       move.w    #0,A4
; unsigned short vNumLin = 0;
       clr.w     D3
; unsigned char *pAtu = *nextAddrLine, *pLast = *nextAddrLine;
       move.l    (A2),A0
       move.l    (A0),D2
       move.l    (A2),A0
       move.l    (A0),D6
; vNumLin = atoi(pNumber);
       move.l    8(A6),-(A7)
       jsr       _atoi
       addq.w    #4,A7
       move.w    D0,D3
; if (*firstLineNumber == 0)
       move.l    (A5),A0
       move.w    (A0),D0
       bne.s     saveLine_1
; {
; *firstLineNumber = vNumLin;
       move.l    (A5),A0
       move.w    D3,(A0)
; *addrFirstLineNumber = pStartProg;
       move.l    _addrFirstLineNumber.L,A0
       move.l    _pStartProg.L,(A0)
       bra       saveLine_3
saveLine_1:
; }
; else
; {
; vNextAddr = findNumberLine(vNumLin, 0, 0);
       clr.l     -(A7)
       clr.l     -(A7)
       and.l     #65535,D3
       move.l    D3,-(A7)
       jsr       _findNumberLine
       add.w     #12,A7
       move.l    D0,D4
; if (vNextAddr > 0)
       cmp.l     #0,D4
       bls       saveLine_3
; {
; pAtu = vNextAddr;
       move.l    D4,D2
; if (((*(pAtu + 3) << 8) | *(pAtu + 4)) == vNumLin)
       move.l    D2,A0
       move.b    3(A0),D0
       lsl.b     #8,D0
       move.l    D2,A0
       or.b      4(A0),D0
       and.w     #255,D0
       cmp.w     D3,D0
       bne.s     saveLine_5
; {
; printText("Line number already exists\r\n\0");
       pea       @basic_115.L
       jsr       _printText
       addq.w    #4,A7
; return;
       bra       saveLine_8
saveLine_5:
; }
; vAntAddr = findNumberLine(vNumLin, 1, 0);
       clr.l     -(A7)
       pea       1
       and.l     #65535,D3
       move.l    D3,-(A7)
       jsr       _findNumberLine
       add.w     #12,A7
       move.l    D0,D7
saveLine_3:
; }
; }
; vTam = strlen(pTokenized);
       move.l    12(A6),-(A7)
       jsr       _strlen
       addq.w    #4,A7
       move.w    D0,A3
; if (vTam)
       move.w    A3,D0
       beq       saveLine_8
; {
; // Calcula nova posicao da proxima linha
; if (vNextAddr == 0)
       tst.l     D4
       bne.s     saveLine_10
; {
; *nextAddrLine += (vTam + 6);
       move.l    (A2),A0
       move.l    A3,D0
       addq.l    #6,D0
       add.l     D0,(A0)
; vNextAddr = *nextAddrLine;
       move.l    (A2),A0
       move.l    (A0),D4
; *addrLastLineNumber = pSave;
       move.l    _addrLastLineNumber.L,A0
       move.l    D5,(A0)
       bra       saveLine_11
saveLine_10:
; }
; else
; {
; if (*firstLineNumber > vNumLin)
       move.l    (A5),A0
       cmp.w     (A0),D3
       bhs.s     saveLine_12
; {
; *firstLineNumber = vNumLin;
       move.l    (A5),A0
       move.w    D3,(A0)
; *addrFirstLineNumber = *nextAddrLine;
       move.l    (A2),A0
       move.l    _addrFirstLineNumber.L,A1
       move.l    (A0),(A1)
saveLine_12:
; }
; *nextAddrLine += (vTam + 6);
       move.l    (A2),A0
       move.l    A3,D0
       addq.l    #6,D0
       add.l     D0,(A0)
; vNextAddr2 = *nextAddrLine;
       move.l    (A2),A0
       move.l    (A0),A4
; if (vAntAddr != vNextAddr)
       cmp.l     D4,D7
       beq       saveLine_14
; {
; pLast = vAntAddr;
       move.l    D7,D6
; vAntAddr = pSave;
       move.l    D5,D7
; *pLast       = ((vAntAddr & 0xFF0000) >> 16);
       move.l    D7,D0
       and.l     #16711680,D0
       lsr.l     #8,D0
       lsr.l     #8,D0
       move.l    D6,A0
       move.b    D0,(A0)
; *(pLast + 1) = ((vAntAddr & 0xFF00) >> 8);
       move.l    D7,D0
       and.l     #65280,D0
       lsr.l     #8,D0
       move.l    D6,A0
       move.b    D0,1(A0)
; *(pLast + 2) =  (vAntAddr & 0xFF);
       move.l    D7,D0
       and.l     #255,D0
       move.l    D6,A0
       move.b    D0,2(A0)
saveLine_14:
; }
; pLast = *addrLastLineNumber;
       move.l    _addrLastLineNumber.L,A0
       move.l    (A0),D6
; *pLast       = ((vNextAddr2 & 0xFF0000) >> 16);
       move.l    A4,D0
       and.l     #16711680,D0
       lsr.l     #8,D0
       lsr.l     #8,D0
       move.l    D6,A0
       move.b    D0,(A0)
; *(pLast + 1) = ((vNextAddr2 & 0xFF00) >> 8);
       move.l    A4,D0
       and.l     #65280,D0
       lsr.l     #8,D0
       move.l    D6,A0
       move.b    D0,1(A0)
; *(pLast + 2) =  (vNextAddr2 & 0xFF);
       move.l    A4,D0
       and.l     #255,D0
       move.l    D6,A0
       move.b    D0,2(A0)
saveLine_11:
; }
; pAtu = *nextAddrLine;
       move.l    (A2),A0
       move.l    (A0),D2
; *pAtu       = 0x00;
       move.l    D2,A0
       clr.b     (A0)
; *(pAtu + 1) = 0x00;
       move.l    D2,A0
       clr.b     1(A0)
; *(pAtu + 2) = 0x00;
       move.l    D2,A0
       clr.b     2(A0)
; *(pAtu + 3) = 0x00;
       move.l    D2,A0
       clr.b     3(A0)
; *(pAtu + 4) = 0x00;
       move.l    D2,A0
       clr.b     4(A0)
; // Grava endereco proxima linha
; *pSave++ = ((vNextAddr & 0xFF0000) >> 16);
       move.l    D4,D0
       and.l     #16711680,D0
       lsr.l     #8,D0
       lsr.l     #8,D0
       move.l    D5,A0
       addq.l    #1,D5
       move.b    D0,(A0)
; *pSave++ = ((vNextAddr & 0xFF00) >> 8);
       move.l    D4,D0
       and.l     #65280,D0
       lsr.l     #8,D0
       move.l    D5,A0
       addq.l    #1,D5
       move.b    D0,(A0)
; *pSave++ =  (vNextAddr & 0xFF);
       move.l    D4,D0
       and.l     #255,D0
       move.l    D5,A0
       addq.l    #1,D5
       move.b    D0,(A0)
; // Grava numero da linha
; *pSave++ = ((vNumLin & 0xFF00) >> 8);
       move.w    D3,D0
       and.w     #65280,D0
       lsr.w     #8,D0
       move.l    D5,A0
       addq.l    #1,D5
       move.b    D0,(A0)
; *pSave++ = (vNumLin & 0xFF);
       move.w    D3,D0
       and.w     #255,D0
       move.l    D5,A0
       addq.l    #1,D5
       move.b    D0,(A0)
; // Grava linha tokenizada
; for(kt = 0; kt < vTam; kt++)
       clr.w     -2(A6)
saveLine_16:
       move.w    A3,D0
       cmp.w     -2(A6),D0
       bls.s     saveLine_18
; *pSave++ = *pTokenized++;
       move.l    12(A6),A0
       addq.l    #1,12(A6)
       move.l    D5,A1
       addq.l    #1,D5
       move.b    (A0),(A1)
       addq.w    #1,-2(A6)
       bra       saveLine_16
saveLine_18:
; // Grava final linha 0x00
; *pSave = 0x00;
       move.l    D5,A0
       clr.b     (A0)
saveLine_8:
       movem.l   (A7)+,D2/D3/D4/D5/D6/D7/A2/A3/A4/A5
       unlk      A6
       rts
; }
; }
; //-----------------------------------------------------------------------------
; // Sintaxe:
; //      LIST                : lista tudo
; //      LIST <num>          : lista só a linha <num>
; //      LIST <num>-         : lista a partir da linha <num>
; //      LIST <numA>-<numB>  : lista o intervalo de <numA> até <numB>, inclusive
; //
; //      LISTP : mesmo que LIST, mas com pausa a cada scroll
; //-----------------------------------------------------------------------------
; void listProg(unsigned char *pArg, unsigned short pPause)
; {
       xdef      _listProg
_listProg:
       link      A6,#-300
       movem.l   D2/D3/D4/D5/D6/D7/A2/A3/A4/A5,-(A7)
       lea       -270(A6),A2
       move.l    8(A6),D5
       lea       -14(A6),A3
; // Default listar tudo
; unsigned short pIni = 0, pFim = 0xFFFF;
       clr.w     -298(A6)
       move.w    #65535,A5
; unsigned char *vStartList = pStartProg;
       move.l    _pStartProg.L,D3
; unsigned long vNextList;
; unsigned short vNumLin;
; char sNumLin [sizeof(short)*8+1], vFirstByte;
; unsigned char vtec;
; unsigned char vLinhaList[255], sNumPar[10], vToken;
; int iw, ix, iy, iz, vPauseRowCounter;
; //    unsigned char sqtdtam[20];
; if (pArg[0] != 0x00 && strchr(pArg,'-') != 0x00)
       move.l    D5,A0
       move.b    (A0),D0
       beq       listProg_1
       pea       45
       move.l    D5,-(A7)
       jsr       _strchr
       addq.w    #8,A7
       tst.l     D0
       beq       listProg_1
; {
; ix = 0;
       clr.l     D2
; iy = 0;
       clr.l     D4
; // listar intervalo
; while (pArg[ix] != '-')
listProg_3:
       move.l    D5,A0
       move.b    0(A0,D2.L),D0
       cmp.b     #45,D0
       beq.s     listProg_5
; sNumPar[iy++] = pArg[ix++];
       move.l    D5,A0
       move.l    D2,D0
       addq.l    #1,D2
       move.l    D4,D1
       addq.l    #1,D4
       move.b    0(A0,D0.L),0(A3,D1.L)
       bra       listProg_3
listProg_5:
; sNumPar[iy] = 0x00;
       clr.b     0(A3,D4.L)
; pIni = atoi(sNumPar);
       move.l    A3,-(A7)
       jsr       _atoi
       addq.w    #4,A7
       move.w    D0,-298(A6)
; iy = 0;
       clr.l     D4
; ix++;
       addq.l    #1,D2
; while (pArg[ix])
listProg_6:
       move.l    D5,A0
       tst.b     0(A0,D2.L)
       beq.s     listProg_8
; sNumPar[iy++] = pArg[ix++];
       move.l    D5,A0
       move.l    D2,D0
       addq.l    #1,D2
       move.l    D4,D1
       addq.l    #1,D4
       move.b    0(A0,D0.L),0(A3,D1.L)
       bra       listProg_6
listProg_8:
; sNumPar[iy] = 0x00;
       clr.b     0(A3,D4.L)
; if (sNumPar[0])
       tst.b     (A3)
       beq.s     listProg_9
; pFim = atoi(sNumPar);
       move.l    A3,-(A7)
       jsr       _atoi
       addq.w    #4,A7
       move.w    D0,A5
       bra.s     listProg_10
listProg_9:
; else
; pFim = 0xFFFF;
       move.w    #65535,A5
listProg_10:
       bra.s     listProg_11
listProg_1:
; }
; else if (pArg[0] != 0x00)
       move.l    D5,A0
       move.b    (A0),D0
       beq.s     listProg_11
; {
; // listar 1 linha
; pIni = atoi(pArg);
       move.l    D5,-(A7)
       jsr       _atoi
       addq.w    #4,A7
       move.w    D0,-298(A6)
; pFim = pIni;
       move.w    -298(A6),A5
listProg_11:
; }
; vStartList = findNumberLine(pIni, 0, 0);
       clr.l     -(A7)
       clr.l     -(A7)
       move.w    -298(A6),D1
       and.l     #65535,D1
       move.l    D1,-(A7)
       jsr       _findNumberLine
       add.w     #12,A7
       move.l    D0,D3
; // Nao achou numero de linha inicial
; if (!vStartList)
       tst.l     D3
       bne.s     listProg_13
; {
; printText("Non-existent line number\r\n\0");
       pea       @basic_116.L
       jsr       _printText
       addq.w    #4,A7
; return;
       bra       listProg_18
listProg_13:
; }
; vNextList = vStartList;
       move.l    D3,-296(A6)
; vPauseRowCounter = 0;
       move.w    #0,A4
; while (1)
listProg_16:
; {
; // Guarda proxima posicao
; vNextList = (*(vStartList) << 16) | (*(vStartList + 1) << 8) | *(vStartList + 2);
       move.l    D3,A0
       move.b    (A0),D0
       and.l     #255,D0
       lsl.l     #8,D0
       lsl.l     #8,D0
       move.l    D3,A0
       move.b    1(A0),D1
       and.l     #255,D1
       lsl.l     #8,D1
       or.l      D1,D0
       move.l    D3,A0
       move.b    2(A0),D1
       and.l     #255,D1
       or.l      D1,D0
       move.l    D0,-296(A6)
; if (vNextList)
       tst.l     -296(A6)
       beq       listProg_19
; {
; // Pega numero da linha
; vNumLin = (*(vStartList + 3) << 8) | *(vStartList + 4);
       move.l    D3,A0
       move.b    3(A0),D0
       and.w     #255,D0
       lsl.w     #8,D0
       move.l    D3,A0
       move.b    4(A0),D1
       and.w     #255,D1
       or.w      D1,D0
       move.w    D0,-292(A6)
; if (vNumLin > pFim)
       move.w    A5,D0
       cmp.w     -292(A6),D0
       bhs.s     listProg_21
; break;
       bra       listProg_18
listProg_21:
; vStartList += 5;
       addq.l    #5,D3
; ix = 0;
       clr.l     D2
; // Coloca numero da linha na listagem
; itoa(vNumLin, sNumLin, 10);
       pea       10
       pea       -290(A6)
       move.w    -292(A6),D1
       and.l     #65535,D1
       move.l    D1,-(A7)
       jsr       _itoa
       add.w     #12,A7
; iz = 0;
       moveq     #0,D7
; while (sNumLin[iz])
listProg_23:
       lea       -290(A6),A0
       tst.b     0(A0,D7.L)
       beq.s     listProg_25
; {
; vLinhaList[ix++] = sNumLin[iz++];
       move.l    D7,D0
       addq.l    #1,D7
       lea       -290(A6),A0
       move.l    D2,D1
       addq.l    #1,D2
       move.b    0(A0,D0.L),0(A2,D1.L)
       bra       listProg_23
listProg_25:
; }
; vLinhaList[ix++] = 0x20;
       move.l    D2,D0
       addq.l    #1,D2
       move.b    #32,0(A2,D0.L)
; vFirstByte = 1;
       move.b    #1,-272(A6)
; // Pega caracter a caracter da linha
; while (*vStartList)
listProg_26:
       move.l    D3,A0
       tst.b     (A0)
       beq       listProg_28
; {
; vToken = *vStartList++;
       move.l    D3,A0
       addq.l    #1,D3
       move.b    (A0),D6
; // Verifica se é token, se for, muda pra escrito
; if (vToken >= 0x80)
       and.w     #255,D6
       cmp.w     #128,D6
       blo       listProg_29
; {
; // Procura token na lista
; iy = findToken(vToken);
       and.l     #255,D6
       move.l    D6,-(A7)
       jsr       _findToken
       addq.w    #4,A7
       move.l    D0,D4
; iz = 0;
       moveq     #0,D7
; if (!vFirstByte)
       tst.b     -272(A6)
       bne       listProg_31
; {
; if (isalphas(*(vStartList - 2)) || isdigitus(*(vStartList - 2)) || *(vStartList - 2) == ')')
       move.l    D3,D1
       subq.l    #2,D1
       move.l    D1,A0
       move.b    (A0),D1
       and.l     #255,D1
       move.l    D1,-(A7)
       jsr       _isalphas
       addq.w    #4,A7
       tst.l     D0
       bne       listProg_35
       move.l    D3,D1
       subq.l    #2,D1
       move.l    D1,A0
       move.b    (A0),D1
       and.l     #255,D1
       move.l    D1,-(A7)
       jsr       _isdigitus
       addq.w    #4,A7
       tst.l     D0
       bne.s     listProg_35
       move.l    D3,D0
       subq.l    #2,D0
       move.l    D0,A0
       move.b    (A0),D0
       cmp.b     #41,D0
       bne.s     listProg_33
listProg_35:
; vLinhaList[ix++] = 0x20;
       move.l    D2,D0
       addq.l    #1,D2
       move.b    #32,0(A2,D0.L)
listProg_33:
       bra.s     listProg_32
listProg_31:
; }
; else
; vFirstByte = 0;
       clr.b     -272(A6)
listProg_32:
; while (keywords[iy].keyword[iz])
listProg_36:
       move.l    D4,D0
       lsl.l     #3,D0
       lea       @basic_keywords.L,A0
       move.l    0(A0,D0.L),A0
       tst.b     0(A0,D7.L)
       beq.s     listProg_38
; {
; vLinhaList[ix++] = keywords[iy].keyword[iz++];
       move.l    D4,D0
       lsl.l     #3,D0
       lea       @basic_keywords.L,A0
       move.l    0(A0,D0.L),A0
       move.l    D7,D0
       addq.l    #1,D7
       move.l    D2,D1
       addq.l    #1,D2
       move.b    0(A0,D0.L),0(A2,D1.L)
       bra       listProg_36
listProg_38:
; }
; // Se nao for intervalo de funcao, coloca espaço depois do comando
; if (*vStartList != '=' && (vToken < 0xC0 || vToken > 0xEF))
       move.l    D3,A0
       move.b    (A0),D0
       cmp.b     #61,D0
       beq.s     listProg_39
       and.w     #255,D6
       cmp.w     #192,D6
       blo.s     listProg_41
       and.w     #255,D6
       cmp.w     #239,D6
       bls.s     listProg_39
listProg_41:
; vLinhaList[ix++] = 0x20;
       move.l    D2,D0
       addq.l    #1,D2
       move.b    #32,0(A2,D0.L)
listProg_39:
       bra.s     listProg_42
listProg_29:
; /*                    if (*vStartList != 0x28)
; vLinhaList[ix++] = 0x20;*/
; }
; else
; {
; // Apenas inclui na listagem
; //if (strchr("+-*^/=;:><", *vTempPointer) || *vTempPointer >= 0xF0)
; vLinhaList[ix++] = vToken;
       move.l    D2,D0
       addq.l    #1,D2
       move.b    D6,0(A2,D0.L)
; // Se nao for aspas e o proximo for um token, inclui um espaço
; if (vToken == 0x22 && *vStartList >=0x80)
       cmp.b     #34,D6
       bne.s     listProg_42
       move.l    D3,A0
       move.b    (A0),D0
       and.w     #255,D0
       cmp.w     #128,D0
       blo.s     listProg_42
; vLinhaList[ix++] = 0x20;
       move.l    D2,D0
       addq.l    #1,D2
       move.b    #32,0(A2,D0.L)
listProg_42:
       bra       listProg_26
listProg_28:
; /*if (isdigitus(vToken) && *vStartList!=')' && *vStartList!='.' && *vStartList!='"' && !isdigitus(*vStartList))
; vLinhaList[ix++] = 0x20;*/
; }
; }
; vLinhaList[ix] = '\0';
       clr.b     0(A2,D2.L)
; iw = strlen(vLinhaList) / 40;
       move.l    A2,-(A7)
       jsr       _strlen
       addq.w    #4,A7
       move.l    D0,-(A7)
       pea       40
       jsr       LDIV
       move.l    (A7),D0
       addq.w    #8,A7
       move.l    D0,-4(A6)
; vLinhaList[ix++] = '\r';
       move.l    D2,D0
       addq.l    #1,D2
       move.b    #13,0(A2,D0.L)
; vLinhaList[ix++] = '\n';
       move.l    D2,D0
       addq.l    #1,D2
       move.b    #10,0(A2,D0.L)
; vLinhaList[ix++] = '\0';
       move.l    D2,D0
       addq.l    #1,D2
       clr.b     0(A2,D0.L)
; printText(vLinhaList);
       move.l    A2,-(A7)
       jsr       _printText
       addq.w    #4,A7
; vPauseRowCounter = vPauseRowCounter + 1 + iw;
       move.l    A4,D0
       addq.l    #1,D0
       add.l     -4(A6),D0
       move.l    D0,A4
; /*writeLongSerial("Aqui 332.666.0-[");
; itoa(pPause,sqtdtam,10);
; writeLongSerial(sqtdtam);
; writeLongSerial("]-[");
; itoa(vPauseRowCounter,sqtdtam,10);
; writeLongSerial(sqtdtam);
; writeLongSerial("]-[");
; itoa(iw,sqtdtam,10);
; writeLongSerial(sqtdtam);
; writeLongSerial("]-[");
; itoa(*videoCursorPosRowY,sqtdtam,10);
; writeLongSerial(sqtdtam);
; writeLongSerial("]-[");
; itoa(*videoCursorPosRow,sqtdtam,10);
; writeLongSerial(sqtdtam);
; writeLongSerial("]\r\n");*/
; if (pPause && vPauseRowCounter >= *vdpMaxRows)
       move.w    14(A6),D0
       and.l     #65535,D0
       beq       listProg_46
       move.l    _vdpMaxRows.L,A0
       move.b    (A0),D0
       and.l     #255,D0
       move.l    A4,D1
       cmp.l     D0,D1
       blo       listProg_46
; {
; printText("press any key to continue\0");
       pea       @basic_117.L
       jsr       _printText
       addq.w    #4,A7
; vtec = inputLine(1,"@");
       pea       @basic_118.L
       pea       1
       jsr       _inputLine
       addq.w    #8,A7
       move.b    D0,-271(A6)
; vPauseRowCounter = 0;
       move.w    #0,A4
; printText("\r\n\0");
       pea       @basic_96.L
       jsr       _printText
       addq.w    #4,A7
; if (vtec == 0x1B)   // ESC
       move.b    -271(A6),D0
       cmp.b     #27,D0
       bne.s     listProg_46
; break;
       bra.s     listProg_18
listProg_46:
; }
; vStartList = vNextList;
       move.l    -296(A6),D3
       bra.s     listProg_20
listProg_19:
; }
; else
; break;
       bra.s     listProg_18
listProg_20:
       bra       listProg_16
listProg_18:
       movem.l   (A7)+,D2/D3/D4/D5/D6/D7/A2/A3/A4/A5
       unlk      A6
       rts
; }
; }
; //-----------------------------------------------------------------------------
; // Sintaxe:
; //      DEL <num>          : apaga só a linha <num>
; //      DEL <num>-         : apaga a partir da linha <num> até o fim
; //      DEL <numA>-<numB>  : apaga o intervalo de <numA> até <numB>, inclusive
; //-----------------------------------------------------------------------------
; void delLine(unsigned char *pArg)
; {
       xdef      _delLine
_delLine:
       link      A6,#-300
       movem.l   D2/D3/D4/D5/D6/D7/A2/A3/A4/A5,-(A7)
       move.l    8(A6),D4
       lea       -16(A6),A2
       lea       _pStartProg.L,A3
; unsigned short pIni = 0, pFim = 0xFFFF;
       move.w    #0,A5
       move.w    #65535,A4
; unsigned char *vStartList = pStartProg;
       move.l    (A3),D2
; unsigned long vDelAddr, vAntAddr, vNewAddr;
; unsigned short vNumLin;
; char sNumLin [sizeof(short)*8+1];
; unsigned char vLinhaList[255], sNumPar[10], vToken;
; int ix, iy, iz;
; if (pArg[0] != 0x00 && strchr(pArg,'-') != 0x00)
       move.l    D4,A0
       move.b    (A0),D0
       beq       delLine_1
       pea       45
       move.l    D4,-(A7)
       jsr       _strchr
       addq.w    #8,A7
       tst.l     D0
       beq       delLine_1
; {
; ix = 0;
       moveq     #0,D7
; iy = 0;
       clr.l     D6
; // listar intervalo
; while (pArg[ix] != '-')
delLine_3:
       move.l    D4,A0
       move.b    0(A0,D7.L),D0
       cmp.b     #45,D0
       beq.s     delLine_5
; sNumPar[iy++] = pArg[ix++];
       move.l    D4,A0
       move.l    D7,D0
       addq.l    #1,D7
       move.l    D6,D1
       addq.l    #1,D6
       move.b    0(A0,D0.L),0(A2,D1.L)
       bra       delLine_3
delLine_5:
; sNumPar[iy] = 0x00;
       clr.b     0(A2,D6.L)
; pIni = atoi(sNumPar);
       move.l    A2,-(A7)
       jsr       _atoi
       addq.w    #4,A7
       move.w    D0,A5
; iy = 0;
       clr.l     D6
; ix++;
       addq.l    #1,D7
; while (pArg[ix])
delLine_6:
       move.l    D4,A0
       tst.b     0(A0,D7.L)
       beq.s     delLine_8
; sNumPar[iy++] = pArg[ix++];
       move.l    D4,A0
       move.l    D7,D0
       addq.l    #1,D7
       move.l    D6,D1
       addq.l    #1,D6
       move.b    0(A0,D0.L),0(A2,D1.L)
       bra       delLine_6
delLine_8:
; sNumPar[iy] = 0x00;
       clr.b     0(A2,D6.L)
; if (sNumPar[0])
       tst.b     (A2)
       beq.s     delLine_9
; pFim = atoi(sNumPar);
       move.l    A2,-(A7)
       jsr       _atoi
       addq.w    #4,A7
       move.w    D0,A4
       bra.s     delLine_10
delLine_9:
; else
; pFim = 0xFFFF;
       move.w    #65535,A4
delLine_10:
       bra.s     delLine_12
delLine_1:
; }
; else if (pArg[0] != 0x00)
       move.l    D4,A0
       move.b    (A0),D0
       beq.s     delLine_11
; {
; pIni = atoi(pArg);
       move.l    D4,-(A7)
       jsr       _atoi
       addq.w    #4,A7
       move.w    D0,A5
; pFim = pIni;
       move.w    A5,A4
       bra.s     delLine_12
delLine_11:
; }
; else
; {
; printText("Syntax Error !");
       pea       @basic_119.L
       jsr       _printText
       addq.w    #4,A7
; return;
       bra       delLine_18
delLine_12:
; }
; vDelAddr = findNumberLine(pIni, 0, 1);
       pea       1
       clr.l     -(A7)
       move.l    A5,-(A7)
       jsr       _findNumberLine
       add.w     #12,A7
       move.l    D0,-298(A6)
; if (!vDelAddr)
       tst.l     -298(A6)
       bne.s     delLine_14
; {
; printText("Non-existent line number\r\n\0");
       pea       @basic_116.L
       jsr       _printText
       addq.w    #4,A7
; return;
       bra       delLine_18
delLine_14:
; }
; while (1)
delLine_16:
; {
; vStartList = vDelAddr;
       move.l    -298(A6),D2
; // Guarda proxima posicao
; vNewAddr = (*(vStartList) << 16) | (*(vStartList + 1) << 8) | *(vStartList + 2);
       move.l    D2,A0
       move.b    (A0),D0
       and.l     #255,D0
       lsl.l     #8,D0
       lsl.l     #8,D0
       move.l    D2,A0
       move.b    1(A0),D1
       and.l     #255,D1
       lsl.l     #8,D1
       or.l      D1,D0
       move.l    D2,A0
       move.b    2(A0),D1
       and.l     #255,D1
       or.l      D1,D0
       move.l    D0,D3
; if (!vNewAddr)
       tst.l     D3
       bne.s     delLine_19
; break;
       bra       delLine_18
delLine_19:
; // Pega numero da linha
; vNumLin = (*(vStartList + 3) << 8) | *(vStartList + 4);
       move.l    D2,A0
       move.b    3(A0),D0
       and.w     #255,D0
       lsl.w     #8,D0
       move.l    D2,A0
       move.b    4(A0),D1
       and.w     #255,D1
       or.w      D1,D0
       move.w    D0,D5
; if (vNumLin > pFim)
       cmp.w     A4,D5
       bls.s     delLine_21
; break;
       bra       delLine_18
delLine_21:
; vAntAddr = findNumberLine(vNumLin, 1, 1);
       pea       1
       pea       1
       and.l     #65535,D5
       move.l    D5,-(A7)
       jsr       _findNumberLine
       add.w     #12,A7
       move.l    D0,-294(A6)
; // Apaga a linha atual
; *vStartList       = 0x00;
       move.l    D2,A0
       clr.b     (A0)
; *(vStartList + 1) = 0x00;
       move.l    D2,A0
       clr.b     1(A0)
; *(vStartList + 2) = 0x00;
       move.l    D2,A0
       clr.b     2(A0)
; *(vStartList + 3) = 0x00;
       move.l    D2,A0
       clr.b     3(A0)
; *(vStartList + 4) = 0x00;
       move.l    D2,A0
       clr.b     4(A0)
; vStartList += 5;
       addq.l    #5,D2
; while (*vStartList)
delLine_23:
       move.l    D2,A0
       tst.b     (A0)
       beq.s     delLine_25
; *vStartList++ = 0x00;
       move.l    D2,A0
       addq.l    #1,D2
       clr.b     (A0)
       bra       delLine_23
delLine_25:
; vStartList = vAntAddr;
       move.l    -294(A6),D2
; *vStartList++ = ((vNewAddr & 0xFF0000) >> 16);
       move.l    D3,D0
       and.l     #16711680,D0
       lsr.l     #8,D0
       lsr.l     #8,D0
       move.l    D2,A0
       addq.l    #1,D2
       move.b    D0,(A0)
; *vStartList++ = ((vNewAddr & 0xFF00) >> 8);
       move.l    D3,D0
       and.l     #65280,D0
       lsr.l     #8,D0
       move.l    D2,A0
       addq.l    #1,D2
       move.b    D0,(A0)
; *vStartList++ =  (vNewAddr & 0xFF);
       move.l    D3,D0
       and.l     #255,D0
       move.l    D2,A0
       addq.l    #1,D2
       move.b    D0,(A0)
; // Se for a primeira linha, reposiciona na proxima
; if (*firstLineNumber == vNumLin)
       move.l    _firstLineNumber.L,A0
       cmp.w     (A0),D5
       bne       delLine_29
; {
; if (vNewAddr)
       tst.l     D3
       beq.s     delLine_28
; {
; vStartList = vNewAddr;
       move.l    D3,D2
; // Pega numero da linha
; vNumLin = (*(vStartList + 3) << 8) | *(vStartList + 4);
       move.l    D2,A0
       move.b    3(A0),D0
       and.w     #255,D0
       lsl.w     #8,D0
       move.l    D2,A0
       move.b    4(A0),D1
       and.w     #255,D1
       or.w      D1,D0
       move.w    D0,D5
; *firstLineNumber = vNumLin;
       move.l    _firstLineNumber.L,A0
       move.w    D5,(A0)
; *addrFirstLineNumber = vNewAddr;
       move.l    _addrFirstLineNumber.L,A0
       move.l    D3,(A0)
       bra.s     delLine_29
delLine_28:
; }
; else
; {
; *pStartProg = 0x00;
       move.l    (A3),A0
       clr.b     (A0)
; *(pStartProg + 1) = 0x00;
       move.l    (A3),A0
       clr.b     1(A0)
; *(pStartProg + 2) = 0x00;
       move.l    (A3),A0
       clr.b     2(A0)
; *nextAddrLine = pStartProg;
       move.l    _nextAddrLine.L,A0
       move.l    (A3),(A0)
; *firstLineNumber = 0;
       move.l    _firstLineNumber.L,A0
       clr.w     (A0)
; *addrFirstLineNumber = 0;
       move.l    _addrFirstLineNumber.L,A0
       clr.l     (A0)
delLine_29:
; }
; }
; if (!vNewAddr)
       tst.l     D3
       bne.s     delLine_30
; break;
       bra.s     delLine_18
delLine_30:
; vDelAddr = vNewAddr;
       move.l    D3,-298(A6)
       bra       delLine_16
delLine_18:
       movem.l   (A7)+,D2/D3/D4/D5/D6/D7/A2/A3/A4/A5
       unlk      A6
       rts
; }
; }
; //-----------------------------------------------------------------------------
; // Sintaxe:
; //      EDIT <num>          : Edita conteudo da linha <num>
; //-----------------------------------------------------------------------------
; void editLine(unsigned char *pNumber)
; {
       xdef      _editLine
_editLine:
       link      A6,#-304
       movem.l   D2/D3/D4/D5/D6/D7/A2/A3/A4/A5,-(A7)
       lea       _vbuf.L,A2
       lea       -266(A6),A3
       lea       _printText.L,A4
; int pIni = 0, ix, iy, iz, iw, ivv, vNumLin, pFim;
       clr.l     -304(A6)
; unsigned char *vStartList = pStartProg, *vNextList;
       move.l    _pStartProg.L,D2
; unsigned char vRetInput;
; char sNumLin [sizeof(short)*8+1], vFirstByte;
; unsigned char vLinhaList[255], sNumPar[10], vToken;
; if (pNumber[0] != 0x00)
       move.l    8(A6),A0
       move.b    (A0),D0
       beq.s     editLine_1
; {
; // rodar desde uma linha especifica
; pIni = atoi(pNumber);
       move.l    8(A6),-(A7)
       jsr       _atoi
       addq.w    #4,A7
       move.l    D0,-304(A6)
       bra.s     editLine_2
editLine_1:
; }
; else
; {
; printText("Syntax Error !");
       pea       @basic_119.L
       jsr       (A4)
       addq.w    #4,A7
; return;
       bra       editLine_38
editLine_2:
; }
; vStartList = findNumberLine(pIni, 0, 0);
       clr.l     -(A7)
       clr.l     -(A7)
       move.l    -304(A6),D1
       and.l     #65535,D1
       move.l    D1,-(A7)
       jsr       _findNumberLine
       add.w     #12,A7
       move.l    D0,D2
; // Nao achou numero de linha inicial
; if (!vStartList)
       tst.l     D2
       bne.s     editLine_4
; {
; printText("Non-existent line number\r\n\0");
       pea       @basic_116.L
       jsr       (A4)
       addq.w    #4,A7
; return;
       bra       editLine_38
editLine_4:
; }
; // Carrega a linha no buffer
; // Guarda proxima posicao
; vNextList = (*(vStartList) << 16) | (*(vStartList + 1) << 8) | *(vStartList + 2);
       move.l    D2,A0
       move.b    (A0),D0
       and.l     #255,D0
       lsl.l     #8,D0
       lsl.l     #8,D0
       move.l    D2,A0
       move.b    1(A0),D1
       and.l     #255,D1
       lsl.l     #8,D1
       or.l      D1,D0
       move.l    D2,A0
       move.b    2(A0),D1
       and.l     #255,D1
       or.l      D1,D0
       move.l    D0,-288(A6)
; ix = 0;
       clr.l     D5
; ivv = 0;
       clr.l     D4
; if (vNextList)
       tst.l     -288(A6)
       beq       editLine_13
; {
; // Pega numero da linha
; vNumLin = (*(vStartList + 3) << 8) | *(vStartList + 4);
       move.l    D2,A0
       move.b    3(A0),D0
       and.l     #255,D0
       lsl.l     #8,D0
       move.l    D2,A0
       move.b    4(A0),D1
       and.l     #255,D1
       or.l      D1,D0
       move.l    D0,-296(A6)
; vStartList += 5;
       addq.l    #5,D2
; // Coloca numero da linha na listagem
; itoa(vNumLin, sNumLin, 10);
       pea       10
       pea       -284(A6)
       move.l    -296(A6),-(A7)
       jsr       _itoa
       add.w     #12,A7
; iz = 0;
       clr.l     D3
; while (sNumLin[iz++])
editLine_8:
       move.l    D3,D0
       addq.l    #1,D3
       lea       -284(A6),A0
       tst.b     0(A0,D0.L)
       beq.s     editLine_10
; {
; vLinhaList[ivv] = sNumLin[ivv];
       lea       -284(A6),A0
       move.b    0(A0,D4.L),0(A3,D4.L)
; ivv++;
       addq.l    #1,D4
       bra       editLine_8
editLine_10:
; }
; vLinhaList[ivv] = '\r';
       move.b    #13,0(A3,D4.L)
; vLinhaList[ivv + 1] = '\n';
       move.l    D4,A0
       move.b    #10,1(A0,A3.L)
; vLinhaList[ivv + 2] = '\0';
       move.l    D4,A0
       clr.b     2(A0,A3.L)
; printText(vLinhaList);
       move.l    A3,-(A7)
       jsr       (A4)
       addq.w    #4,A7
; vFirstByte = 1;
       move.b    #1,-267(A6)
; vbuf[ix] = 0x00;
       move.l    (A2),A0
       clr.b     0(A0,D5.L)
; ix = 0;
       clr.l     D5
; // Pega caracter a caracter da linha
; while (*vStartList)
editLine_11:
       move.l    D2,A0
       tst.b     (A0)
       beq       editLine_13
; {
; vToken = *vStartList++;
       move.l    D2,A0
       addq.l    #1,D2
       move.b    (A0),D6
; // Verifica se é token, se for, muda pra escrito
; if (vToken >= 0x80)
       and.w     #255,D6
       cmp.w     #128,D6
       blo       editLine_14
; {
; // Procura token na lista
; iy = findToken(vToken);
       and.l     #255,D6
       move.l    D6,-(A7)
       jsr       _findToken
       addq.w    #4,A7
       move.l    D0,A5
; iz = 0;
       clr.l     D3
; if (!vFirstByte)
       tst.b     -267(A6)
       bne       editLine_16
; {
; if (isalphas(*(vStartList - 2)) || isdigitus(*(vStartList - 2)) || *(vStartList - 2) == ')')
       move.l    D2,D1
       subq.l    #2,D1
       move.l    D1,A0
       move.b    (A0),D1
       and.l     #255,D1
       move.l    D1,-(A7)
       jsr       _isalphas
       addq.w    #4,A7
       tst.l     D0
       bne       editLine_20
       move.l    D2,D1
       subq.l    #2,D1
       move.l    D1,A0
       move.b    (A0),D1
       and.l     #255,D1
       move.l    D1,-(A7)
       jsr       _isdigitus
       addq.w    #4,A7
       tst.l     D0
       bne.s     editLine_20
       move.l    D2,D0
       subq.l    #2,D0
       move.l    D0,A0
       move.b    (A0),D0
       cmp.b     #41,D0
       bne.s     editLine_18
editLine_20:
; vbuf[ix++] = 0x20;
       move.l    (A2),A0
       move.l    D5,D0
       addq.l    #1,D5
       move.b    #32,0(A0,D0.L)
editLine_18:
       bra.s     editLine_17
editLine_16:
; }
; else
; vFirstByte = 0;
       clr.b     -267(A6)
editLine_17:
; while (keywords[iy].keyword[iz])
editLine_21:
       move.l    A5,D0
       lsl.l     #3,D0
       lea       @basic_keywords.L,A0
       move.l    0(A0,D0.L),A0
       tst.b     0(A0,D3.L)
       beq.s     editLine_23
; {
; vbuf[ix++] = keywords[iy].keyword[iz++];
       move.l    A5,D0
       lsl.l     #3,D0
       lea       @basic_keywords.L,A0
       move.l    0(A0,D0.L),A0
       move.l    D3,D0
       addq.l    #1,D3
       move.l    (A2),A1
       move.l    D5,D1
       addq.l    #1,D5
       move.b    0(A0,D0.L),0(A1,D1.L)
       bra       editLine_21
editLine_23:
; }
; // Se nao for intervalo de funcao, coloca espaço depois do comando
; if (*vStartList != '=' && (vToken < 0xC0 || vToken > 0xEF))
       move.l    D2,A0
       move.b    (A0),D0
       cmp.b     #61,D0
       beq.s     editLine_24
       and.w     #255,D6
       cmp.w     #192,D6
       blo.s     editLine_26
       and.w     #255,D6
       cmp.w     #239,D6
       bls.s     editLine_24
editLine_26:
; vbuf[ix++] = 0x20;
       move.l    (A2),A0
       move.l    D5,D0
       addq.l    #1,D5
       move.b    #32,0(A0,D0.L)
editLine_24:
       bra.s     editLine_27
editLine_14:
; }
; else
; {
; vbuf[ix++] = vToken;
       move.l    (A2),A0
       move.l    D5,D0
       addq.l    #1,D5
       move.b    D6,0(A0,D0.L)
; // Se nao for aspas e o proximo for um token, inclui um espaço
; if (vToken == 0x22 && *vStartList >=0x80)
       cmp.b     #34,D6
       bne.s     editLine_27
       move.l    D2,A0
       move.b    (A0),D0
       and.w     #255,D0
       cmp.w     #128,D0
       blo.s     editLine_27
; vbuf[ix++] = 0x20;            }
       move.l    (A2),A0
       move.l    D5,D0
       addq.l    #1,D5
       move.b    #32,0(A0,D0.L)
editLine_27:
       bra       editLine_11
editLine_13:
; }
; }
; vbuf[ix] = '\0';
       move.l    (A2),A0
       clr.b     0(A0,D5.L)
; // Edita a linha no buffer, usando o inputLine do monitor.c
; vRetInput = inputLine(128,'S'); // S - String Linha Editavel
       pea       83
       pea       128
       jsr       _inputLine
       addq.w    #8,A7
       move.b    D0,D7
; if (*vbuf != 0x00 && (vRetInput == 0x0D || vRetInput == 0x0A))
       move.l    (A2),A0
       move.b    (A0),D0
       beq       editLine_29
       cmp.b     #13,D7
       beq.s     editLine_31
       cmp.b     #10,D7
       bne       editLine_29
editLine_31:
; {
; vLinhaList[ivv++] = 0x20;
       move.l    D4,D0
       addq.l    #1,D4
       move.b    #32,0(A3,D0.L)
; ix = strlen(vbuf);
       move.l    (A2),-(A7)
       jsr       _strlen
       addq.w    #4,A7
       move.l    D0,D5
; for(iz = 0; iz <= ix; iz++)
       clr.l     D3
editLine_32:
       cmp.l     D5,D3
       bgt.s     editLine_34
; vLinhaList[ivv++] = vbuf[iz];
       move.l    (A2),A0
       move.l    D4,D0
       addq.l    #1,D4
       move.b    0(A0,D3.L),0(A3,D0.L)
       addq.l    #1,D3
       bra       editLine_32
editLine_34:
; vLinhaList[ivv] = 0x00;
       clr.b     0(A3,D4.L)
; for(iz = 0; iz <= ivv; iz++)
       clr.l     D3
editLine_35:
       cmp.l     D4,D3
       bgt.s     editLine_37
; vbuf[iz] = vLinhaList[iz];
       move.l    (A2),A0
       move.b    0(A3,D3.L),0(A0,D3.L)
       addq.l    #1,D3
       bra       editLine_35
editLine_37:
; printText("\r\n\0");
       pea       @basic_96.L
       jsr       (A4)
       addq.w    #4,A7
; // Apaga a linha atual
; delLine(pNumber);
       move.l    8(A6),-(A7)
       jsr       _delLine
       addq.w    #4,A7
; // Reinsere a linha editada
; processLine();
       jsr       _processLine
; printText("\r\nOK\0");
       pea       @basic_99.L
       jsr       (A4)
       addq.w    #4,A7
; *vBufReceived = 0x00;
       move.l    _vBufReceived.L,A0
       clr.b     (A0)
; *vbuf = '\0';
       move.l    (A2),A0
       clr.b     (A0)
; printText("\r\n\0");
       pea       @basic_96.L
       jsr       (A4)
       addq.w    #4,A7
       bra.s     editLine_38
editLine_29:
; }
; else if (vRetInput != 0x1B)
       cmp.b     #27,D7
       beq.s     editLine_38
; {
; printText("\r\nAborted !!!\r\n\0");
       pea       @basic_120.L
       jsr       (A4)
       addq.w    #4,A7
editLine_38:
       movem.l   (A7)+,D2/D3/D4/D5/D6/D7/A2/A3/A4/A5
       unlk      A6
       rts
; }
; }
; //-----------------------------------------------------------------------------
; // Sintaxe:
; //      RUN                : Executa o programa a partir da primeira linha do prog
; //      RUN <num>          : Executa a partir da linha <num>
; //-----------------------------------------------------------------------------
; void runProg(unsigned char *pNumber)
; {
       xdef      _runProg
_runProg:
       link      A6,#-608
       movem.l   D2/D3/D4/D5/D6/D7/A2/A3/A4/A5,-(A7)
       lea       _changedPointer.L,A2
       lea       _printText.L,A3
       lea       _vErroProc.L,A4
       lea       _pointerRunProg.L,A5
; // Default rodar desde a primeira linha
; int pIni = 0, ix;
       moveq     #0,D7
; unsigned char *vStartList = pStartProg;
       move.l    _pStartProg.L,D2
; unsigned long vNextList;
; unsigned short vNumLin;
; unsigned int vInt;
; unsigned char vString[255], vTipoRet;
; unsigned long vReal;
; typeInf vRetInf;
; unsigned int vReta;
; char sNumLin [sizeof(short)*8+1];
; char vbuffer [sizeof(long)*8+1];
; unsigned char *vPointerChangedPointer;
; unsigned char *pForStack = forStack;
       move.l    _forStack.L,-24(A6)
; unsigned char sqtdtam[20];
; unsigned char *vTempPointer;
; *nextAddrSimpVar = pStartSimpVar;
       move.l    _nextAddrSimpVar.L,A0
       move.l    _pStartSimpVar.L,(A0)
; *nextAddrArrayVar = pStartArrayVar;
       move.l    _nextAddrArrayVar.L,A0
       move.l    _pStartArrayVar.L,(A0)
; *nextAddrString = pStartString;
       move.l    _nextAddrString.L,A0
       move.l    _pStartString.L,(A0)
; for (ix = 0; ix < 0x2000; ix++)
       clr.l     D3
runProg_1:
       cmp.l     #8192,D3
       bge.s     runProg_3
; *(pStartSimpVar + ix) = 0x00;
       move.l    _pStartSimpVar.L,A0
       clr.b     0(A0,D3.L)
       addq.l    #1,D3
       bra       runProg_1
runProg_3:
; for (ix = 0; ix < 0x6000; ix++)
       clr.l     D3
runProg_4:
       cmp.l     #24576,D3
       bge.s     runProg_6
; *(pStartArrayVar + ix) = 0x00;
       move.l    _pStartArrayVar.L,A0
       clr.b     0(A0,D3.L)
       addq.l    #1,D3
       bra       runProg_4
runProg_6:
; for (ix = 0; ix < 0x800; ix++)
       clr.l     D3
runProg_7:
       cmp.l     #2048,D3
       bge.s     runProg_9
; *(pForStack + ix) = 0x00;
       move.l    -24(A6),A0
       clr.b     0(A0,D3.L)
       addq.l    #1,D3
       bra       runProg_7
runProg_9:
; if (pNumber[0] != 0x00)
       move.l    8(A6),A0
       move.b    (A0),D0
       beq.s     runProg_10
; {
; // rodar desde uma linha especifica
; pIni = atoi(pNumber);
       move.l    8(A6),-(A7)
       jsr       _atoi
       addq.w    #4,A7
       move.l    D0,D7
runProg_10:
; }
; vStartList = findNumberLine(pIni, 0, 0);
       clr.l     -(A7)
       clr.l     -(A7)
       and.l     #65535,D7
       move.l    D7,-(A7)
       jsr       _findNumberLine
       add.w     #12,A7
       move.l    D0,D2
; // Nao achou numero de linha inicial
; if (!vStartList)
       tst.l     D2
       bne.s     runProg_12
; {
; printText("Non-existent line number\r\n\0");
       pea       @basic_116.L
       jsr       (A3)
       addq.w    #4,A7
; return;
       bra       runProg_52
runProg_12:
; }
; vNextList = vStartList;
       move.l    D2,D5
; *ftos=0;
       move.l    _ftos.L,A0
       clr.l     (A0)
; *gtos=0;
       move.l    _gtos.L,A0
       clr.l     (A0)
; *changedPointer = 0;
       move.l    (A2),A0
       clr.l     (A0)
; *vDataPointer = 0;
       move.l    _vDataPointer.L,A0
       clr.l     (A0)
; *randSeed = *(vmfp + Reg_TADR);
       move.l    _vmfp.L,A0
       move.w    _Reg_TADR.L,D0
       and.l     #65535,D0
       move.b    0(A0,D0.L),D0
       and.l     #255,D0
       move.l    _randSeed.L,A0
       move.l    D0,(A0)
; *onErrGoto = 0;
       move.l    _onErrGoto.L,A0
       clr.l     (A0)
; while (1)
runProg_15:
; {
; if (*changedPointer!=0)
       move.l    (A2),A0
       move.l    (A0),D0
       beq.s     runProg_18
; vStartList = *changedPointer;
       move.l    (A2),A0
       move.l    (A0),D2
runProg_18:
; // Guarda proxima posicao
; vNextList = (*(vStartList) << 16) | (*(vStartList + 1) << 8) | *(vStartList + 2);
       move.l    D2,A0
       move.b    (A0),D0
       and.l     #255,D0
       lsl.l     #8,D0
       lsl.l     #8,D0
       move.l    D2,A0
       move.b    1(A0),D1
       and.l     #255,D1
       lsl.l     #8,D1
       or.l      D1,D0
       move.l    D2,A0
       move.b    2(A0),D1
       and.l     #255,D1
       or.l      D1,D0
       move.l    D0,D5
; *nextAddr = vNextList;
       move.l    _nextAddr.L,A0
       move.l    D5,(A0)
; if (vNextList)
       tst.l     D5
       beq       runProg_20
; {
; // Pega numero da linha
; vNumLin = (*(vStartList + 3) << 8) | *(vStartList + 4);
       move.l    D2,A0
       move.b    3(A0),D0
       and.w     #255,D0
       lsl.w     #8,D0
       move.l    D2,A0
       move.b    4(A0),D1
       and.w     #255,D1
       or.w      D1,D0
       move.w    D0,D6
; vStartList += 5;
       addq.l    #5,D2
; // Pega caracter a caracter da linha
; *changedPointer = 0;
       move.l    (A2),A0
       clr.l     (A0)
; *vMaisTokens = 0;
       move.l    _vMaisTokens.L,A0
       clr.b     (A0)
; *vParenteses = 0x00;
       move.l    _vParenteses.L,A0
       clr.b     (A0)
; *vTemIf = 0x00;
       move.l    _vTemIf.L,A0
       clr.b     (A0)
; *vTemThen = 0;
       move.l    _vTemThen.L,A0
       clr.b     (A0)
; *vTemElse = 0;
       move.l    _vTemElse.L,A0
       clr.b     (A0)
; *vTemIfAndOr = 0x00;
       move.l    _vTemIfAndOr.L,A0
       clr.b     (A0)
; vRetInf.tString[0] = 0x00;
       lea       -342(A6),A0
       clr.b     (A0)
; *pointerRunProg = vStartList;
       move.l    (A5),A0
       move.l    D2,(A0)
; *vErroProc = 0;
       move.l    (A4),A0
       clr.w     (A0)
; do
; {
runProg_22:
; readChar();
       jsr       _readChar
; if (*vBufReceived==27)
       move.l    _vBufReceived.L,A0
       move.b    (A0),D0
       cmp.b     #27,D0
       bne       runProg_24
; {
; // volta para modo texto
; #ifndef __TESTE_TOKENIZE__
; if (*vdp_mode != VDP_MODE_TEXT)
       move.l    _vdp_mode.L,A0
       move.b    (A0),D0
       cmp.b     #3,D0
       beq.s     runProg_26
; basText();
       jsr       _basText
runProg_26:
; #endif
; // mostra mensagem de para subita
; printText("\r\nStopped at ");
       pea       @basic_121.L
       jsr       (A3)
       addq.w    #4,A7
; itoa(vNumLin, sNumLin, 10);
       pea       10
       pea       -80(A6)
       and.l     #65535,D6
       move.l    D6,-(A7)
       jsr       _itoa
       add.w     #12,A7
; printText(sNumLin);
       pea       -80(A6)
       jsr       (A3)
       addq.w    #4,A7
; printText("\r\n");
       pea       @basic_96.L
       jsr       (A3)
       addq.w    #4,A7
; // sai do laço
; *nextAddr = 0;
       move.l    _nextAddr.L,A0
       clr.l     (A0)
; break;
       bra       runProg_23
runProg_24:
; }
; *doisPontos = 0;
       move.l    _doisPontos.L,A0
       clr.b     (A0)
; *vParenteses = 0x00;
       move.l    _vParenteses.L,A0
       clr.b     (A0)
; *vInicioSentenca = 1;
       move.l    _vInicioSentenca.L,A0
       move.b    #1,(A0)
; if (*traceOn)
       move.l    _traceOn.L,A0
       tst.b     (A0)
       beq.s     runProg_28
; {
; printText("\r\nExecuting at ");
       pea       @basic_122.L
       jsr       (A3)
       addq.w    #4,A7
; itoa(vNumLin, sNumLin, 10);
       pea       10
       pea       -80(A6)
       and.l     #65535,D6
       move.l    D6,-(A7)
       jsr       _itoa
       add.w     #12,A7
; printText(sNumLin);
       pea       -80(A6)
       jsr       (A3)
       addq.w    #4,A7
; printText("\r\n");
       pea       @basic_96.L
       jsr       (A3)
       addq.w    #4,A7
runProg_28:
; }
; vTempPointer = *pointerRunProg;
       move.l    (A5),A0
       move.l    (A0),D4
; *pointerRunProg = *pointerRunProg + 1;
       move.l    (A5),A0
       addq.l    #1,(A0)
; vReta = executeToken(*vTempPointer);
       move.l    D4,A0
       move.b    (A0),D1
       and.l     #255,D1
       move.l    D1,-(A7)
       jsr       _executeToken
       addq.w    #4,A7
       move.l    D0,-84(A6)
; if (*vErroProc)
       move.l    (A4),A0
       tst.w     (A0)
       beq.s     runProg_30
; {
; if (*onErrGoto == 0)
       move.l    _onErrGoto.L,A0
       move.l    (A0),D0
       bne.s     runProg_32
; break;
       bra       runProg_23
runProg_32:
; *vErroProc = 0;
       move.l    (A4),A0
       clr.w     (A0)
; *changedPointer = *onErrGoto;
       move.l    _onErrGoto.L,A0
       move.l    (A2),A1
       move.l    (A0),(A1)
runProg_30:
; }
; if (*changedPointer!=0)
       move.l    (A2),A0
       move.l    (A0),D0
       beq.s     runProg_36
; {
; vPointerChangedPointer = *changedPointer;
       move.l    (A2),A0
       move.l    (A0),-28(A6)
; if (*vPointerChangedPointer == 0x3A)
       move.l    -28(A6),A0
       move.b    (A0),D0
       cmp.b     #58,D0
       bne.s     runProg_36
; {
; *pointerRunProg = *changedPointer;
       move.l    (A2),A0
       move.l    (A5),A1
       move.l    (A0),(A1)
; *changedPointer = 0;
       move.l    (A2),A0
       clr.l     (A0)
runProg_36:
; }
; }
; vTempPointer = *pointerRunProg;
       move.l    (A5),A0
       move.l    (A0),D4
; if (*vTempPointer != 0x00)
       move.l    D4,A0
       move.b    (A0),D0
       beq       runProg_44
; {
; if (*vTempPointer == 0x3A)
       move.l    D4,A0
       move.b    (A0),D0
       cmp.b     #58,D0
       bne.s     runProg_40
; {
; *doisPontos = 1;
       move.l    _doisPontos.L,A0
       move.b    #1,(A0)
; *pointerRunProg = *pointerRunProg + 1;
       move.l    (A5),A0
       addq.l    #1,(A0)
       bra.s     runProg_44
runProg_40:
; }
; else
; {
; if (*doisPontos && *vTempPointer <= 0x80)
       move.l    _doisPontos.L,A0
       move.b    (A0),D0
       and.l     #255,D0
       beq.s     runProg_42
       move.l    D4,A0
       move.b    (A0),D0
       and.w     #255,D0
       cmp.w     #128,D0
       bhi.s     runProg_42
; {
; // nao faz nada
; }
       bra.s     runProg_44
runProg_42:
; else
; {
; nextToken();
       jsr       _nextToken
; if (*vErroProc) break;
       move.l    (A4),A0
       tst.w     (A0)
       beq.s     runProg_44
       bra.s     runProg_23
runProg_44:
       move.l    _doisPontos.L,A0
       tst.b     (A0)
       bne       runProg_22
runProg_23:
; }
; }
; }
; } while (*doisPontos);
; if (*vErroProc)
       move.l    (A4),A0
       tst.w     (A0)
       beq.s     runProg_46
; {
; #ifndef __TESTE_TOKENIZE__
; if (*vdp_mode != VDP_MODE_TEXT)
       move.l    _vdp_mode.L,A0
       move.b    (A0),D0
       cmp.b     #3,D0
       beq.s     runProg_48
; basText();
       jsr       _basText
runProg_48:
; #endif
; showErrorMessage(*vErroProc, vNumLin);
       and.l     #65535,D6
       move.l    D6,-(A7)
       move.l    (A4),A0
       move.w    (A0),D1
       and.l     #65535,D1
       move.l    D1,-(A7)
       jsr       _showErrorMessage
       addq.w    #8,A7
; break;
       bra.s     runProg_17
runProg_46:
; }
; if (*nextAddr == 0)
       move.l    _nextAddr.L,A0
       move.l    (A0),D0
       bne.s     runProg_50
; break;
       bra.s     runProg_17
runProg_50:
; vNextList = *nextAddr;
       move.l    _nextAddr.L,A0
       move.l    (A0),D5
; vStartList = vNextList;
       move.l    D5,D2
       bra.s     runProg_21
runProg_20:
; }
; else
; break;
       bra.s     runProg_17
runProg_21:
       bra       runProg_15
runProg_17:
; }
; #ifndef __TESTE_TOKENIZE__
; if (*vdp_mode != VDP_MODE_TEXT)
       move.l    _vdp_mode.L,A0
       move.b    (A0),D0
       cmp.b     #3,D0
       beq.s     runProg_52
; basText();
       jsr       _basText
runProg_52:
       movem.l   (A7)+,D2/D3/D4/D5/D6/D7/A2/A3/A4/A5
       unlk      A6
       rts
; #endif
; }
; //-----------------------------------------------------------------------------
; //
; //-----------------------------------------------------------------------------
; void showErrorMessage(unsigned int pError, unsigned int pNumLine)
; {
       xdef      _showErrorMessage
_showErrorMessage:
       link      A6,#-20
       move.l    A2,-(A7)
       lea       _printText.L,A2
; char sNumLin [sizeof(short)*8+1];
; printText("\r\n");
       pea       @basic_96.L
       jsr       (A2)
       addq.w    #4,A7
; printText(listError[pError]);
       move.l    8(A6),D1
       lsl.l     #2,D1
       lea       @basic_listError.L,A0
       move.l    0(A0,D1.L),-(A7)
       jsr       (A2)
       addq.w    #4,A7
; if (pNumLine > 0)
       move.l    12(A6),D0
       cmp.l     #0,D0
       bls.s     showErrorMessage_1
; {
; itoa(pNumLine, sNumLin, 10);
       pea       10
       pea       -18(A6)
       move.l    12(A6),-(A7)
       jsr       _itoa
       add.w     #12,A7
; printText(" at ");
       pea       @basic_123.L
       jsr       (A2)
       addq.w    #4,A7
; printText(sNumLin);
       pea       -18(A6)
       jsr       (A2)
       addq.w    #4,A7
showErrorMessage_1:
; }
; printText(" !\r\n\0");
       pea       @basic_124.L
       jsr       (A2)
       addq.w    #4,A7
; *vErroProc = 0;
       move.l    _vErroProc.L,A0
       clr.w     (A0)
       move.l    (A7)+,A2
       unlk      A6
       rts
; }
; //-----------------------------------------------------------------------------
; //
; //-----------------------------------------------------------------------------
; int executeToken(unsigned char pToken)
; {
       xdef      _executeToken
_executeToken:
       link      A6,#-24
       movem.l   D2/D3/A2/A3,-(A7)
       lea       _basTrig.L,A2
       lea       _basLeftRightMid.L,A3
; char vReta = 0;
       clr.b     D2
; #ifndef __TESTE_TOKENIZE__
; unsigned char *pForStack = forStack;
       move.l    _forStack.L,-24(A6)
; int ix;
; unsigned char sqtdtam[20];
; switch (pToken)
       move.b    11(A6),D0
       and.l     #255,D0
       cmp.l     #178,D0
       beq       executeToken_34
       bhi       executeToken_67
       cmp.l     #143,D0
       beq       executeToken_18
       bhi       executeToken_68
       cmp.l     #135,D0
       beq       executeToken_10
       bhi       executeToken_69
       cmp.l     #130,D0
       beq       executeToken_6
       bhi.s     executeToken_70
       cmp.l     #128,D0
       beq       executeToken_4
       bhi.s     executeToken_71
       tst.l     D0
       beq       executeToken_3
       bra       executeToken_1
executeToken_71:
       cmp.l     #129,D0
       beq       executeToken_5
       bra       executeToken_1
executeToken_70:
       cmp.l     #133,D0
       beq       executeToken_8
       bhi.s     executeToken_72
       cmp.l     #131,D0
       beq       executeToken_7
       bra       executeToken_1
executeToken_72:
       cmp.l     #134,D0
       beq       executeToken_9
       bra       executeToken_1
executeToken_69:
       cmp.l     #139,D0
       beq       executeToken_14
       bhi.s     executeToken_73
       cmp.l     #137,D0
       beq       executeToken_12
       bhi.s     executeToken_74
       cmp.l     #136,D0
       beq       executeToken_11
       bra       executeToken_1
executeToken_74:
       cmp.l     #138,D0
       beq       executeToken_13
       bra       executeToken_1
executeToken_73:
       cmp.l     #141,D0
       beq       executeToken_16
       bhi.s     executeToken_75
       cmp.l     #140,D0
       beq       executeToken_15
       bra       executeToken_1
executeToken_75:
       cmp.l     #142,D0
       beq       executeToken_17
       bra       executeToken_1
executeToken_68:
       cmp.l     #151,D0
       beq       executeToken_26
       bhi       executeToken_76
       cmp.l     #147,D0
       beq       executeToken_22
       bhi.s     executeToken_77
       cmp.l     #145,D0
       beq       executeToken_20
       bhi.s     executeToken_78
       cmp.l     #144,D0
       beq       executeToken_19
       bra       executeToken_1
executeToken_78:
       cmp.l     #146,D0
       beq       executeToken_21
       bra       executeToken_1
executeToken_77:
       cmp.l     #149,D0
       beq       executeToken_24
       bhi.s     executeToken_79
       cmp.l     #148,D0
       beq       executeToken_23
       bra       executeToken_1
executeToken_79:
       cmp.l     #150,D0
       beq       executeToken_25
       bra       executeToken_1
executeToken_76:
       cmp.l     #158,D0
       beq       executeToken_30
       bhi.s     executeToken_80
       cmp.l     #153,D0
       beq       executeToken_28
       bhi.s     executeToken_81
       cmp.l     #152,D0
       beq       executeToken_27
       bra       executeToken_1
executeToken_81:
       cmp.l     #154,D0
       beq       executeToken_29
       bra       executeToken_1
executeToken_80:
       cmp.l     #176,D0
       beq       executeToken_32
       bhi.s     executeToken_82
       cmp.l     #159,D0
       beq       executeToken_31
       bra       executeToken_1
executeToken_82:
       cmp.l     #177,D0
       beq       executeToken_33
       bra       executeToken_1
executeToken_67:
       cmp.l     #224,D0
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
executeToken_11:
; case 0x88:  // STEP - nao faz nada
; vReta = 0;
       clr.b     D2
; break;
       bra       executeToken_108
executeToken_12:
; case 0x89:  // GOTO
; vReta = basGoto();
       jsr       _basGoto
       move.b    D0,D2
; break;
       bra       executeToken_108
executeToken_13:
; case 0x8A:  // GOSUB
; vReta = basGosub();
       jsr       _basGosub
       move.b    D0,D2
; break;
       bra       executeToken_108
executeToken_14:
; case 0x8B:  // RETURN
; vReta = basReturn();
       jsr       _basReturn
       move.b    D0,D2
; break;
       bra       executeToken_108
executeToken_15:
; case 0x8C:  // REM - Ignora todas a linha depois dele
; vReta = 0;
       clr.b     D2
; break;
       bra       executeToken_108
executeToken_16:
; case 0x8D:  // INVERSE
; vReta = basInverse();
       jsr       _basInverse
       move.b    D0,D2
; break;
       bra       executeToken_108
executeToken_17:
; case 0x8E:  // NORMAL
; vReta = basNormal();
       jsr       _basNormal
       move.b    D0,D2
; break;
       bra       executeToken_108
executeToken_18:
; case 0x8F:  // DIM
; vReta = basDim();
       jsr       _basDim
       move.b    D0,D2
; break;
       bra       executeToken_108
executeToken_19:
; case 0x90:  // Nao fax nada, soh teste, pode ser retirado
; vReta = 0;
       clr.b     D2
; break;
       bra       executeToken_108
executeToken_20:
; case 0x91:  // DIM
; vReta = basOnVar();
       jsr       _basOnVar
       move.b    D0,D2
; break;
       bra       executeToken_108
executeToken_21:
; case 0x92:  // Input
; vReta = basInputGet(250);
       pea       250
       jsr       _basInputGet
       addq.w    #4,A7
       move.b    D0,D2
; break;
       bra       executeToken_108
executeToken_22:
; case 0x93:  // Get
; vReta = basInputGet(1);
       pea       1
       jsr       _basInputGet
       addq.w    #4,A7
       move.b    D0,D2
; break;
       bra       executeToken_108
executeToken_23:
; case 0x94:  // vTAB
; vReta = basVtab();
       jsr       _basVtab
       move.b    D0,D2
; break;
       bra       executeToken_108
executeToken_24:
; case 0x95:  // HTAB
; vReta = basHtab();
       jsr       _basHtab
       move.b    D0,D2
; break;
       bra       executeToken_108
executeToken_25:
; case 0x96:  // Home
; clearScr();
       jsr       _clearScr
; break;
       bra       executeToken_108
executeToken_26:
; case 0x97:  // CLEAR - Clear all variables
; for (ix = 0; ix < 0x2000; ix++)
       clr.l     D3
executeToken_98:
       cmp.l     #8192,D3
       bge.s     executeToken_100
; *(pStartSimpVar + ix) = 0x00;
       move.l    _pStartSimpVar.L,A0
       clr.b     0(A0,D3.L)
       addq.l    #1,D3
       bra       executeToken_98
executeToken_100:
; for (ix = 0; ix < 0x6000; ix++)
       clr.l     D3
executeToken_101:
       cmp.l     #24576,D3
       bge.s     executeToken_103
; *(pStartArrayVar + ix) = 0x00;
       move.l    _pStartArrayVar.L,A0
       clr.b     0(A0,D3.L)
       addq.l    #1,D3
       bra       executeToken_101
executeToken_103:
; for (ix = 0; ix < 0x800; ix++)
       clr.l     D3
executeToken_104:
       cmp.l     #2048,D3
       bge.s     executeToken_106
; *(pForStack + ix) = 0x00;
       move.l    -24(A6),A0
       clr.b     0(A0,D3.L)
       addq.l    #1,D3
       bra       executeToken_104
executeToken_106:
; vReta = 0;
       clr.b     D2
; break;
       bra       executeToken_108
executeToken_27:
; case 0x98:  // DATA - Ignora toda a linha depois dele, READ vai ler essa linha
; vReta = 0;
       clr.b     D2
; break;
       bra       executeToken_108
executeToken_28:
; case 0x99:  // Read
; vReta = basRead();
       jsr       _basRead
       move.b    D0,D2
; break;
       bra       executeToken_108
executeToken_29:
; case 0x9A:  // Restore
; vReta = basRestore();
       jsr       _basRestore
       move.b    D0,D2
; break;
       bra       executeToken_108
executeToken_30:
; case 0x9E:  // END
; vReta = basEnd();
       jsr       _basEnd
       move.b    D0,D2
; break;
       bra       executeToken_108
executeToken_31:
; case 0x9F:  // STOP
; vReta = basStop();
       jsr       _basStop
       move.b    D0,D2
; break;
       bra       executeToken_108
executeToken_32:
; case 0xB0:  // TEXT
; vReta = basText();
       jsr       _basText
       move.b    D0,D2
; break;
       bra       executeToken_108
executeToken_33:
; case 0xB1:  // GR
; vReta = basGr();
       jsr       _basGr
       move.b    D0,D2
; break;
       bra       executeToken_108
executeToken_34:
; case 0xB2:  // HGR
; vReta = basHgr();
       jsr       _basHgr
       move.b    D0,D2
; break;
       bra       executeToken_108
executeToken_35:
; case 0xB3:  // COLOR
; vReta = basColor();
       jsr       _basColor
       move.b    D0,D2
; break;
       bra       executeToken_108
executeToken_36:
; case 0xB4:  // PLOT
; vReta = basPlot();
       jsr       _basPlot
       move.b    D0,D2
; break;
       bra       executeToken_108
executeToken_37:
; case 0xB5:  // HLIN
; vReta = basHVlin(1);
       pea       1
       jsr       _basHVlin
       addq.w    #4,A7
       move.b    D0,D2
; break;
       bra       executeToken_108
executeToken_38:
; case 0xB6:  // VLIN
; vReta = basHVlin(2);
       pea       2
       jsr       _basHVlin
       addq.w    #4,A7
       move.b    D0,D2
; break;
       bra       executeToken_108
executeToken_39:
; case 0xB8:  // HCOLOR
; vReta = basHcolor();
       jsr       _basHcolor
       move.b    D0,D2
; break;
       bra       executeToken_108
executeToken_40:
; case 0xB9:  // HPLOT
; vReta = basHplot();
       jsr       _basHplot
       move.b    D0,D2
; break;
       bra       executeToken_108
executeToken_41:
; case 0xBA:  // AT - Nao faz nada
; vReta = 0;
       clr.b     D2
; break;
       bra       executeToken_108
executeToken_42:
; case 0xBB:  // ONERR
; vReta = basOnErr();
       jsr       _basOnErr
       move.b    D0,D2
; break;
       bra       executeToken_108
executeToken_43:
; case 0xC4:  // ASC
; vReta = basAsc();
       jsr       _basAsc
       move.b    D0,D2
; break;
       bra       executeToken_108
executeToken_44:
; case 0xCD:  // PEEK
; vReta = basPeekPoke('R');
       pea       82
       jsr       _basPeekPoke
       addq.w    #4,A7
       move.b    D0,D2
; break;
       bra       executeToken_108
executeToken_45:
; case 0xCE:  // POKE
; vReta = basPeekPoke('W');
       pea       87
       jsr       _basPeekPoke
       addq.w    #4,A7
       move.b    D0,D2
; break;
       bra       executeToken_108
executeToken_46:
; case 0xD1:  // RND
; vReta = basRnd();
       jsr       _basRnd
       move.b    D0,D2
; break;
       bra       executeToken_108
executeToken_47:
; case 0xDB:  // Len
; vReta = basLen();
       jsr       _basLen
       move.b    D0,D2
; break;
       bra       executeToken_108
executeToken_48:
; case 0xDC:  // Val
; vReta = basVal();
       jsr       _basVal
       move.b    D0,D2
; break;
       bra       executeToken_108
executeToken_49:
; case 0xDD:  // Str$
; vReta = basStr();
       jsr       _basStr
       move.b    D0,D2
; break;
       bra       executeToken_108
executeToken_50:
; case 0xE0:  // SCRN
; vReta = basScrn();
       jsr       _basScrn
       move.b    D0,D2
; break;
       bra       executeToken_108
executeToken_51:
; case 0xE1:  // Chr$
; vReta = basChr();
       jsr       _basChr
       move.b    D0,D2
; break;
       bra       executeToken_108
executeToken_52:
; case 0xE2:  // Fre(0)
; vReta = basFre();
       jsr       _basFre
       move.b    D0,D2
; break;
       bra       executeToken_108
executeToken_53:
; case 0xE3:  // Sqrt
; vReta = basTrig(6);
       pea       6
       jsr       (A2)
       addq.w    #4,A7
       move.b    D0,D2
; break;
       bra       executeToken_108
executeToken_54:
; case 0xE4:  // Sin
; vReta = basTrig(1);
       pea       1
       jsr       (A2)
       addq.w    #4,A7
       move.b    D0,D2
; break;
       bra       executeToken_108
executeToken_55:
; case 0xE5:  // Cos
; vReta = basTrig(2);
       pea       2
       jsr       (A2)
       addq.w    #4,A7
       move.b    D0,D2
; break;
       bra       executeToken_108
executeToken_56:
; case 0xE6:  // Tan
; vReta = basTrig(3);
       pea       3
       jsr       (A2)
       addq.w    #4,A7
       move.b    D0,D2
; break;
       bra       executeToken_108
executeToken_57:
; case 0xE7:  // Log
; vReta = basTrig(4);
       pea       4
       jsr       (A2)
       addq.w    #4,A7
       move.b    D0,D2
; break;
       bra       executeToken_108
executeToken_58:
; case 0xE8:  // Exp
; vReta = basTrig(5);
       pea       5
       jsr       (A2)
       addq.w    #4,A7
       move.b    D0,D2
; break;
       bra       executeToken_108
executeToken_59:
; case 0xE9:  // SPC
; vReta = basSpc();
       jsr       _basSpc
       move.b    D0,D2
; break;
       bra       executeToken_108
executeToken_60:
; case 0xEA:  // Tab
; vReta = basTab();
       jsr       _basTab
       move.b    D0,D2
; break;
       bra       executeToken_108
executeToken_61:
; case 0xEB:  // Mid$
; vReta = basLeftRightMid('M');
       pea       77
       jsr       (A3)
       addq.w    #4,A7
       move.b    D0,D2
; break;
       bra       executeToken_108
executeToken_62:
; case 0xEC:  // Right$
; vReta = basLeftRightMid('R');
       pea       82
       jsr       (A3)
       addq.w    #4,A7
       move.b    D0,D2
; break;
       bra       executeToken_108
executeToken_63:
; case 0xED:  // Left$
; vReta = basLeftRightMid('L');
       pea       76
       jsr       (A3)
       addq.w    #4,A7
       move.b    D0,D2
; break;
       bra       executeToken_108
executeToken_64:
; case 0xEE:  // INT
; vReta = basInt();
       jsr       _basInt
       move.b    D0,D2
; break;
       bra.s     executeToken_108
executeToken_65:
; case 0xEF:  // ABS
; vReta = basAbs();
       jsr       _basAbs
       move.b    D0,D2
; break;
       bra.s     executeToken_108
executeToken_1:
; default:
; if (pToken < 0x80)  // variavel sem LET
       move.b    11(A6),D0
       and.w     #255,D0
       cmp.w     #128,D0
       bhs.s     executeToken_107
; {
; *pointerRunProg = *pointerRunProg - 1;
       move.l    _pointerRunProg.L,A0
       subq.l    #1,(A0)
; vReta = basLet();
       jsr       _basLet
       move.b    D0,D2
       bra.s     executeToken_108
executeToken_107:
; }
; else // Nao forem operadores logicos
; {
; *vErroProc = 14;
       move.l    _vErroProc.L,A0
       move.w    #14,(A0)
; vReta = 14;
       moveq     #14,D2
executeToken_108:
; }
; }
; #endif
; return vReta;
       ext.w     D2
       ext.l     D2
       move.l    D2,D0
       movem.l   (A7)+,D2/D3/A2/A3
       unlk      A6
       rts
; }
; //--------------------------------------------------------------------------------------
; //
; //--------------------------------------------------------------------------------------
; int nextToken(void)
; {
       xdef      _nextToken
_nextToken:
       link      A6,#-28
       movem.l   D2/D3/A2/A3/A4/A5,-(A7)
       lea       _token_type.L,A2
       lea       _pointerRunProg.L,A3
       lea       _token.L,A4
       lea       _tok.L,A5
; unsigned char *temp;
; int vRet, ccc;
; unsigned char sqtdtam[20];
; unsigned char *vTempPointer;
; *token_type = 0;
       move.l    (A2),A0
       clr.b     (A0)
; *tok = 0;
       move.l    (A5),A0
       clr.b     (A0)
; temp = token;
       move.l    (A4),D3
; vTempPointer = *pointerRunProg;
       move.l    (A3),A0
       move.l    (A0),D2
; if (*vTempPointer >= 0x80 && *vTempPointer < 0xF0)   // is a command
       move.l    D2,A0
       move.b    (A0),D0
       and.w     #255,D0
       cmp.w     #128,D0
       blo       nextToken_1
       move.l    D2,A0
       move.b    (A0),D0
       and.w     #255,D0
       cmp.w     #240,D0
       bhs.s     nextToken_1
; {
; *tok = *vTempPointer;
       move.l    D2,A0
       move.l    (A5),A1
       move.b    (A0),(A1)
; *token_type = COMMAND;
       move.l    (A2),A0
       move.b    #4,(A0)
; *token = *vTempPointer;
       move.l    D2,A0
       move.l    (A4),A1
       move.b    (A0),(A1)
; *(token + 1) = 0x00;
       move.l    (A4),A0
       clr.b     1(A0)
; return *token_type;
       move.l    (A2),A0
       move.b    (A0),D0
       and.l     #255,D0
       bra       nextToken_3
nextToken_1:
; }
; if (*vTempPointer == '\0') { // end of file
       move.l    D2,A0
       move.b    (A0),D0
       bne.s     nextToken_4
; *token = 0;
       move.l    (A4),A0
       clr.b     (A0)
; *tok = FINISHED;
       move.l    (A5),A0
       move.b    #224,(A0)
; *token_type = DELIMITER;
       move.l    (A2),A0
       move.b    #1,(A0)
; return *token_type;
       move.l    (A2),A0
       move.b    (A0),D0
       and.l     #255,D0
       bra       nextToken_3
nextToken_4:
; }
; while(iswhite(*vTempPointer)) // skip over white space
nextToken_6:
       move.l    D2,A0
       move.b    (A0),D1
       and.l     #255,D1
       move.l    D1,-(A7)
       jsr       _iswhite
       addq.w    #4,A7
       tst.l     D0
       beq.s     nextToken_8
; {
; *pointerRunProg = *pointerRunProg + 1;
       move.l    (A3),A0
       addq.l    #1,(A0)
; vTempPointer = *pointerRunProg;
       move.l    (A3),A0
       move.l    (A0),D2
       bra       nextToken_6
nextToken_8:
; }
; if (*vTempPointer == '\r') { // crlf
       move.l    D2,A0
       move.b    (A0),D0
       cmp.b     #13,D0
       bne       nextToken_9
; *pointerRunProg = *pointerRunProg + 2;
       move.l    (A3),A0
       addq.l    #2,(A0)
; *tok = EOL;
       move.l    (A5),A0
       move.b    #226,(A0)
; *token = '\r';
       move.l    (A4),A0
       move.b    #13,(A0)
; *(token + 1) = '\n';
       move.l    (A4),A0
       move.b    #10,1(A0)
; *(token + 2) = 0;
       move.l    (A4),A0
       clr.b     2(A0)
; *token_type = DELIMITER;
       move.l    (A2),A0
       move.b    #1,(A0)
; return *token_type;
       move.l    (A2),A0
       move.b    (A0),D0
       and.l     #255,D0
       bra       nextToken_3
nextToken_9:
; }
; if (strchr("+-*^/=;:,><", *vTempPointer) || *vTempPointer >= 0xF0) { // delimiter
       move.l    D2,A0
       move.b    (A0),D1
       and.l     #255,D1
       move.l    D1,-(A7)
       pea       @basic_125.L
       jsr       _strchr
       addq.w    #8,A7
       tst.l     D0
       bne.s     nextToken_13
       move.l    D2,A0
       move.b    (A0),D0
       and.w     #255,D0
       cmp.w     #240,D0
       blo.s     nextToken_14
       moveq     #1,D0
       bra.s     nextToken_15
nextToken_14:
       clr.l     D0
nextToken_15:
       ext.l     D0
       tst.l     D0
       beq.s     nextToken_11
nextToken_13:
; *temp = *vTempPointer;
       move.l    D2,A0
       move.l    D3,A1
       move.b    (A0),(A1)
; *pointerRunProg = *pointerRunProg + 1; // advance to next position
       move.l    (A3),A0
       addq.l    #1,(A0)
; temp++;
       addq.l    #1,D3
; *temp = 0;
       move.l    D3,A0
       clr.b     (A0)
; *token_type = DELIMITER;
       move.l    (A2),A0
       move.b    #1,(A0)
; return *token_type;
       move.l    (A2),A0
       move.b    (A0),D0
       and.l     #255,D0
       bra       nextToken_3
nextToken_11:
; }
; if (*vTempPointer == 0x28 || *vTempPointer == 0x29)
       move.l    D2,A0
       move.b    (A0),D0
       cmp.b     #40,D0
       beq.s     nextToken_18
       move.l    D2,A0
       move.b    (A0),D0
       cmp.b     #41,D0
       bne       nextToken_16
nextToken_18:
; {
; if (*vTempPointer == 0x28)
       move.l    D2,A0
       move.b    (A0),D0
       cmp.b     #40,D0
       bne.s     nextToken_19
; *token_type = OPENPARENT;
       move.l    (A2),A0
       move.b    #8,(A0)
       bra.s     nextToken_20
nextToken_19:
; else
; *token_type = CLOSEPARENT;
       move.l    (A2),A0
       move.b    #9,(A0)
nextToken_20:
; *token = *vTempPointer;
       move.l    D2,A0
       move.l    (A4),A1
       move.b    (A0),(A1)
; *(token + 1) = 0x00;
       move.l    (A4),A0
       clr.b     1(A0)
; *pointerRunProg = *pointerRunProg + 1;
       move.l    (A3),A0
       addq.l    #1,(A0)
; return *token_type;
       move.l    (A2),A0
       move.b    (A0),D0
       and.l     #255,D0
       bra       nextToken_3
nextToken_16:
; }
; if (*vTempPointer == ":")
       move.l    D2,A0
       move.b    (A0),D0
       and.l     #255,D0
       lea       @basic_126.L,A0
       cmp.l     A0,D0
       bne.s     nextToken_21
; {
; *doisPontos = 1;
       move.l    _doisPontos.L,A0
       move.b    #1,(A0)
; *token_type = DOISPONTOS;
       move.l    (A2),A0
       move.b    #7,(A0)
; return *token_type;
       move.l    (A2),A0
       move.b    (A0),D0
       and.l     #255,D0
       bra       nextToken_3
nextToken_21:
; }
; if (*vTempPointer == '"') { // quoted string
       move.l    D2,A0
       move.b    (A0),D0
       cmp.b     #34,D0
       bne       nextToken_23
; *pointerRunProg = *pointerRunProg + 1;
       move.l    (A3),A0
       addq.l    #1,(A0)
; vTempPointer = *pointerRunProg;
       move.l    (A3),A0
       move.l    (A0),D2
; while(*vTempPointer != '"'&& *vTempPointer != '\r')
nextToken_25:
       move.l    D2,A0
       move.b    (A0),D0
       cmp.b     #34,D0
       beq.s     nextToken_27
       move.l    D2,A0
       move.b    (A0),D0
       cmp.b     #13,D0
       beq.s     nextToken_27
; {
; *temp++ = *vTempPointer;
       move.l    D2,A0
       move.l    D3,A1
       addq.l    #1,D3
       move.b    (A0),(A1)
; *pointerRunProg = *pointerRunProg + 1;
       move.l    (A3),A0
       addq.l    #1,(A0)
; vTempPointer = *pointerRunProg;
       move.l    (A3),A0
       move.l    (A0),D2
       bra       nextToken_25
nextToken_27:
; }
; if (*vTempPointer == '\r')
       move.l    D2,A0
       move.b    (A0),D0
       cmp.b     #13,D0
       bne.s     nextToken_28
; {
; *vErroProc = 14;
       move.l    _vErroProc.L,A0
       move.w    #14,(A0)
; return 0;
       clr.l     D0
       bra       nextToken_3
nextToken_28:
; }
; *pointerRunProg = *pointerRunProg + 1;
       move.l    (A3),A0
       addq.l    #1,(A0)
; *temp = 0;
       move.l    D3,A0
       clr.b     (A0)
; *token_type = QUOTE;
       move.l    (A2),A0
       move.b    #6,(A0)
; return *token_type;
       move.l    (A2),A0
       move.b    (A0),D0
       and.l     #255,D0
       bra       nextToken_3
nextToken_23:
; }
; if (isdigitus(*vTempPointer)) { // number
       move.l    D2,A0
       move.b    (A0),D1
       and.l     #255,D1
       move.l    D1,-(A7)
       jsr       _isdigitus
       addq.w    #4,A7
       tst.l     D0
       beq       nextToken_30
; while(!isdelim(*vTempPointer) && (*vTempPointer < 0x80 || *vTempPointer >= 0xF0))
nextToken_32:
       move.l    D2,A0
       move.b    (A0),D1
       and.l     #255,D1
       move.l    D1,-(A7)
       jsr       _isdelim
       addq.w    #4,A7
       tst.l     D0
       bne       nextToken_34
       move.l    D2,A0
       move.b    (A0),D0
       and.w     #255,D0
       cmp.w     #128,D0
       blo.s     nextToken_35
       move.l    D2,A0
       move.b    (A0),D0
       and.w     #255,D0
       cmp.w     #240,D0
       blo.s     nextToken_34
nextToken_35:
; {
; *temp++ = *vTempPointer;
       move.l    D2,A0
       move.l    D3,A1
       addq.l    #1,D3
       move.b    (A0),(A1)
; *pointerRunProg = *pointerRunProg + 1;
       move.l    (A3),A0
       addq.l    #1,(A0)
; vTempPointer = *pointerRunProg;
       move.l    (A3),A0
       move.l    (A0),D2
       bra       nextToken_32
nextToken_34:
; }
; *temp = '\0';
       move.l    D3,A0
       clr.b     (A0)
; *token_type = NUMBER;
       move.l    (A2),A0
       move.b    #3,(A0)
; return *token_type;
       move.l    (A2),A0
       move.b    (A0),D0
       and.l     #255,D0
       bra       nextToken_3
nextToken_30:
; }
; if (isalphas(*vTempPointer)) { // var or command
       move.l    D2,A0
       move.b    (A0),D1
       and.l     #255,D1
       move.l    D1,-(A7)
       jsr       _isalphas
       addq.w    #4,A7
       tst.l     D0
       beq       nextToken_36
; while(!isdelim(*vTempPointer) && (*vTempPointer < 0x80 || *vTempPointer >= 0xF0))
nextToken_38:
       move.l    D2,A0
       move.b    (A0),D1
       and.l     #255,D1
       move.l    D1,-(A7)
       jsr       _isdelim
       addq.w    #4,A7
       tst.l     D0
       bne       nextToken_40
       move.l    D2,A0
       move.b    (A0),D0
       and.w     #255,D0
       cmp.w     #128,D0
       blo.s     nextToken_41
       move.l    D2,A0
       move.b    (A0),D0
       and.w     #255,D0
       cmp.w     #240,D0
       blo.s     nextToken_40
nextToken_41:
; {
; *temp++ = *vTempPointer;
       move.l    D2,A0
       move.l    D3,A1
       addq.l    #1,D3
       move.b    (A0),(A1)
; *pointerRunProg = *pointerRunProg + 1;
       move.l    (A3),A0
       addq.l    #1,(A0)
; vTempPointer = *pointerRunProg;
       move.l    (A3),A0
       move.l    (A0),D2
       bra       nextToken_38
nextToken_40:
; }
; *temp = '\0';
       move.l    D3,A0
       clr.b     (A0)
; *token_type = VARIABLE;
       move.l    (A2),A0
       move.b    #2,(A0)
; return *token_type;
       move.l    (A2),A0
       move.b    (A0),D0
       and.l     #255,D0
       bra.s     nextToken_3
nextToken_36:
; }
; *temp = '\0';
       move.l    D3,A0
       clr.b     (A0)
; // see if a string is a command or a variable
; if (*token_type == STRING) {
       move.l    (A2),A0
       move.b    (A0),D0
       cmp.b     #5,D0
       bne.s     nextToken_42
; *token_type = VARIABLE;
       move.l    (A2),A0
       move.b    #2,(A0)
nextToken_42:
; }
; return *token_type;
       move.l    (A2),A0
       move.b    (A0),D0
       and.l     #255,D0
nextToken_3:
       movem.l   (A7)+,D2/D3/A2/A3/A4/A5
       unlk      A6
       rts
; }
; //-----------------------------------------------------------------------------
; //
; //-----------------------------------------------------------------------------
; int findToken(unsigned char pToken)
; {
       xdef      _findToken
_findToken:
       link      A6,#0
       move.l    D2,-(A7)
; unsigned char kt;
; // Procura o Token na lista e devolve a posicao
; for(kt = 0; kt < keywords_count; kt++)
       clr.b     D2
findToken_1:
       and.l     #255,D2
       cmp.l     _keywords_count.L,D2
       bhs.s     findToken_3
; {
; if (keywords[kt].token == pToken)
       and.l     #255,D2
       move.l    D2,D0
       lsl.l     #3,D0
       lea       @basic_keywords.L,A0
       add.l     D0,A0
       move.b    11(A6),D0
       and.l     #255,D0
       cmp.l     4(A0),D0
       bne.s     findToken_4
; return kt;
       and.l     #255,D2
       move.l    D2,D0
       bra.s     findToken_6
findToken_4:
       addq.b    #1,D2
       bra       findToken_1
findToken_3:
; }
; // Procura o Token nas operacões de 1 char
; /*for(kt = 0; kt < keywordsUnique_count; kt++)
; {
; if (keywordsUnique[kt].token == pToken)
; return (kt + 0x80);
; }*/
; return 14;
       moveq     #14,D0
findToken_6:
       move.l    (A7)+,D2
       unlk      A6
       rts
; }
; //-----------------------------------------------------------------------------
; //
; //-----------------------------------------------------------------------------
; unsigned long findNumberLine(unsigned short pNumber, unsigned char pTipoRet, unsigned char pTipoFind)
; {
       xdef      _findNumberLine
_findNumberLine:
       link      A6,#-36
       movem.l   D2/D3/D4/D5,-(A7)
       move.w    10(A6),D4
       and.l     #65535,D4
; unsigned char *vStartList = *addrFirstLineNumber;
       move.l    _addrFirstLineNumber.L,A0
       move.l    (A0),D2
; unsigned char *vLastList = *addrFirstLineNumber;
       move.l    _addrFirstLineNumber.L,A0
       move.l    (A0),D5
; unsigned short vNumber = 0;
       clr.w     D3
; char vbuffer [sizeof(long)*8+1];
; if (pNumber)
       tst.w     D4
       beq       findNumberLine_5
; {
; while(vStartList)
findNumberLine_3:
       tst.l     D2
       beq       findNumberLine_5
; {
; vNumber = ((*(vStartList + 3) << 8) | *(vStartList + 4));
       move.l    D2,A0
       move.b    3(A0),D0
       and.w     #255,D0
       lsl.w     #8,D0
       move.l    D2,A0
       move.b    4(A0),D1
       and.w     #255,D1
       or.w      D1,D0
       move.w    D0,D3
; if ((!pTipoFind && vNumber < pNumber) || (pTipoFind && vNumber != pNumber))
       tst.b     19(A6)
       bne.s     findNumberLine_10
       moveq     #1,D0
       bra.s     findNumberLine_11
findNumberLine_10:
       clr.l     D0
findNumberLine_11:
       and.l     #255,D0
       beq.s     findNumberLine_9
       cmp.w     D4,D3
       blo.s     findNumberLine_8
findNumberLine_9:
       move.b    19(A6),D0
       and.l     #255,D0
       beq       findNumberLine_6
       cmp.w     D4,D3
       beq       findNumberLine_6
findNumberLine_8:
; {
; vLastList = vStartList;
       move.l    D2,D5
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
