moahrs/MMSJ300OS/(commit log)

2024-01-25 3rd commit
    [lista mat.csv]
2024-01-25 21th commit
    [GRAVADOR_FLASH_EEPROM_SERIAL.dch, GRAVADOR_FLASH_EEPROM_SERIAL.dip, MMSJ300A_CPU.dch, MMSJ300A_MEM_RAM_STATIC.dch, MMSJ300A_MEM_ROM.dch, MMSJ300A_PERIF.dch, MMSJ300B_CPU.dch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]
2024-01-25 22th commit
    [CPU_BoardOutline.gbr, CPU_Bottom.gbr, CPU_Top.gbr, Perif_BoardOutline.gbr, Perif_Bottom.gbr, Perif_Top.gbr, VDG_BoardOutline.gbr, VDG_Bottom.gbr]
2024-01-25 23th commit
    [lista_mat.csv, lista_mat.xlsx]
